JoanMaillard/Manette/04_Etude/2019/rapport de décision module Bluetooth.txt

MAILLARD Joan, KAHRIMANOVIC Adel
25.06.2019
P1704 Manette

Rapport de choix de protocole et de module Bluetooth:

Au choix: 
- Module Cypress en Bluetooth 4.1 en mode kiss
- Module Seeed en Bluetooth 2.0 + EDR avec appairage en dur
- ESP32 en Bluetooth 4.1 en mode appairage dur / Wifi 

Avantages du Cypress
- Appairage facile et rapide
- Data rate plus grand, permettant une marge pour la transmission des données supérieures (quoique notre utilisation reste faible)
- Faible consommation car en mode low energy

Désavantages du Cypress
- L'appairage Kiss présente une difficulté supplémentaire quant à la mise en place: il est possible que le module s'appaire avec le mauvais périphérique
- Le module et la devboard sont d'une taille non-négligeable
- Le module et la devboard sont basés sur une architecture ARM avec des Cortex-M0, et non avec des processeurs d'architecture AVR comme on les connaît.
- On pressent une probable incompatibilité des modules Cypress avec les autres à notre disposition
- Module Cypress cher

Avantages du Seeed
- Appairage solide, donc en cas de perte de connection, puis rentrée à portée à nouveau, elle est immédiatement rétablie, ou au moins retentée
- Data rate plus stable et portée légèrement plus grande
- Très petite taille et facilité d'utilisation (périphérique MOSI/MISO)
- Compatible Arduino sans interface spécifique

Désavantages du Seeed
- Bluetooth 2.0 avec EDR -> appairage plus compliqué / long à réaliser
- Data rate un peu plus faible, mais dans les limites du raisonnable (sans compter que notre utilisation est de toute façon faible)
- Consomme potentiellement un peu plus que le module en 4.1, mais avec une batterie de taille suffisante, ce problème disparaît.
- Occupe des pins MOSI/MISO de l'AtMega et le charge des capteurs ET des de la gestion du Bluetooth

Avantages de l'ESP
- Appairage solide
- Data rate très stable car 
- nous permet de déporter la communication de la lecture des éléments
- Module 4.1 SPP -> module half-duplex rapide pour la communication et technologie commune actuelle
- Architecture connue (AVR), comme les arduinos
- Permet de dédier la gestion de l'écran et des moteurs de rumble directement sans sacrifier de la réactivité sur l'arduino de data gathering

Désavantages de l'ESP
- Consommation d'énergie globale potentiellement plus grande (module dédié supplémentaire)
- Prend un peu de place, mais moins qu'un arduino appairé à un chip unique AtMega
- Occupe des pins MOSI/MISO de l'AtMega, sans en prendre plus pour autant

Notre choix se porte sur le module ESP.
