JoanMaillard/Manette/ESP32.pptx

## L’esp32

P1704 Adel Kahrimanovic et Joan Maillard

## Sommaire

- Qu’est-ce qu’un «ESP32»?
- Comparaison avec un Arduino Due
- Schéma de l’ESP32
- Questions?

## Qu’est-ce qu’un «ESP32»?

- L’ESP32 est un microcontrôleur
- Compatible avec l’IDE Arduino

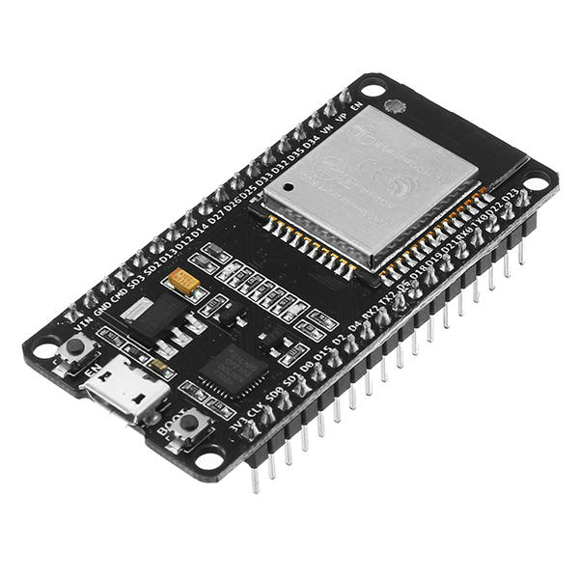
[picture p9: figure]

## Comparaison avec un Arduino Uno

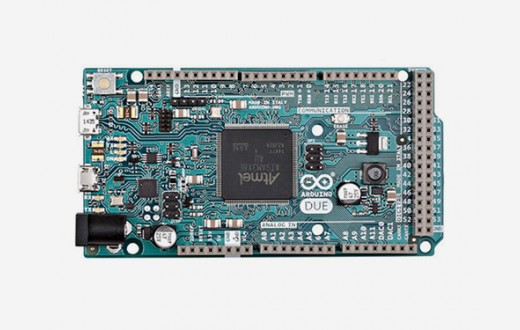
[picture p10: figure]

VS

## Comparaison avec un Arduino DUE

| ESP32 | Arduino Due
Tension de travail | +3,3V | +3,3V
Bluetooth et Wifi | Oui | Non
Unités de calcul | 2 | 1
Fréquence d’horloge | 160MHz | 84MHz
Pins ADC | 18 | 12
Pins DAC | 2 | 2
Prix (Conrad) | 12.- | 36.-

## SCHéma de l’esp32

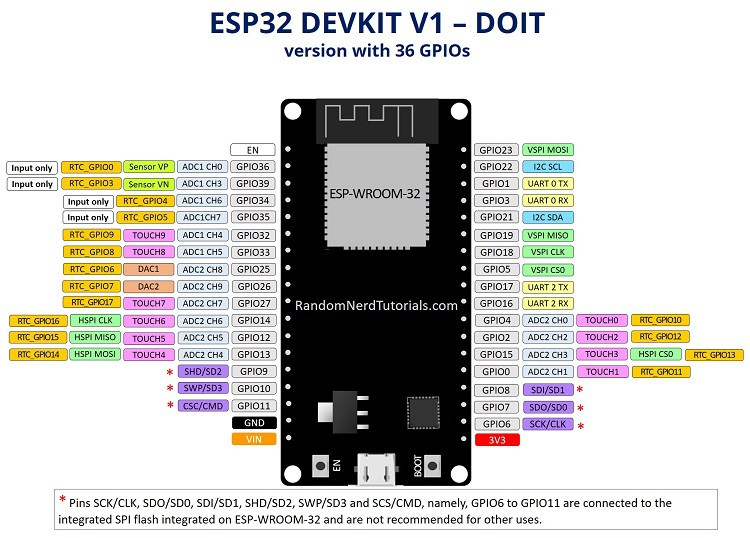
[picture p11: figure]

## Questions?
