JoanMaillard/Manette/04_Etude/Manette arcade.docx

CPNV

Manette arcade

P1704_Manettes

SANDOZ Pierre-Olivier PICOTTE Alexandre

01/07/2018

# Introduction :

Le code de la manette arcade se compose d’un code, qui gère les boutons appuyés (slave), à fournir aux manettes et d’un code à fournir à un arduino leonardo ou micro qui se charge de simuler un clavier lorsqu’il est branché à un ordinateur ou un raspberry (master). Les manettes ont le code qui gère les boutons, le code pour leonardo ou micro se charge de récupérer les données des manettes pour les convertir en touche de clavier pour pouvoir jouer à des jeux rétros, il s’agit de l’arduino de la « console ». La communication entre les arduinos se fait par I2C, par le biais de la libraire Wire.

# Header et communication I2C :

La communication se fait par I2C et pour vérifier que les différents arduinos reçoivent bien des instructions ou des requêtes nous avons ajouté un header au début de chaque communication. Celui-ci intervient comme un mot de passe que les arduinos doivent donner pour transmettre des informations, un arduino qui reçoit une communication va vérifier si les deux premières bytes correspondent au header choisi, si oui alors l’arduino traite les données qu’il reçoit si non il ignore ces données.

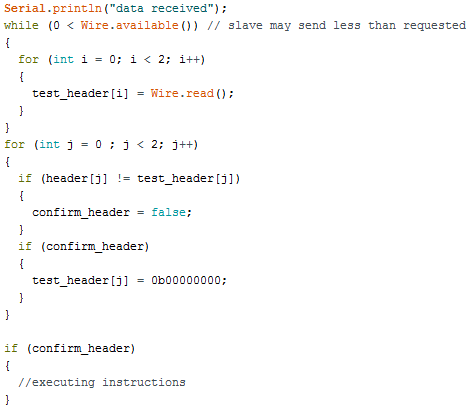
[picture p20: figure]

# Code Manette :

## Recherche d’addresse :

Lors de sa mise sous tension, l’arduino, dans lequel on a téléversé le code qui gère les boutons, va chercher à obtenir une adresse auprès de son master l’arduino de la console, tant qu’il n’a pas d’adresse il va envoyer en permanence une demande par I2C, il y à alors trois cas possibles :

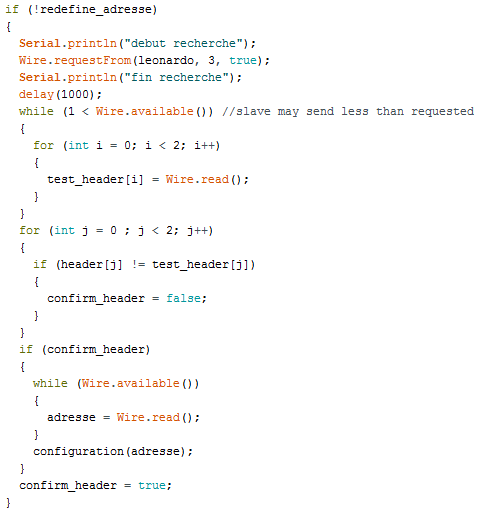
[picture p21: figure]

1. Le master ne répond pas, dans ce cas le slave va continuer à effectuer des demandes d’adresse
2. Le master lui donne une adresse de joueurs actifs, soit 1 soit 2, le slave refait alors son setup avec sa nouvelle adresse

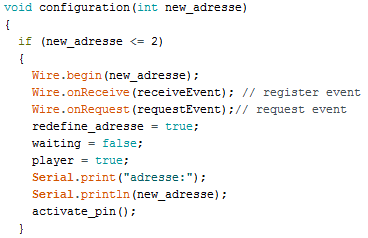
[picture p22: figure]

3. Le master lui donne l’adresse lorsqu’il y a trop de joueurs, le slave va alors arrêter de faire des demandes, Si une place se libère le master enverra un message au slave pour lui demander de refaire une demande d’adresse.

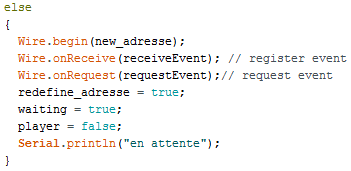
[picture p23: figure]

Ce n’est que lorsque le slave reçoit une adresse de joueurs actifs que le reste du programme va se lancer, notamment l’activation de ces inputs.

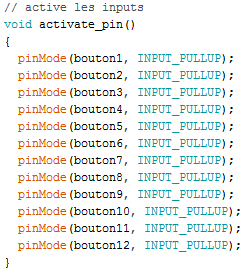
[picture p24: figure]

## Gestion des touches :

Lorsque l’arduino est un joueur actif, il va alors lancer le reste de son programme, qui consiste à attendre une demande du master pour regarder quelles sont ses boutons enclenchés.

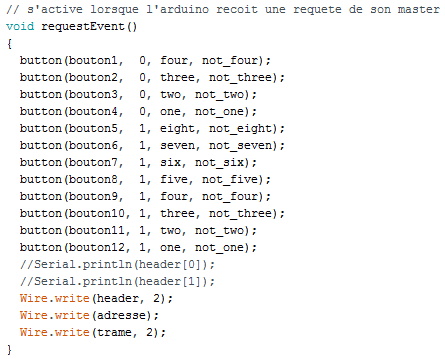
[picture p25: figure]

Lors d’une demande le slave va regarder chaque input déclaré et regarder si l’input est LOW ou HIGH, il va ainsi composer deux bytes d’informations qui contient les états de tous les boutons.

On n’a que 12 boutons donc on utilise que 12 bits, dans notre il s’agit des bits entourés en orange.

A chaque bit de chaque byte est assigné un bouton et selon son état le bit vaut 0 ou 1, 1pour appuyé sinon 0. Cette gestion se fait au moyen de la fonction button.

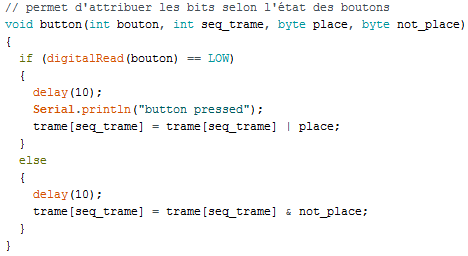
[picture p26: figure]

- bouton = quel bouton il faut regarder l’état
- seq_trame = s’il s’agit du premier ou deuxième byte de la trame
- place = aide pour mettre le bit désirer à 1 si bouton est LOW
- not_place = aide pour mettre le bit désirer à 0 si bouton est HIGH

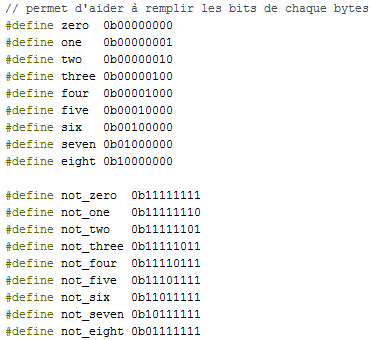
[picture p27: figure]

# Code console :

Le code console va s’occuper de gérer les joueurs, demander aux slaves l’état de leurs boutons ainsi que simuler un clavier et transmettre des touches de clavier selon l’état des boutons des joueurs

## Attribution d’adresse :

Le code du master ne commence réellement que lorsqu’il enregistre au moins un joueur, donc lors de sa mise sous tension il va attendre une demande d’un slave pour lui transmettre une adresse, s’il y a déjà trop de joueurs alors le master va mettre les joueurs de trop en attente et lorsqu’une place se libère leur enverra un message pour leur demander de refaire leur demande d’adresse. Les joueurs actifs ont les adresse 1 et 2. L’attribution d’adresse passe par la fonction requestEvent.

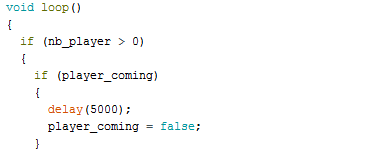
[picture p28: figure]

…

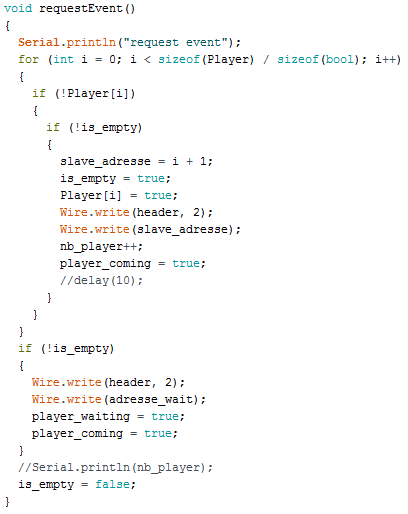
[picture p29: figure]

## Requête au slave :

Dès que le master a au moins un slave il va alors émettre des requêtes auprès du slave pour lui demander l’état de ses boutons. Le master va procéder par étapes il va d’abord regarder dans liste de joueurs actifs et envoyé une requête à chacun.

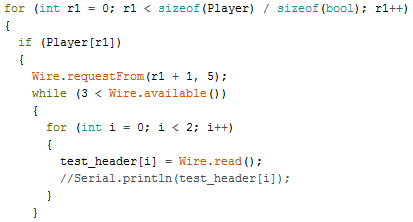
[picture p30: figure]

Le master va ensuite vérifier si les deux premières bytes reçues correspondent au header choisi, si oui il va traiter les données reçues si non il va effacer le joueur de son registre de joueurs actifs et s’il y a des joueurs en attente leur enverra un message pour les prévenir qu’une place c’est libéré.

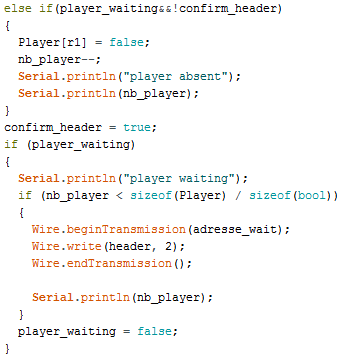
[picture p31: figure]

## Détermination touches clavier :

Le master va lire chaque bit de chaque byte pour déterminer l’état des boutons des slaves. Chaque bit de chaque byte de chaque joueur à une touche de clavier attribué ainsi si un bouton est pressé alors la touche de clavier attribué sera aussi pressée par le master jusqu’à l’information que le bouton a été relâché.

C’est la méthode despair qui s’en charge.

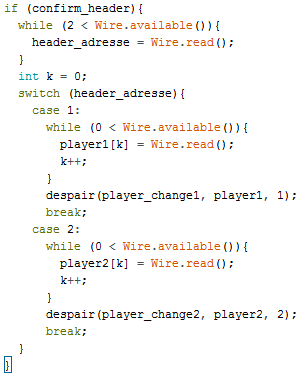
[picture p32: figure]
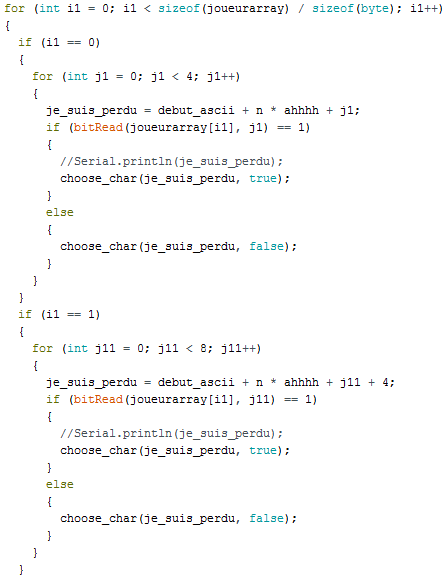
[picture p33: figure]

Despair permet de determiner un nombre selon le bit identifier, qui grace à choose char permet d’obtenir une touche du clavier

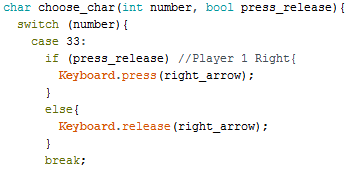
[picture p34: figure]

Il convient de faire attention aux touches de clavier choisie, car dans le cas d’une majuscule le leonardo fera d’abord un shift suivi de la lettre voulue ainsi lorsqu’il faudra configurer un émulateur la touche attribué ne pourra être que shift

# Piste d’amélioration :

Il convient d’abord de faire remarquer que la communication I2C n’est pas faite pour de grandes distances et doit se partager entre les différents arduinos, il est alors préférable alors de changer de moyen de communication, par du bluetooth par exemple. Il peut être aussi envisager de changer la nature de la connexion entre l’ordinateur et le leonardo, pour l’instant le leonardo se fait passer pour un clavier mais on peut imaginer changer pour que le leonardo soit considérer comme un gamepad et dans ce cas là ou peut imaginer avoir un leonardo dans chaque manette qui serait relier à l’ordinateur

Manette arcade
