JoanMaillard/Manette/04_Etude/Trame.docx

CPNV

Trame de communication

P1704_Manettes

PICOTTE Alexandre SANDOZ Pierre-Olivier

15/06/2018

# Introduction :

L’état actuelle du code de la manette contient trois trames, qui ne peuvent être activés simultanément. Chaque trame est envoyée au moyen de la librairie PJON. Le code laisse le choix de la trame, selon la trame choisie l’arduino n’envoie pas les mêmes informations. Pour sélectionner la première ou la seconde trame, il suffit de mettre « TRAME » à 1 pour la première et à 0 pour la deuxième. La troisième trame envoie des messages, elle résulte d’une demande spécifique de la part du groupe « chevaliers et dragon », elle sera détaillée plus bas.

Il est important de noter que la libraire PJON envoie seulement des tableaux de charactères, rien d’autres.

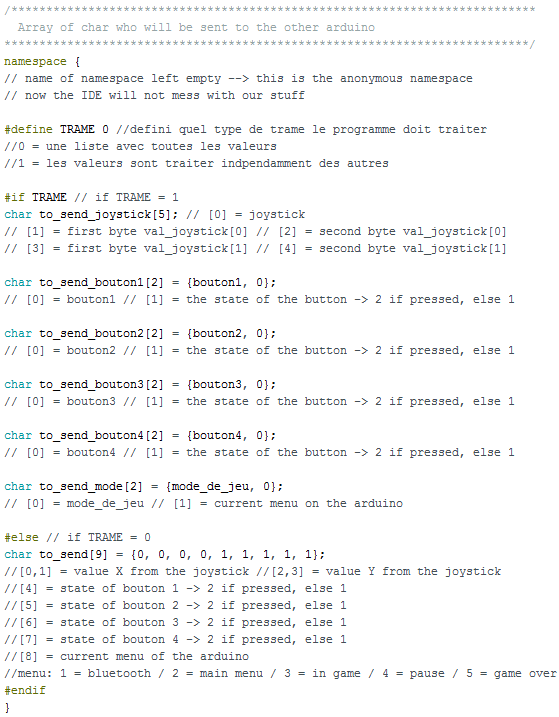
[picture p35: figure]

# Première trame :

## Envoi de données :

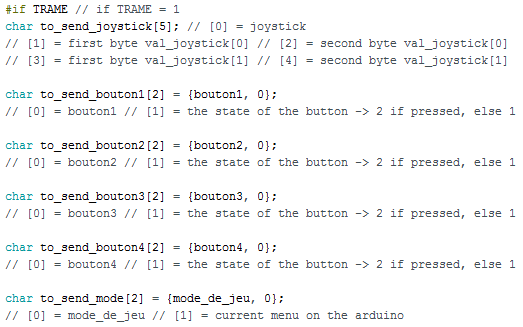
[picture p36: figure]

La première méthode qui est active que lorsque « TRAME » vaut 1, envoie les informations indépendamment des autres. L’arduino ne communique pas toutes les informations relatives à ses inputs et à son mode actuelle lorsqu’il envoie des données, l’arduino transmet que les informations qui ont changé d’un cycle à l’autre.

Le tableau suivant concerne les adresses attribuées :

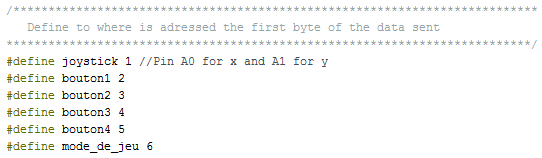
[picture p37: figure]

La première valeur de chaque tableau contient l’adresse à laquelle la donnée doit être enregistrée. Selon cette valeur l’arduino qui réceptionne les données peut déterminer à quelle variable enregistrer le changement.

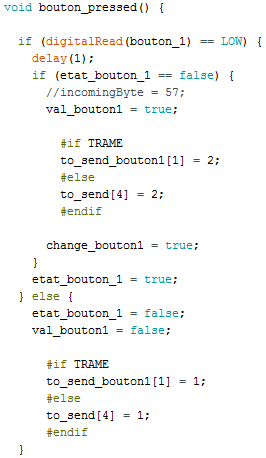
[picture p38: figure]
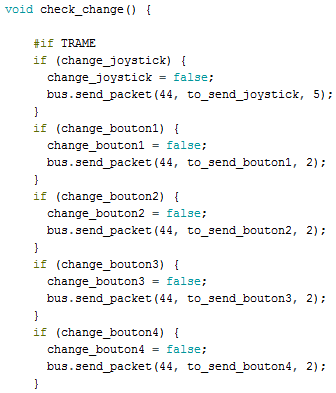
[picture p39: figure]

Lorsque l’arduino détecte un changement, il va remplir le tableau correspondant avec les nouvelles valeurs puis l’envoyé ; par exemple si l’arduino détecte que le bouton 1 est appuyé, alors il va modifier le tableau correspondant au bouton 1, dans ce cas la deuxième valeur du tableau « to_send_bouton1 », puis l’arduino communiquera seulement ce tableau à l’autre arduino. Le choix de la valeur représentant l’état des boutons a été attribué arbitrairement, 2 pour symboliser que le bouton est pressé sinon 1.

Pour le joystick, l’arduino stocke lors de son setup la première valeur de l’axe X et Y qu’il lit, ces deux valeurs deviennent alors des valeurs de base qui servent à déterminer s’il y a eu un changement, en comparant les valeurs actuelles aux valeurs de base

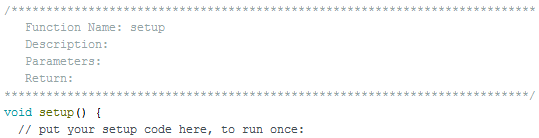
[picture p40: figure]
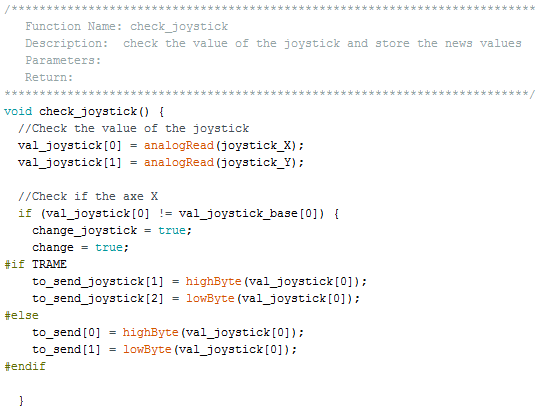
[picture p41: figure]

Les valeurs des joysticks sont stockées dans des integers mais comme on peut que faire transiter des tableaux de charactères il faut séparer les valeurs des axes en deux bytes chacun pour les enregistrer dans des charactères.

## Réception des données :

La réception de donnée s’effectue au moyen de la fonction « receiver_function » de la librairie PJON.

Dans le code actuel nous utilisons seulement le tableau payload.

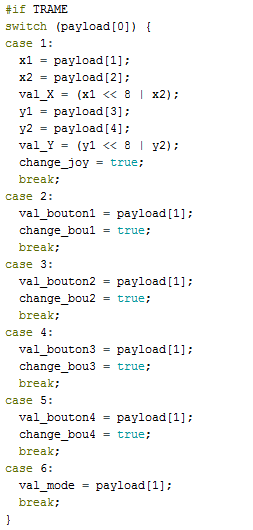
[picture p42: figure]

Comme la première valeur de chaque tableau envoyé représente l’adresse, il est aisé de trier les données reçus. Il suffit alors de stocker les données dans les variables allouées et d’indiquer un changement dans les informations réceptionnées.

Les boutons ne nécessitent pas d’opérations autre qu’enregistrer la valeur reçue contrairement au joystick. Les valeurs X et Y du joystick sont des integers, il convient alors de séparer les deux bytes de l’integer pour enregistrer chaque byte dans un charactère, highByte et lowByte le permette facilement. Puis une fois envoyés il faut reformer l’integer, il est à noter que les variables charactère sont signed ainsi pour éviter d’avoir des valeurs négatives quand on lit les données reçues il faut enregistrer les deux charactères dans des unsigned charactère.

Ainsi chaque tableau est composé d’une adresse et d’une donnée représentant la valeur de l’input. L’adresse sert à l’arduino réceptionnant les données pour savoir à qui est attribué la valeur de la deuxième entrée du tableau.

# Deuxième trame :

## Envoi de données :

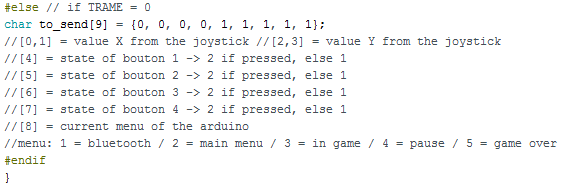
[picture p43: figure]

La deuxième méthode consiste à envoyer toutes les données. Cette méthode ne nécessite plus d’adresse, car l’arduino réceptionnant les données à besoin de recevoir qu’un seul tableau, il ne reste alors qu’à préciser dans quelles variables enregistrer ces valeurs,

Cette méthode envoie un unique tableau composé de toutes les valeurs des inputs et du menu actuel, chacune de ces valeurs sont attribuées une place précise dans le tableau à envoyer : les deux premières entrées sont pour l’axe x du joystick, les deux suivantes pour l’axe y, la cinquième entrée est réservée au bouton 1, la sixième au bouton 2 et ainsi de suite, la dernière entrée est attribuée au menu de l’arduino. L’arduino qui reçoit les données peut alors attribuer les valeurs du tableau reçu à ses variables.

L’arduino envoie les données que lorsqu’il détecte un changement, que ce soit les boutons, le joystick, les changements de menu sont traités indépendamment et sont envoyés lorsque l’arduino configure le nouveau menu.

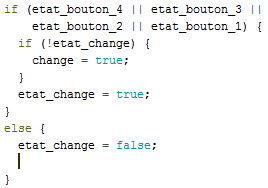
[picture p44: figure]
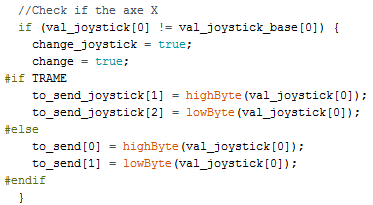
[picture p45: figure]

Ainsi lorsque la variable change passe à true l’arduino enverra un tableau de charactère contenant les nouvelles valeurs.

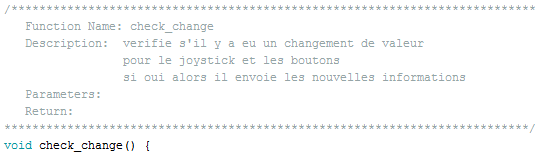
[picture p46: figure]

…

## Recetion des données :

Comme expliqué plus haut l’arduino recevant les données doit juste trier les données, chaque entrée du tableau reçu est attibué à une variable.

…

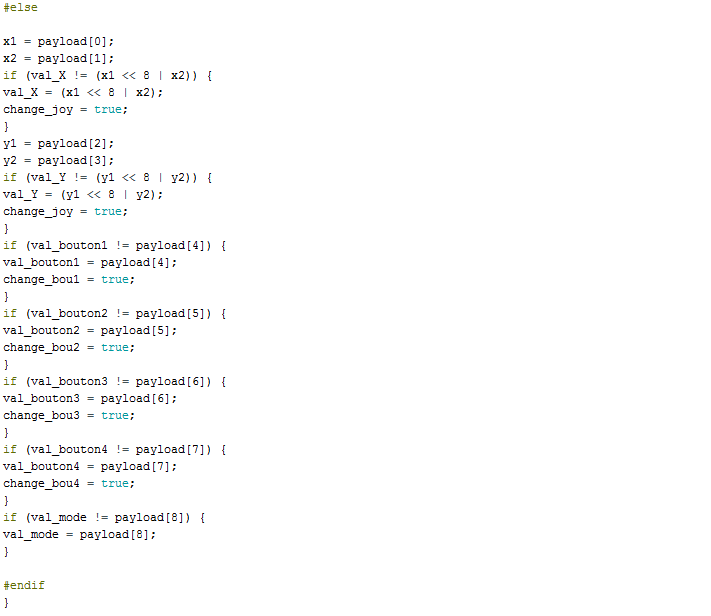
[picture p47: figure]

La première méthode permet de limiter les informations envoyées, afin d’éviter que l’arduino communique des données superflues, la deuxième méthode permet de s’affranchir des adresses et de nos craintes que l’arduino perde un des packet à envoyer.

# Troisième trame :

Cette troisième trame résulte d’une demande du groupe « chevaliers et dragon ». Contrairement aux deux trames précédentes, celle-ci n’envoie pas à proprement parler de données, il ne s’agit pas de tableau à lire pour extraire les états des boutons. Cette trame envoie un message selon les informations de l’arduino, c’est-à-dire qu’il envoie des informations spécifiques à son état :

Il y a 4 adresses :

- 0 pour « Game »
- 1 pour « Contact »
- 2 pour « Motors »
- 3 pour « Head »

Adresse | Donnée | Description
0 | ConRequest | Permet de savoir si le Bluetooth est bien connecté
| Pause | Indique que le mode Pause est activé.
| Restart | Indique que le mode Pause est désactivé
| Over | Indique que la partie est perdue
1 | ShieldUp | Activation du bouclier
| ShieldDown | Désactivation du bouclier
| SpecialUp | Activation de l’attaque spéciale
| SpecialDown | Désactivation de l’attaque spéciale
2 | x | Position X du joystick
| , | Séparation entre X et Y
| y | Position Y du joystick
3 | LoseLife | Perte de point de vie
| GainLife | Gain de point de vie

Les cellules en gris signifient que la donnée n’est pas utilisée dans la version de 2018 du projet P1631.
Les cellules en bleu signifient que la donnée est ajoutée pour la version 2018 du projet.

Le but étant de pouvoir implémenter la libraire PJON au protocole de communication réalisé par le groupe « chevaliers et dragon ». Malheureusement même si la trame n’a aucun problème à être envoyer et lu, le manque de connaissance du code du robot et le manque de temps font que la trame a peu d’utilité.

## Envoi de donnée :

Les données à envoyer sont des chaines de charactères composé d’une adresse et de lettres

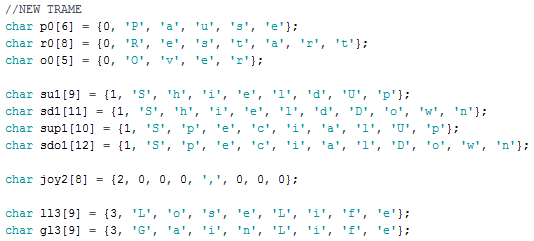
[picture p48: figure]

Ces données sont à envoyer à des moments spécifiques, il ne s’agit plus d’envoyer seulement des données sur l’état des boutons ou la valeur du joystick mais des informations spécifiques au code chevalier.

Pour le joystick il a fallu convertir des integers en chaine de lettres, non pas comme dans la trame 1 et 2 où il s’agissait de rentrer un integer dans deux charactères.

Ce bout de code sert à convertir des integer en chaine de charactère. Pour ce faire on utilise des String qui vont servir de « passerelle ». On commence par créer une chaine de caractère vide de taille 4, puis on crée une String dans laquelle on met notre integer. Ensuite on utilise la fonction toCharArray pour transformer la valeur en charactère, attention la chaine de caractère doit posséder un espace vide pour la null-terminaison.

## Réception des données :

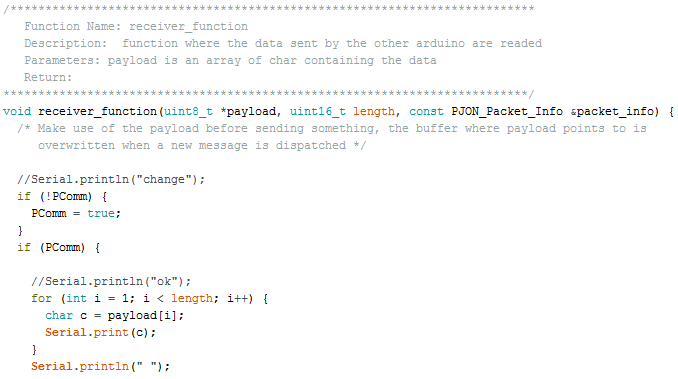
[picture p49: figure]

Ce code n’enregistre pas de donnée il écrit simplement le texte qu’il a reçu.

Trame de communication
