JoanMaillard/Manette/04_Etude/2019/rapport de décision batteries_tableaux.xlsx

Piles
Haute densité d'énergie | Usage unique
Facilement accessible | Fort taux d'autodécharge
 | Coûteux et peu pratique
Accus NiMh
Rechargeable | Mauvaise autonomie
Tension stable | Basse densité d'énergie
 | Basse tension
 | Lourd
Accus LiIon
Rechargeable | Nécessite de la protection
Haute densité d'énergie | Compliqué à mettre en place
Systèmes de gestion faciles à trouver
Faible autodécharge
Forte autonomie
Léger
Longue endurance
