JoanMaillard/Manette/04_Etude/2019/rapport de décision module bluetooth_tableaux.xlsx

Module Cypress
Appairage facile et rapide | Appairage KISS, moins pratique
Data rate grand (mais faible utilisation) | Module et devboard de grande taille
Faible consommation car BLE | Architecture ARM/Cortex M0
 | Cher
Module Seeed
Appairage solide, se réengage | Bluetooth 2.0 EDR -> appairage long
Datarate stable | Consomme plus que le module 4.1
Très petit | Charge l'AtMega de la communication BT
Compatible Arduino
ESP32
Appairage solide, mais peut être rendu modulaire | Consommation potentiellement plus grande
modulaire | Prend un peu de place
Data rate très stable | Fonctionne en 3.3v
Nous permet de déporter la comm
Module 4.2 SPP -> bidirectionnel
Architecture AVR
Gestion des moteurs et écran déporté
