JoanMaillard/Manette/01_Administratif/README.txt

Index des termes et des documents liés

- Manette breadboard:
	- Etude/Manette breadboard
	- Schémas/manette_2019
	- Dessins/manette_breadboard_overview
	- Dessins/Diagramme_fonctionnel
	- Dessins/Diagramme_communication
	- Dessins/Sous-diagramme BT

- Manette universelle
	- Schémas/manette_2019
	- Dessins/manette_breadboard_overview
	- Dessins/Diagramme_fonctionnel
	- Dessins/Diagramme_communication
	- Dessins/Sous-diagramme BT

- Plan de projet MSProject
	- Définition des éléments
		- Rapport de décision écran
		- Bulletins de commande correspondants
		- Les boutons ont été choisis selon des critères de prix, de confort tactile 
		  (des boutons similaires existent déjà sur les versions précédentes du projet) et de disponibilité. 
		  Aucun autre critère n'a été pris en compte.

- Documentation consultée et retenue: voir Etude/résumé

- Info ESP32: Si la commande Serial.begin(int) est utilisée et que des messages sont envoyés au Serial, il faut IMPERATIVEMENT brancher l'ESP32
par USB. Pour le faire fonctionner de façon autonome, passer en commentaire toutes les instructions Serial est impératif.
