JoanMaillard/Manette/01_Administratif/Schémas-Bloc/ReadMe.txt

Ouvrir le fichier .xml sur https://www.draw.io/ pour accéder à l'éditeur de schémas
Ou sur l'application de bureau du même nom
