JoanMaillard/Manette/GitHub.pptx

## Git

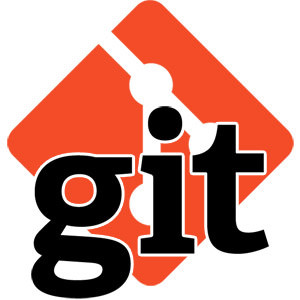
[picture p68: figure]
Résultat de recherche d'images pour "git"
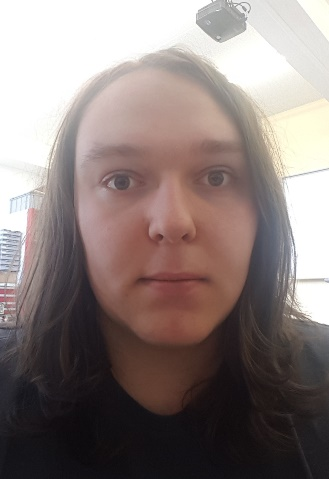
[picture p69: figure]

Joan Maillard

Adel Kahrimanovic

Présentation GitHub / Joan Maillard et Adel Kahrimanovic

## Sommaire

- Git, qu’est-ce que c’est?
- Git, comment ça fonctionne?
- Github
- Questions
- Sources

## Git, qu’est-ce que c’est?

Git

- Créé en 2005 par Linus Torvalds
- Logiciel libre de gestion de versions
  - Possibilité de voir les modifications d’un fichier apportées par un tierce
  - Création de «points de sauvegardes» (snapshots) à chaque modification, ainsi toutes les versions antérieures sont accessibles

## Git, qu’est-ce que c’est?

- Terminologie
  - Dépôt
    - Dépôt de travail
    - Dépôt de mémoire
  - Système de branches
    - Branche locale
    - Branche courante

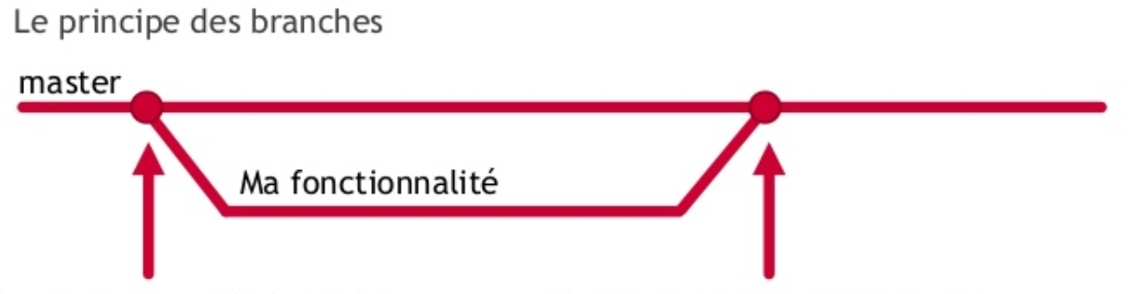
[picture p70: figure]

## Git,comment ça fonctionne?

- Commandes principales
  - Git clone:
    - Permet de copier tout les fichiers de la branche courante à la branche locale
  - Git fetch:
    - Compare les fichiers de la branche locale avec celle la branche courante et indique les différences entre celles-ci
  - Git pull:
    - Récupère les modifications appliquées de la branche courante à la branche locale
  - Git merge:
    - Fusionne les modifications apportées par Git pull avec la branche locale

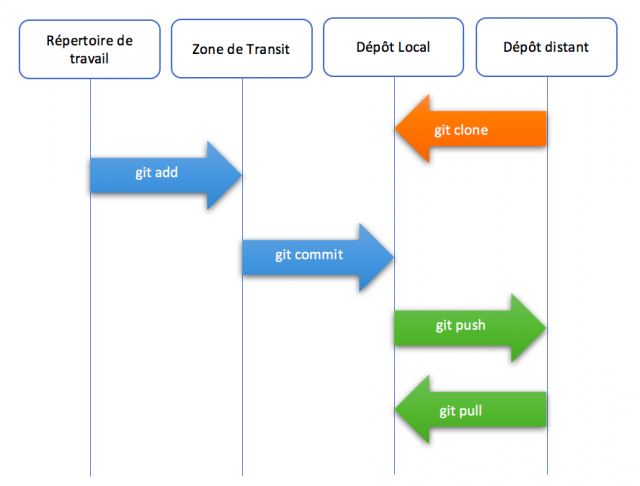
[picture p71: figure]

## Git, comment ça fonctionne?

  - Git commit:
    - Liste les modifications effectuées, possibilité de choisir les fichiers qu’on souhaite mettre à jour sur la branche courante
  - Git push:
    - Envoie les modifications du Git commit de la branche locale à la branche courante
  - Git stash:
    - Enregistre les derniers changements locaux et les annule au profit de la branche courante

## Git, comment ça fonctionnne?

- .gitignore
  - Liste formatée des fichiers à ignorer
    - Exemple: *.docx banana*.bin cahierdescharges.docx
- Git merge, précision:
  - Git fonctionne en ligne par ligne avec des fichiers texte, les merges conflictuels se font à la main.
- Petites commandes gérées par l’interface utilisateur

## Github

  - Stockage dans un cloud
  - Gratuit dans le cadre d’un développement open source (public)
  - Immense communauté, 28 millions d’utilisateurs
  - Interface graphique
  - Gestion des tickets (issues) pour les comptes payants

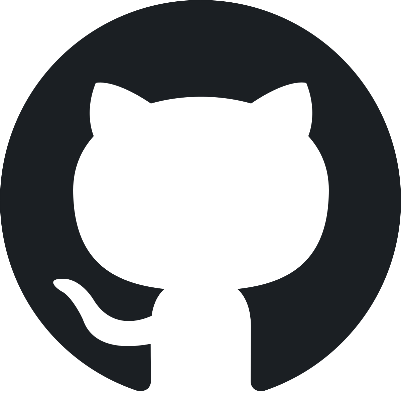
[picture p72: figure]
Résultat de recherche d'images pour "github logo"

## Questions?

## Sources

- https://github.com/ (https://github.com/)
- https:// (https://fr.wikipedia.org/wiki/Git)fr.wikipedia.org/wiki/Git
- https://www.supinfo.com/articles/single/4370-git-prise-main-rapide
