JoanMaillard/Manette/Presentation_manette_2019.pptx

## Projet manette 2019

Projet manette 2019 Joan Maillard et Adel Kahrimanovic

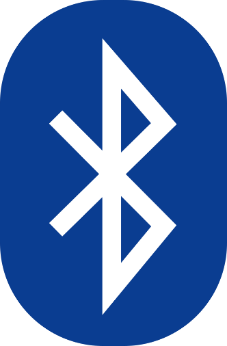
[picture p73: figure]
Résultat de recherche d'images pour "bluetooth"
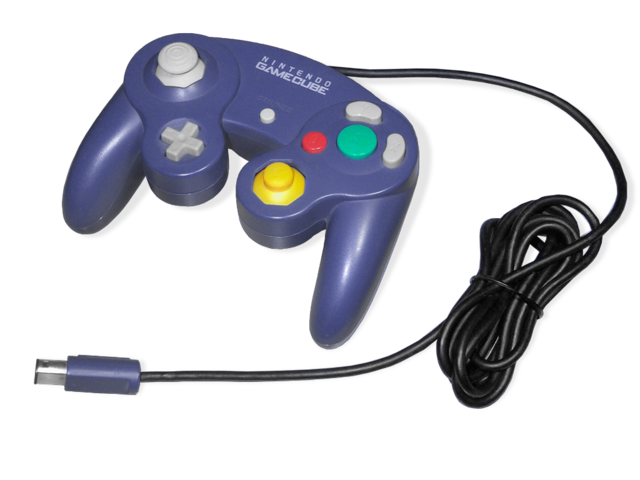
[picture p74: figure]
Résultat de recherche d'images pour "gamecube"

Joan Maillard

Adel Kahrimanovic

## Sommaire

- Objectifs
- Difficulté(s)
- Questions?
- Sources

## Objectifs

- Fabriquer une manette similaire à celle de la gamecube
  - Communique par Bluetooth
  - 1 écran pour pouvoir gérer les différents paramètres du système qu’on veut piloter
- Modifier les manettes de la console arcade de la classe T135 pour permettre la communication via Bluetooth

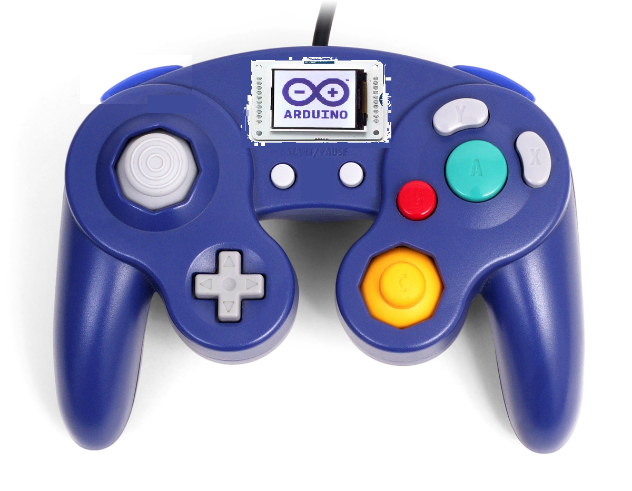
[picture p75: figure]

## Difficultés

- Etablissement de la communication Bluetooth
- Optimisation de l’espace pour obtenir une manette légère et confortable

## Questions?

## Sources

- https:// (https://fr.wikipedia.org/wiki/Fichier:Bluetooth.svg)fr.wikipedia.org/wiki/Fichier:Bluetooth.svg
- https://commons.wikimedia.org/wiki/File:GameCube_Controller.png
