JoanMaillard/Manette/04_Etude/TEMPLATE_Procédure.docx

CPNV

Template

P1704_Manettes

PICOTTE Alexandre

20/04/2018
