JoanMaillard/Manette/01_Administratif/Réunions/27-03-2018_ Revue_de_Projet.docx

# PV – Revue de projet

27.03.2018

# Présents :

PICOTTE Alexandre

SANDOZ Pierre-Olivier

CORNU Alexis

LOCATELLI Mark
