JoanMaillard/Manette/P1704_Manette.pdf

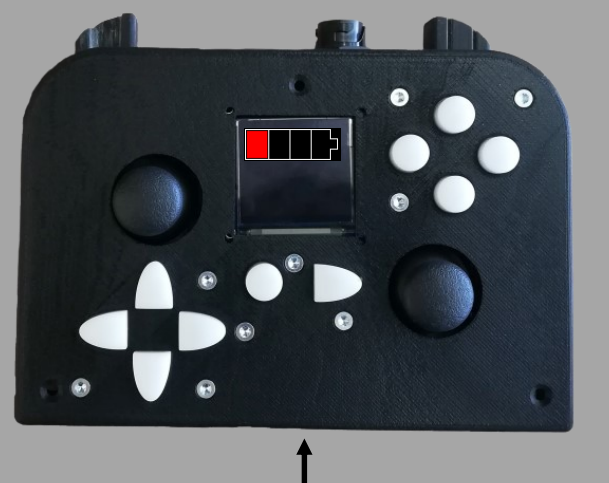
[picture p78: figure]

Objet à contrôler

Retour visuel, auditif

( écran,haut-parleur,vibrations)

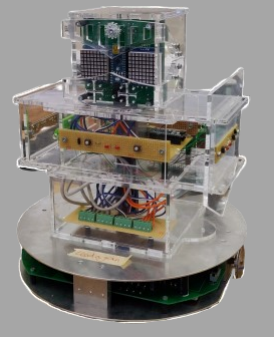
[picture p79: figure]
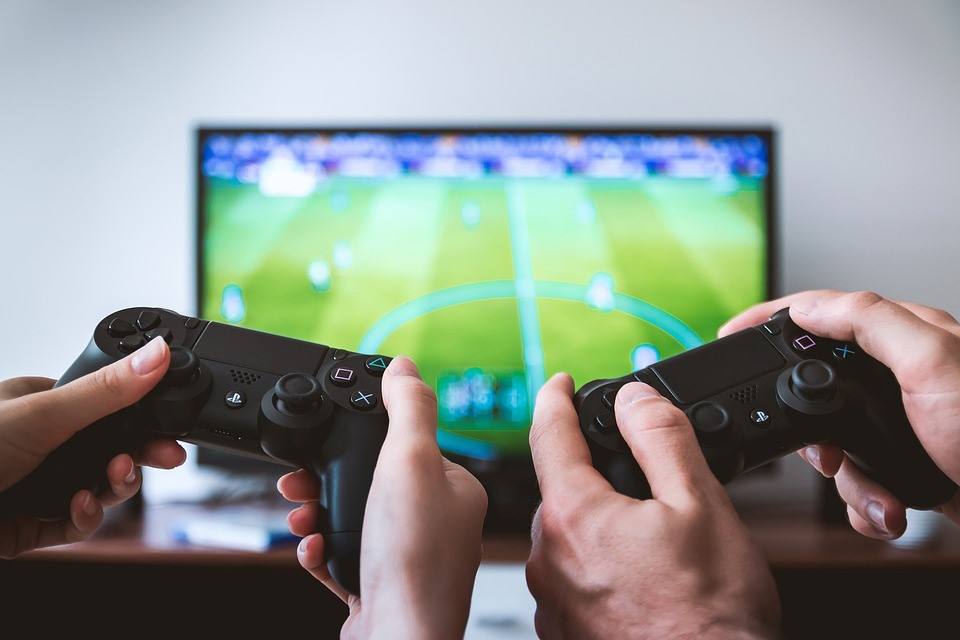
[picture p80: figure]
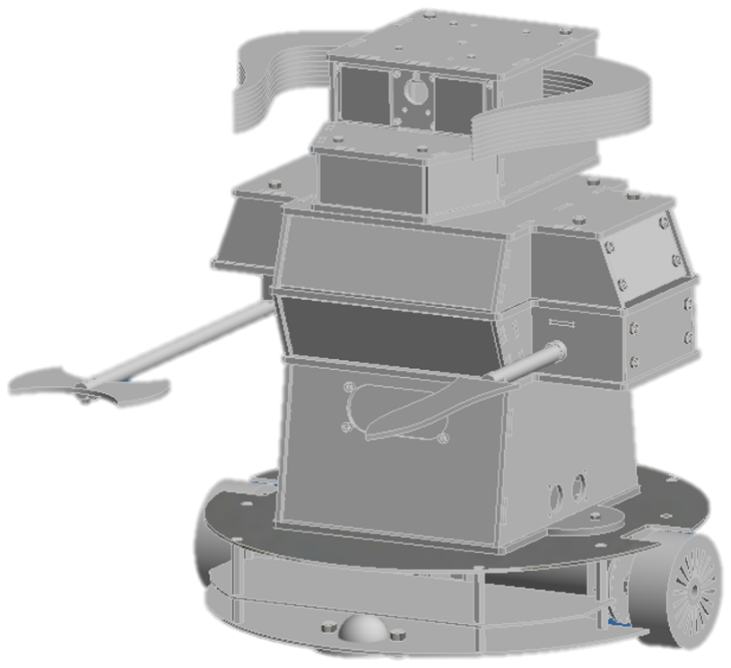
[picture p81: figure]
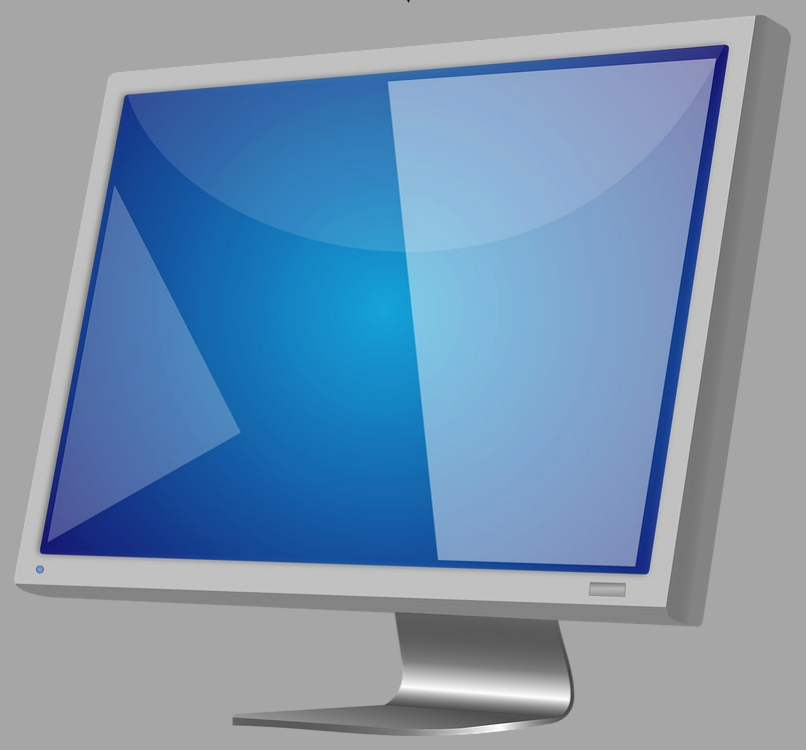
[picture p82: figure]

Robots | Gaming

P1704

KAHRIMANOVIC Adel

Maillard Joan

26.06.2019

Envoi de l’état des boutons (pressés ou non)

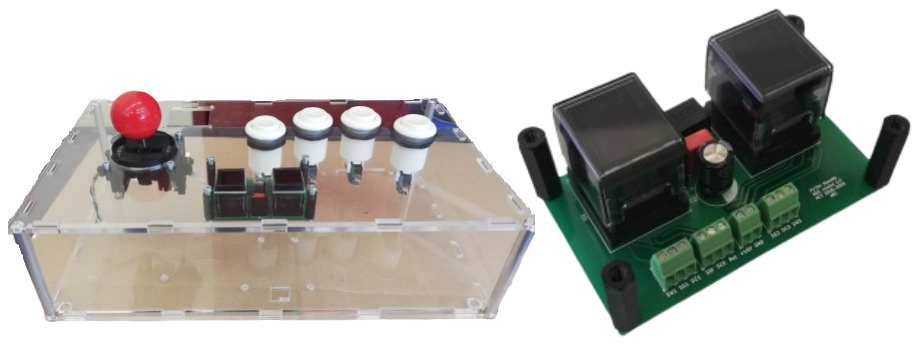
[picture p83: figure]

Minotaure du projet P1631

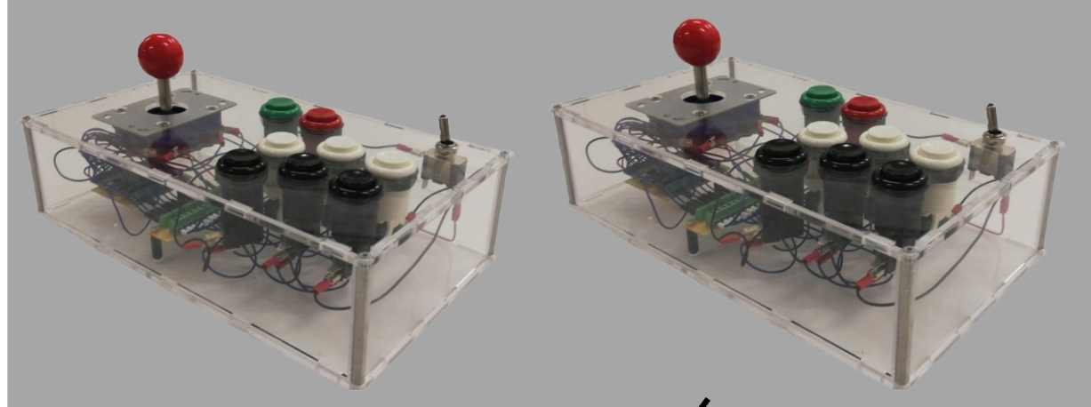
[picture p84: figure]

Envoi de l’état des boutons

(pressés ou non)

Sans retour

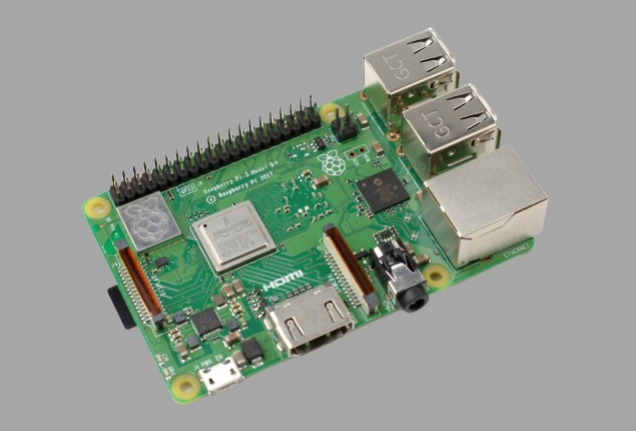
[picture p85: figure]

HDMI

Console Arcade

(Raspberry Pi 3B+)

La manette Universelle | La manette Minotaure | La console Arcade

Boutons avec un
écran intégré

Manettes de la console Arcade

Retour visuel,

( écran)

Envoi de l’état des boutons

(pressés ou non)
