JoanMaillard/Manette/03_DocTech/Connecteur Grove 6 pôles.pdf

Artikel-Nr.: 741435
Bez.: Stiftwanne 6-polig, Raster 2,54 mm, vergoldete Kontakte, gerade Ausführung ohne Verriegelung

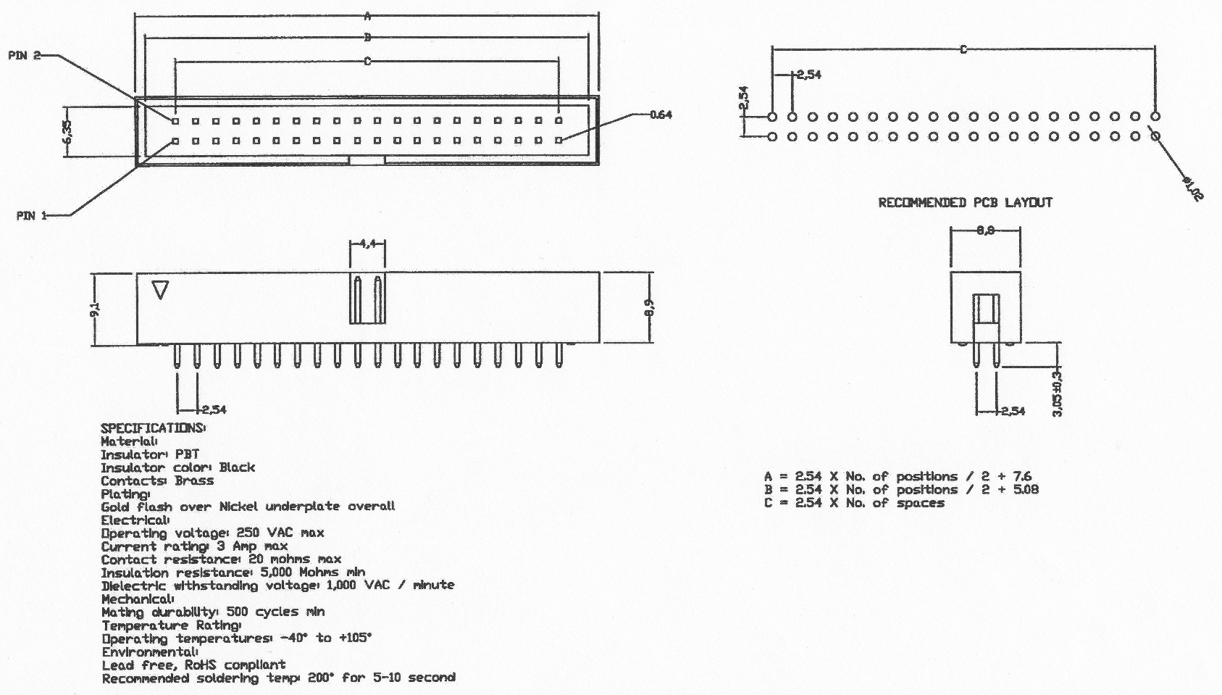
[picture p86: figure]

# www

Technische Änderungen vorbehalten.

# .bkl-electronic.de

Ausführungen können variieren. Sollten Sie ein Muster benötigen kontaktieren Sie uns bitte.

BKL-ELECTRONIC Kreimendahl GmbH • Märkenstück 14
Tel: +49 (0)2351-3621-0 • Fax: +49 (0)2351-3621-29 • info@bkl-electronic.de
- 58509 Lüdenscheid
