JoanMaillard/Manette/03_DocTech/ZippyyStick.pdf

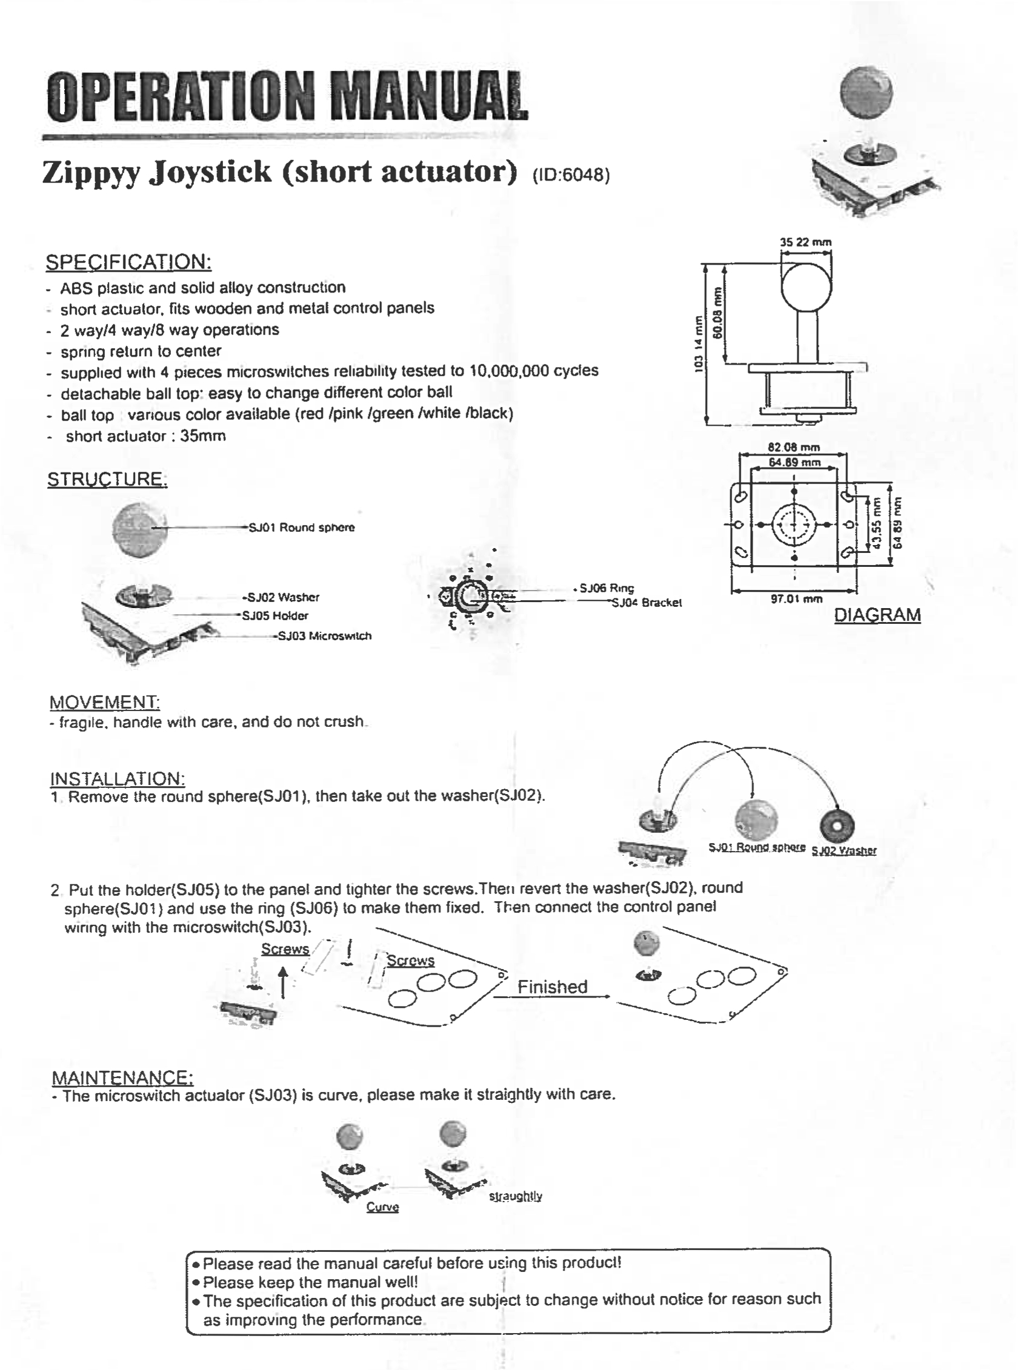
[picture p87: page 1]
