JoanMaillard/Manette/06_Dessins/Polyanette Chevalier/NKK Switch AS11CH/AIS2015/AS11CH.pdf

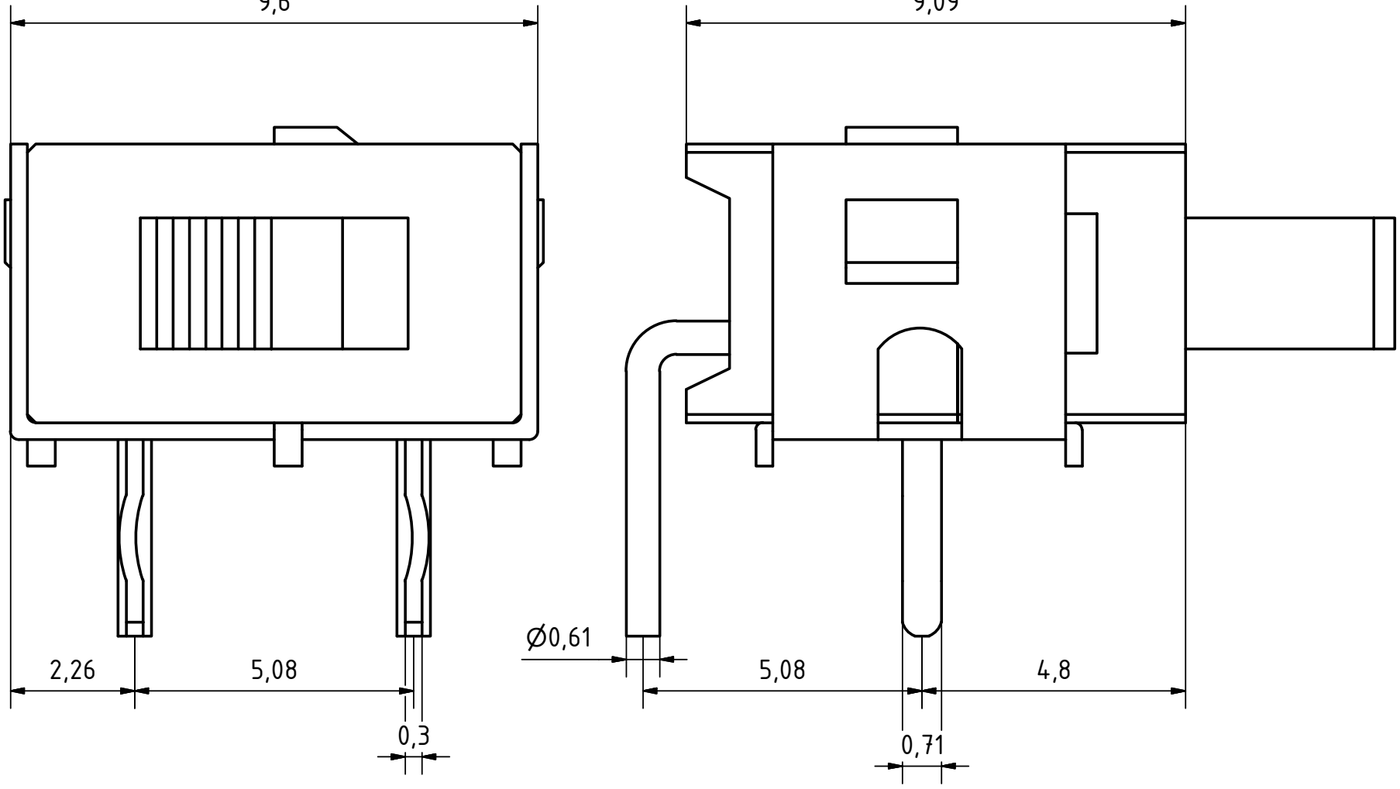
[picture p90: figure]
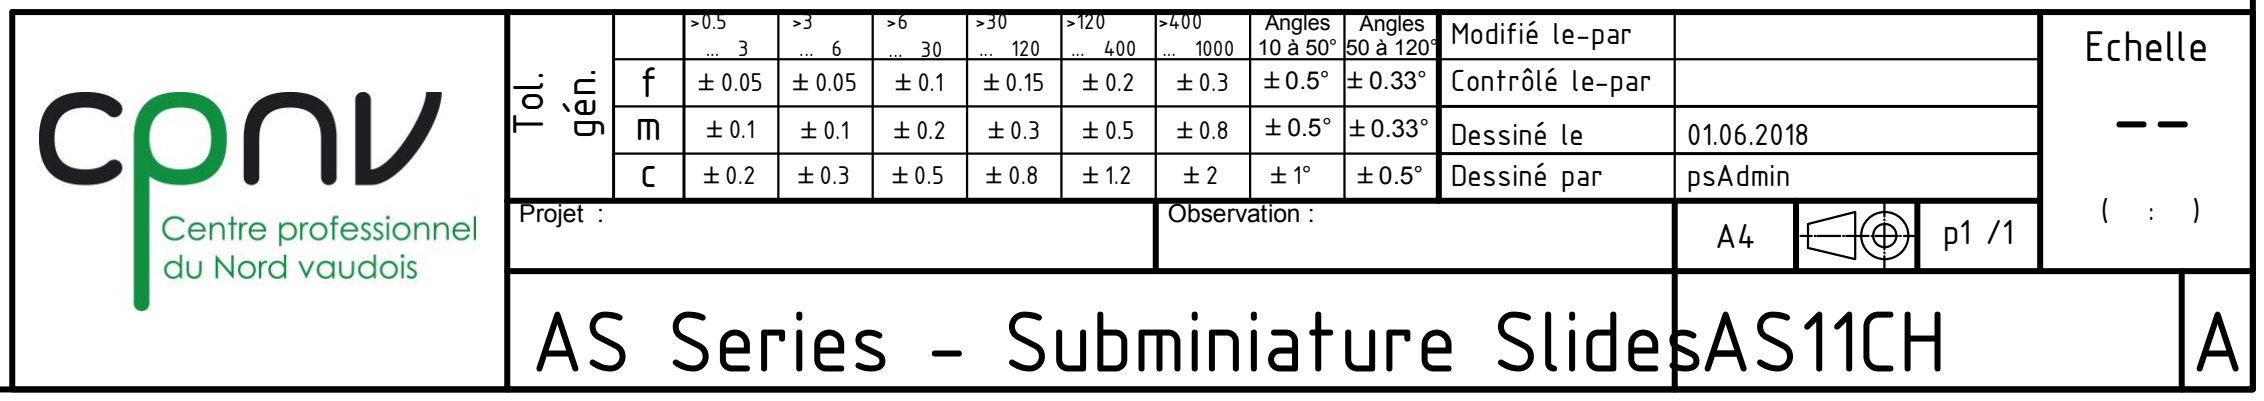
[picture p91: figure]
Tol.; Angles; Echelle; Observation :; Projet :; Modifi le-par; Angles 10 j 50°; AS Series - Subminiature Slides-

f | B0.05 | B0.05 | B0.1 | B0.15 | B0.2 | B0.3 | B0.5° | B0.33° | Contr§l le-par
m | B0.1 | B0.1 | B0.2 | B0.3 | B0.5 | B0.8 | B0.5° | B0.33° | Dessin le | 01.06.2018
c | B0.2 | B0.3 | B0.5 | B0.8 | B1.2 | B2 | B1° | B0.5° | Dessin par | psAdmin
9,6 | 9,09
