JoanMaillard/Manette/10_Rapports/TM_projet.xlsx

Sheet: Classeur 1
 | Administratif |  | 1
 |  | Classeur n°1
 | Commandes |  | 2
 |  | Classeur n°1
 | Documentation technique |  | 3
 |  | Classeur n°1
Filière d'automatique | Etude |  | 4
1400 Yverdon
 |  | Classeur n°1
 | Liste de pièces |  | 5
 |  | Classeur n°1
 | Dessins |  | 6
 |  | Classeur n°1
 | Schémas |  | 7
 |  | Classeur n°1
P1704 | Programmes |  | 8
Manettes
 |  | Classeur n°1
 | Mise en service |  | 9
 |  | Classeur n°1
2018-06-30 | Fiches de travail |  | 10
 |  | Classeur n°1
 | Photos |  | 11
PICOTTE Alexandre |  | Classeur n°1
SANDOZ Pierre-Olivier | Présentation |  | 12
Alexandre.PICOTTE@cpnv.ch
Pierre-Olivier.SANDOZ@cpnv.ch
 |  | Classeur n°1
 | Ne pas modifier
2018-03-27 |  | 1
 |  | 1
 |  | 1
 |  | 1
 |  | 1
 |  | 1
 |  | 1
 |  | 1
 |  | 1
 |  | 1
 |  | 1
 |  | 1
 |  | 1

Sheet: Classeur 2
 | Administratif |  | 1
 |  | Classeur n°1
 | Commandes |  | 2
 |  | Classeur n°1
 | Documentation technique |  | 3
 |  | Classeur n°1
Filière d'automatique | Etude |  | 4
1400 Yverdon
 |  | Classeur n°1
 | Liste de pièces |  | 5
 |  | Classeur n°1
 | Dessins |  | 6
 |  | Classeur n°1
 | Schémas |  | 7
 |  | Classeur n°1
P1704 | Programmes |  | 8
Manettes
 |  | Classeur n°1
 | Mise en service |  | 9
 |  | Classeur n°1
43281 | Fiches de travail |  | 10
 |  | Classeur n°1
 | Photos |  | 11
 |  | Classeur n°1
SANDOZ Pierre-Olivier | Présentation |  | 1900-01-11
Alexandre.PICOTTE@cpnv.ch
 |  | Classeur n°1

Sheet: Classeur 3
 | Administratif |  | 1
 |  | Classeur n°1
 | Commandes |  | 2
 |  | Classeur n°1
 | Documentation technique |  | 3
 |  | Classeur n°1
Filière d'automatique | Etude |  | 4
1400 Yverdon
 |  | Classeur n°1
 | Liste de pièces |  | 5
 |  | Classeur n°1
 | Dessins |  | 6
 |  | Classeur n°1
 | Schémas |  | 7
 |  | Classeur n°1
P1704 | Programmes |  | 8
Manettes
 |  | Classeur n°1
 | Mise en service |  | 9
 |  | Classeur n°1
43281 | Fiches de travail |  | 10
 |  | Classeur n°1
 | Photos |  | 11
 |  | Classeur n°1
SANDOZ Pierre-Olivier | Présentation |  | 1900-01-11
Alexandre.PICOTTE@cpnv.ch
 |  | Classeur n°1

Sheet: Classeur 4
 | Administratif |  | 1
 |  | Classeur n°1
 | Commandes |  | 2
 |  | Classeur n°1
 | Documentation technique |  | 3
 |  | Classeur n°1
Filière d'automatique | Etude |  | 4
1400 Yverdon
 |  | Classeur n°1
 | Liste de pièces |  | 5
 |  | Classeur n°1
 | Dessins |  | 6
 |  | Classeur n°1
 | Schémas |  | 7
 |  | Classeur n°1
P1704 | Programmes |  | 8
Manettes
 |  | Classeur n°1
 | Mise en service |  | 9
 |  | Classeur n°1
2018-06-30 | Fiches de travail |  | 10
 |  | Classeur n°1
 | Photos |  | 11
 |  | Classeur n°1
SANDOZ Pierre-Olivier | Présentation |  | 12
Alexandre.PICOTTE@cpnv.ch
 |  | Classeur n°1

Sheet: Classeur 5
 | Administratif |  | 1
 |  | Classeur n°1
 | Commandes |  | 2
 |  | Classeur n°1
 | Documentation technique |  | 3
 |  | Classeur n°1
Filière d'automatique | Etude |  | 4
1400 Yverdon
 |  | Classeur n°1
 | Liste de pièces |  | 5
 |  | Classeur n°1
 | Dessins |  | 6
 |  | Classeur n°1
 | Schémas |  | 7
 |  | Classeur n°1
P1704 | Programmes |  | 8
Manettes
 |  | Classeur n°1
 | Mise en service |  | 9
 |  | Classeur n°1
2018-06-30 | Fiches de travail |  | 10
 |  | Classeur n°1
 | Photos |  | 11
 |  | Classeur n°1
SANDOZ Pierre-Olivier | Présentation |  | 12
Alexandre.PICOTTE@cpnv.ch
 |  | Classeur n°1

Sheet: Dos petits classeurs
Filière d'automatique |  |  |  |  |  | Filière d'automatique |  |  | Filière d'automatique |  |  | Filière d'automatique |  |  | Filière d'automatique
1400 Yverdon |  |  |  |  |  | 1400 Yverdon |  |  | 1400 Yverdon |  |  | 1400 Yverdon |  |  | 1400 Yverdon
P1704 |  |  | Manettes |  |  | P1704 | Manettes |  | P1704 | Manettes |  | P1704 | Manettes |  | P1704 | Manettes
2018-06-30 |  |  |  |  |  | 2018-06-30 |  |  | 2018-06-30 |  |  | 2018-06-30 |  |  | 2018-06-30
1 / 1 |  |  |  |  |  | 2 / 1 |  |  | 3 / 1 |  |  | 4 / 1 |  |  | 5 / 1
SANDOZ Pierre-Olivier |  |  |  |  |  | SANDOZ Pierre-Olivier |  |  | SANDOZ Pierre-Olivier |  |  | SANDOZ Pierre-Olivier |  |  | SANDOZ Pierre-Olivier
1 | 2 | 3 | 4 | 5 | 6
7 | 8 | 9 | 10 | 11 | 12
 |  |  |  |  | 1 |  |  | 2 |  |  | 3 |  |  | 4 |  |  | 5
