JoanMaillard/Manette/04_Etude/2019/rapport de décision gachettes_tableaux.xlsx

Gâchettes non-analogiques
Simple à mettre en place | Non-analogique
Pas cher
Gâchettes analogiques avec potentiomètres circulaires, bande et roues dentées
Analogique | Mécaniquement complexe
Se sert de potentiomètres avec lesquels | Prend beaucoup de place
nous sommes familiers
Bon marché
Gâchettes analogiques avec potentiomètres linéaires et ressorts
Analogique | Doit être commandé
Se sert de pot. Qui ont la bonne forme | Mécanisme de rappel potentiellement
Bon marché | susceptible à l'usure
Gâchettes analogiques avec potentiomètres linéaires motorisés
Analogique | Cher
Se sert de pot. Qui ont la bonne forme | Consomme plus d'énergie
Mécanisme de rappel intégré (moteur) | Nécessite une alimentation séparée
