JoanMaillard/Manette/04_Etude/2019/rapport de décision écran_tableaux.xlsx

LCD Arduino
A disposition | Taux de rafraîchissement très bas
Documentation disponible rapidement | Désagréable à utiliser
En couleur
OLED couleur SSD1351
Taux de rafraîchissement haut | Doit être commandé
Librairie facile d'utilisation
Format carré 128x128 facile à utiliser
Résistant à l'usure et bonne visibilité
OLED monochrome SSD1306
Taux de rafraîchissement rapide | Monochrome
Faible consommation | Doit être commandé
Résistant à l'usure et bonne visibilité | Matrice 128x64 moins grande que SSD1351
