JoanMaillard/Manette/01_Administratif/2019/2019 Cahier des charges P1704_fichiers/image004.jpg

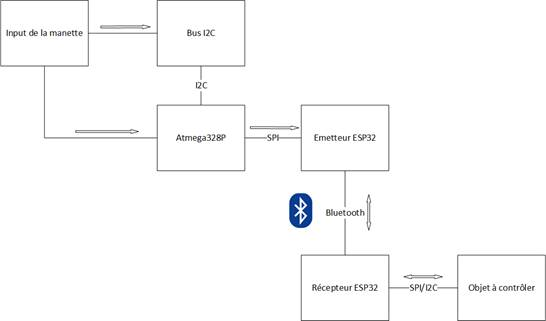
01_Administratif/2019/2019 Cahier des charges P1704_fichiers/image004.jpg
