JoanMaillard/Manette/01_Administratif/2019/2019 Cahier des charges P1704_fichiers/image005.png

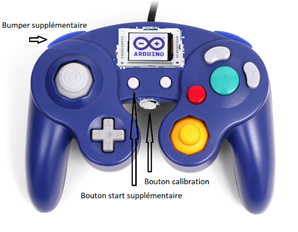
01_Administratif/2019/2019 Cahier des charges P1704_fichiers/image005.png
