JoanMaillard/Manette/01_Administratif/2019/Cahier des charges avec P1631_2019_fichiers/image002.png

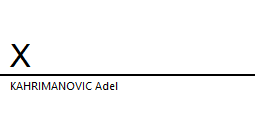
01_Administratif/2019/Cahier des charges avec P1631_2019_fichiers/image002.png
