JoanMaillard/Manette/01_Administratif/Schémas-Bloc/Borne d'arcade Bluetooth.png

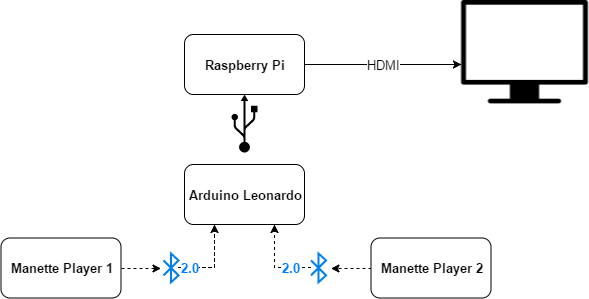
01_Administratif/Schémas-Bloc/Borne d'arcade Bluetooth.png
