JoanMaillard/Manette/01_Administratif/Schémas-Bloc/Borne d'arcade.png

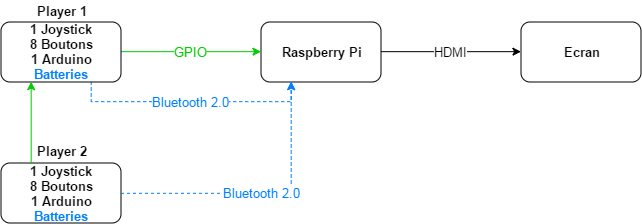
01_Administratif/Schémas-Bloc/Borne d'arcade.png
