JoanMaillard/Manette/01_Administratif/Schémas-Bloc/Diverses manettes.png

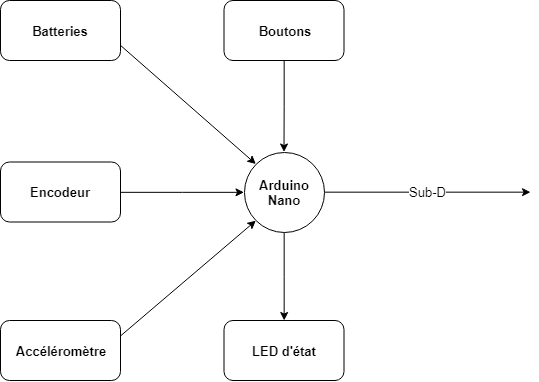
01_Administratif/Schémas-Bloc/Diverses manettes.png
