JoanMaillard/Manette/01_Administratif/Schémas-Bloc/Manette chevaliers.png

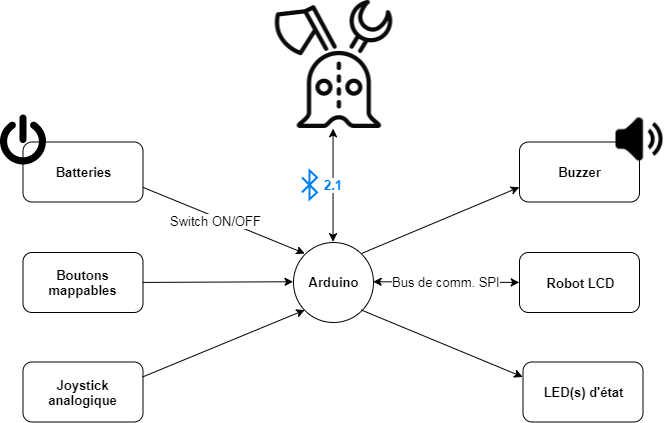
01_Administratif/Schémas-Bloc/Manette chevaliers.png
