JoanMaillard/Manette/01_Administratif/Schémas-Bloc/Manette lévitation.png

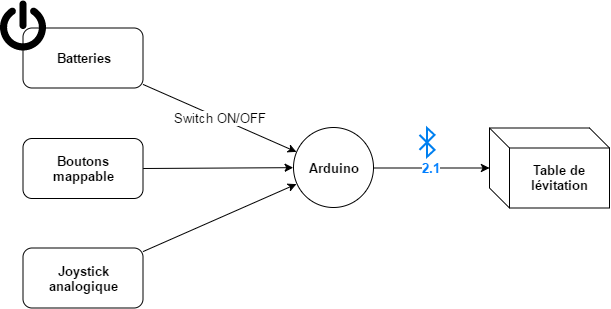
01_Administratif/Schémas-Bloc/Manette lévitation.png
