JoanMaillard/Manette/01_Administratif/Schémas-Bloc/Manette originale.png

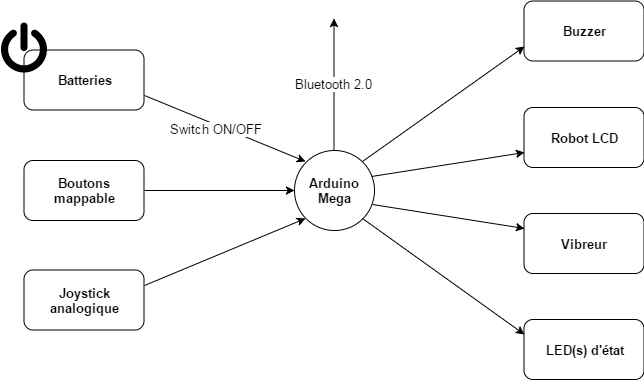
01_Administratif/Schémas-Bloc/Manette originale.png
