JoanMaillard/Manette/01_Administratif/Schémas-Bloc/Sabre Laser 2.0.png

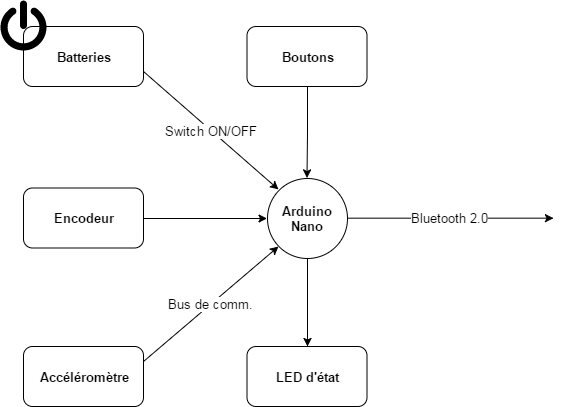
01_Administratif/Schémas-Bloc/Sabre Laser 2.0.png
