JoanMaillard/Manette/06_Dessins/2019/diagramme_communication.png

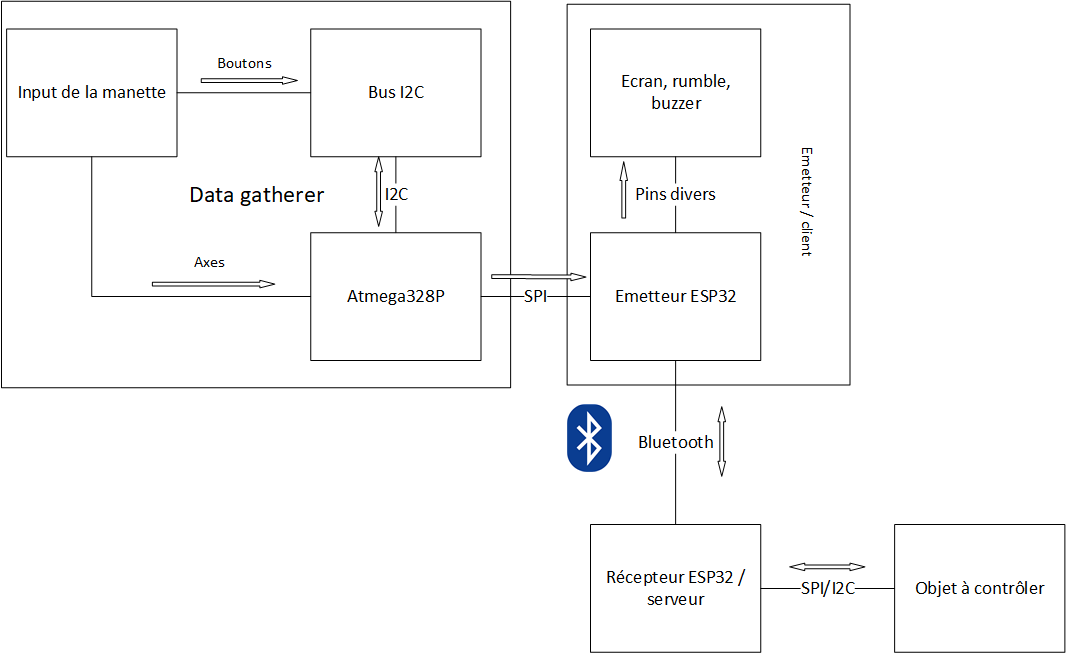
06_Dessins/2019/diagramme_communication.png
