JoanMaillard/Manette/06_Dessins/2019/Sous-diagramme BT.png

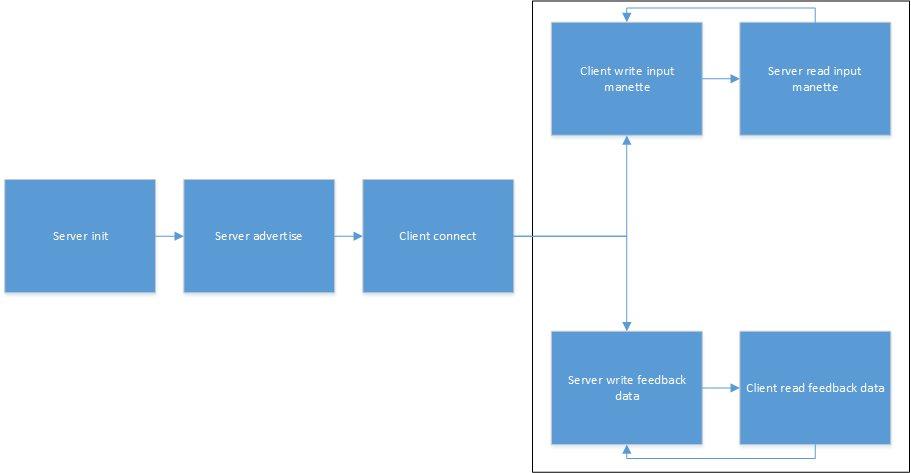
06_Dessins/2019/Sous-diagramme BT.png
