JoanMaillard/Manette/Liste_pièces_manette_universelle.xlsx

Nom de la pièce | Quantité | Prix unitaire | Prix quantité | Description | Lien
Atmega328P | 1 | 4.75 | 4.75 | Microcontroleur | https://www.distrelec.ch/fr/atmega328-avec-amorceur-arduino-arduino-x000048/p/30101974
NodeMCU ESP32 | 1 | 12.95 | 12.95 | Microcontroleur compatible Bluetooth | https://www.conrad.ch/fr/p/carte-de-developpement-joy-it-sbc-nodemcu-esp32-1-pc-s-1656367.html
MCP23017 | 1 | 3.05 | 3.05 | Extenseur de port 16 Entrée/Sortie | https://www.distrelec.ch/fr/extenseur-de-port-16-i2c-mcp23017-adafruit-732/p/30139248?track=true
ULN2803A | 1 | 1.04 | 1.04 | Transistor Darlington | https://www.distrelec.ch/fr/darlington-driver-pdip-st-uln2803a/p/17313323?queryFromSuggest=true
PCA9306 | 1 | 7.02 | 7.02 | Convertisseur logique | https://www.digikey.ch/product-detail/fr/sparkfun-electronics/BOB-11955/1568-1006-ND/5140771
Potentiomètre à glissière | 2 | 1.3 | 2.6 | Potentiomètre à glissière 10kOhm | https://www.digikey.ch/product-detail/fr/bourns-inc/PTA2043-2015DPB103/PTA2043-2015DPB103-ND/3781179
Joystick | 2 | 2.55 | 5.1 | Joystick résistif 2 axes | https://www.conrad.ch/fr/p/joystick-425637-12-v-dc-levier-metallique-droit-pin-a-souder-1-pc-s-425637.html
Contact LED Bleue | 2 | 7.76 | 15.52 | Contact LED bleue | https://www.digikey.ch/product-detail/fr/mec-switches/4FTH901/679-2251-ND/2034807?cur=CHF&lang=fr
Contact LED Rouge/Vert | 7 | 5.62 | 39.34 | Contact LED Rouge/Vert | https://www.digikey.ch/product-detail/fr/mec-switches/4FTH98222/679-2256-ND/2034812
Contact LED Jaune | 1 | 4.59 | 4.59 | Contact LED Jaune | https://www.digikey.ch/product-detail/fr/mec-switches/4FTH942/679-2253-ND/2034809
Port microusb | 1 | 15.87 | 15.87 | Microusb to 5 pins | https://www.digikey.ch/product-detail/fr/bulgin/PXP4043-B/708-2061-ND/5813258?cur=CHF&lang=fr
Adafruit OLED display | 1 | 39.95 | 39.95 | Ecran OLED 128x128 | https://www.digikey.ch/product-detail/fr/adafruit-industries-llc/1431/1528-1186-ND/5353646
Capuchon triangulaire | 5 | 0.59 | 2.95 | Capuchons pour les contacts | https://www.digikey.ch/product-detail/fr/mec-switches/1V16/679-2129-ND/2034685
Capuchon circulaire | 5 | 0.62 | 3.1 | Capuchons pour les contacts | https://www.digikey.ch/product-detail/fr/mec-switches/1U16/679-2125-ND/2034681
Connectique Phoenix | 3 | 1.1 | 3.3 | Connectique 2P, 5,08mm | https://www.digikey.com/product-detail/en/phoenix-contact/1729018/277-1236-ND/260604
Connecteur Micromatch | 4 | 0.52 | 2.08 | Connecteur 8 pôles mâle pour câble plat | https://www.distrelec.ch/fr/connecteur-de-carte-plat-te-connectivity-215570/p/30057223?track=true
Barrette Micromatch | 6 | 2 | 12 | Connecteur 8 pôles femelle pour câble plat | https://www.distrelec.ch/fr/barrette-femelle-femelle-te-connectivity-338069/p/30057258?track=true
Resonateur 3 pins | 1 | 0.68 | 0.68 | Resonateur 16MHz pour l'Atmega328P | https://www.distrelec.ch/fr/resonateur-pin-16-mhz-murata-cstls16m0x53-b0/p/17462468?track=true
 |  |  | 0
 |  |  | 0
 |  |  | 0
 |  |  | 0
 |  | Prix total | 175.89
