JoanMaillard/Manette/02_Commandes/Commande_P1704_2019.xlsx

Date | Quantité | Description | No d'article | Prix unitaire | Fournisseur | Acronyme | Rubrique | No projet
2019-03-05 | 15 | NodeMCU ESP32 | 1656367-62 | 12.95 | Conrad | MLI |  | P1704 | https://www.conrad.ch/fr/joy-it-sbc-nodemcu-esp32-1-pcs-1656367.html
2019-03-14 | 10 | Ecran OLED 128x128 | 1528-1186-ND | 39.95 | Digi-Key | MLI |  | P1704 | https://www.digikey.ch/product-detail/fr/adafruit-industries-llc/1431/1528-1186-ND/5353646
2019-03-18 | 10 | Socket NKK smartswitch | 360-2346-ND | 5.99 | Digi-Key | MLI |  | P1704 | https://www.digikey.ch/product-detail/fr/nkk-switches/AT9704-085L/360-2346-ND/2039173?cur=CHF&lang=fr
2019-03-21 | 15 | Contact LED rouge/vert | 679-2256-ND | 5.62 | Digi-Key | MLI |  | P1704 | https://www.digikey.ch/product-detail/fr/mec-switches/4FTH98222/679-2256-ND/2034812
2019-03-21 | 5 | Contact LED bleue | 679-2251-ND | 7.76 | Digi-Key | MLI |  | P1704 | https://www.digikey.ch/product-detail/fr/mec-switches/4FTH901/679-2251-ND/2034807?cur=CHF&lang=fr
2019-03-21 | 3 | Contact LED jaune | 679-2253-ND | 4.59 | Digi-Key | MLI |  | P1704 | https://www.digikey.ch/product-detail/fr/mec-switches/4FTH942/679-2253-ND/2034809
2019-03-21 | 12 | Capuchon triangulaire | 679-2129-ND | 0.59 | Digi-Key | MLI |  | P1704 | https://www.digikey.ch/product-detail/fr/mec-switches/1V16/679-2129-ND/2034685
2019-03-21 | 4 | Potentiomètres linéaires | PTA2043-2015DPB103-ND | 1.3 | Digi-Key | MLI |  | P1704 | https://www.digikey.ch/product-detail/fr/bourns-inc/PTA2043-2015DPB103/PTA2043-2015DPB103-ND/3781179
2019-03-21 | 12 | Capuchon cercle | 679-2125-ND | 0.62 | Digi-Key | MLI |  | P1704 | https://www.digikey.ch/product-detail/fr/mec-switches/1U16/679-2125-ND/2034681
2019-06-13 | 4 | Interrupteur à glissière | 135-31-126 | 4.09 | Distrelec | MLI |  | P1704 | https://www.distrelec.ch/fr/interrupteur-glissiere-on-on-2p-taiway-500-sdp1-s1-2m1qe/p/13531126?pos=6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
2019-06-06 | 6 | LIPOWER - BOOST CONVERTER | 1568-1155-ND | 16.11 | Digi-Key | MLI |  | P1704 | https://www.digikey.ch/product-detail/fr/sparkfun-electronics/PRT-10255/1568-1155-ND/5673741
2019-06-06 | 6 | Battery Management System | AKT-200507 | 9.02 | Akkushop | MLI |  | P1704 | https://www.akkushop-schweiz.ch/ch/1s-pcb-keeppower-pcm-kp-1660-s1-schutzelektronik/
2019-06-06 | 18 | Sony US18650NC1 Li-ion | AKT-100656 | 11.29 | Akkushop | MLI |  | P1704 | https://www.akkushop-schweiz.ch/ch/sony-us18650nc1-li-ion-2900mah-37-volt-li-ion-akku-ungeschuetzt/?c=0
2019-06-06 | 8 | microUSB to 5 P | 708-2061-ND | 15.87 | Digi-Key | MLI |  | P1704 | https://www.digikey.ch/product-detail/fr/bulgin/PXP4043-B/708-2061-ND/5813258?cur=CHF&lang=fr
2019-05-27 | 5 | Convertisseur logique | 1568-1006-ND | 7.02 | Digi-Key | MLI |  | P1704 | https://www.digikey.ch/product-detail/fr/sparkfun-electronics/BOB-11955/1568-1006-ND/5140771
