JoanMaillard/Manette/02_Commandes/Commandes_P1704.xlsx

Sheet: 15.03.2018
Date | Quantité | Description | No d'article | Prix unitaire | Fournisseur | Acronyme | Rubrique | No projet
2018-03-15 | 1 | Microcontrôleur/carte, Leonardo avec embases | 110-38-915 | 19.4 | Distrelec | PSZ | https://www.distrelec.ch/fr/microcontroleur-carte-leonardo-avec-embases-a000057-atmega32u4-arduino-leonardo-headars/p/11038915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 | P1704
2018-03-15 | 1 | Shield Bluetooth | 300-69-963 | 24.8 | Distrelec | PSZ | https://www.distrelec.ch/fr/shield-bluetooth-seeed-studio-113030019/p/30069963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 | P1704

Sheet: 04.05.2018
Date | Quantité | Description | No d'article | Prix unitaire | Fournisseur | Acronyme | Rubrique | No projet
2018-05-04 | 6 | Shield Bluetooth | 300-69-963 | 24.3 CHF | Distrelec | APE | https://www.distrelec.ch/fr/shield-bluetooth-seeed-studio-113030019/p/30069963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 | P1704
2018-05-07 | 6 | Arduino Uno | 1050-1041-ND | 21.56 CHF | Digikey | APE | https://www.digikey.ch/product-detail/fr/arduino/A000073/1050-1041-ND/3476357 | P1704
2018-05-07 | 2 | Câble micro USB 0.15m | 2444222 | 3.74 CHF | Farnell | APE | http://ch.farnell.com/fr-CH/roline/11-02-8310/cable-ordi-usb2-0-150mm-noir/dp/2444222?st=micro%20usb | P1704
2018-04-07 | 1 | Arduino Leonardo avec embases | 1050-1040-ND | 20.22 | Digikey | APE | https://www.distrelec.ch/fr/microcontroleur-carte-leonardo-avec-embases-a000057-atmega32u4-arduino-leonardo-headars/p/11038915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 | P1704
2018-05-07 | 5 | Micro-moteur | 245065 - 62 | 9.95 CHF | Conrad | APE | https://www.conrad.ch/fr/micro-moteur-m-600-sol-expert-m600-8500-trmin-4-mm-245065.html | P1704

Sheet: 08.05.2018
Date | Quantité | Description | No d'article | Prix unitaire | Fournisseur | Acronyme | Rubrique | No projet
2018-05-08 | 15 | Boutons-poussoirs | 401-1978-ND | 0.82 CHF | Digikey | APE | https://www.digikey.ch/product-detail/fr/c-k/D6R90-F1-LFS/401-1978-ND/1466335 | P1704

Sheet: 22.05.20187
Date | Quantité | Description | No d'article | Prix unitaire | Fournisseur | Acronyme | Rubrique | No projet
2018-05-22 | 5 | Slide Switch | CKC5106-ND | 1.62 CHF | Digikey | APE | https://www.digikey.ch/products/fr?keywords=CKC5106-ND | P1704

Sheet: 29.05.2018
Date | Quantité | Description | No d'article | Prix unitaire | Fournisseur | Acronyme | Rubrique | No projet
2018-05-29 | 6 | Slide Switch | 360-2728-ND | 4.00 CHF | Digikey | APE | https://www.digikey.ch/product-detail/fr/nkk-switches/AS11CH/360-2728-ND/2103412 | P1704
2018-05-29 | 5 | Bouton poussoir | 360-2703-ND | 4.90 CHF | Digikey | APE | https://www.digikey.ch/product-detail/fr/nkk-switches/AB11AH-HA/360-2703-ND/1056050 | P1704

Sheet: 01.06.2018
Date | Quantité | Description | No d'article | Prix unitaire | Fournisseur | Acronyme | Rubrique | No projet
2018-06-01 | 8 | Sous connecteurs D | HFM09H-ND | 1.83 CHF | Digikey | PSZ | https://www.digikey.ch/product-detail/fr/assmann-wsw-components/A-DFF-09LPIII-Z/HFM09H-ND/924254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 | P1704

Sheet: 08.06.2018
Date | Quantité | Description | No d'article | Prix unitaire | Fournisseur | Acronyme | Rubrique | No projet
2018-06-08 | 6 | Embase mâle sans levier d'éjection | 741435 - 62 | fr.0.35 | conrad | PSZ | https://www.conrad.ch/fr/embase-male-sans-levier-dejection-pas-254-mm-nbr-741435.html | P1704
2018-06-08 | 6 | Connectique fil-à-carte avec décharge de traction | 742063 - 62 | fr.0.90 | conrad | PSZ | https://www.conrad.ch/fr/connectique-fil-a-carte-avec-decharge-de-traction-pas-254-mm-742063.html | P1704
