JoanMaillard/Manette/(list of files, cad)

Other CAD files:
06_Dessins/2019/Manette minotaure/OldVersions/P1704_021_dessus_manette-1.0002.idw
06_Dessins/2019/Manette minotaure/OldVersions/P1704_021_dessus_manette.0004.ipt
06_Dessins/2019/Manette minotaure/P1704_021_dessus_manette-1.idw
06_Dessins/2019/Manette minotaure/P1704_021_dessus_manette.ipt
06_Dessins/2019/Manette universelle/OldVersions/P1704_001_basManette.0013.idw
06_Dessins/2019/Manette universelle/OldVersions/P1704_001_basManette.0030.ipt
06_Dessins/2019/Manette universelle/OldVersions/P1704_002_mainDroiteInterieur.0001.idw
06_Dessins/2019/Manette universelle/OldVersions/P1704_002_mainDroiteInterieur.0007.ipt
06_Dessins/2019/Manette universelle/OldVersions/P1704_003_mainGaucheInterieur.0007.ipt
06_Dessins/2019/Manette universelle/OldVersions/P1704_004_mainDroiteExterieur.0003.idw
06_Dessins/2019/Manette universelle/OldVersions/P1704_004_mainDroiteExterieur.0010.ipt
06_Dessins/2019/Manette universelle/OldVersions/P1704_004_mainExterieur.0001.ipt
06_Dessins/2019/Manette universelle/OldVersions/P1704_005_mainGaucheExterieur.0007.ipt
06_Dessins/2019/Manette universelle/OldVersions/P1704_006_gachette.0005.idw
06_Dessins/2019/Manette universelle/OldVersions/P1704_006_gachette.0013.ipt
06_Dessins/2019/Manette universelle/OldVersions/P1704_014_Display.0001.ipt
06_Dessins/2019/Manette universelle/OldVersions/P1704_017_button_cap.0003.ipt
06_Dessins/2019/Manette universelle/OldVersions/P1704_018_hautManette.0009.ipt
06_Dessins/2019/Manette universelle/OldVersions/P1704_018_hautManette.0011.ipt
06_Dessins/2019/Manette universelle/OldVersions/P1704_018_hautManette.0012.ipt
06_Dessins/2019/Manette universelle/OldVersions/P1704_019_button_triangle_cap.0001.ipt
06_Dessins/2019/Manette universelle/OldVersions/P1704_E001.0043.iam
06_Dessins/2019/Manette universelle/P1704_001_basManette.idw
06_Dessins/2019/Manette universelle/P1704_001_basManette.ipt
06_Dessins/2019/Manette universelle/P1704_002_mainDroiteInterieur.idw
06_Dessins/2019/Manette universelle/P1704_002_mainDroiteInterieur.ipt
06_Dessins/2019/Manette universelle/P1704_003_mainGaucheInterieur.ipt
06_Dessins/2019/Manette universelle/P1704_004_mainDroiteExterieur.idw
06_Dessins/2019/Manette universelle/P1704_004_mainDroiteExterieur.ipt
06_Dessins/2019/Manette universelle/P1704_004_mainExterieur.idw
06_Dessins/2019/Manette universelle/P1704_004_mainExterieur.ipt
06_Dessins/2019/Manette universelle/P1704_006_gachette.idw
06_Dessins/2019/Manette universelle/P1704_006_gachette.ipt
06_Dessins/2019/Manette universelle/P1704_007_guideRessort.ipt
06_Dessins/2019/Manette universelle/P1704_008_pcb.ipt
06_Dessins/2019/Manette universelle/P1704_009_slider.ipt
06_Dessins/2019/Manette universelle/P1704_010_startSelectPCB.ipt
06_Dessins/2019/Manette universelle/P1704_011_4buttonPCB.ipt
06_Dessins/2019/Manette universelle/P1704_012_joystick.ipt
06_Dessins/2019/Manette universelle/P1704_013_Switch.ipt
06_Dessins/2019/Manette universelle/P1704_014_Display.ipt
06_Dessins/2019/Manette universelle/P1704_015_rumble.ipt
06_Dessins/2019/Manette universelle/P1704_016_Button.ipt
06_Dessins/2019/Manette universelle/P1704_017_button_cap.ipt
06_Dessins/2019/Manette universelle/P1704_018_hautManette.idw
06_Dessins/2019/Manette universelle/P1704_018_hautManette.ipt
06_Dessins/2019/Manette universelle/P1704_019_button_triangle_cap.ipt
06_Dessins/2019/Manette universelle/P1704_E001.iam
06_Dessins/2019/Manette universelle/P1704_E002.iam
06_Dessins/2019/Manette universelle/P1704_E003_button.iam
06_Dessins/2019/Manette universelle/P1704_E004_triangle_button.iam
06_Dessins/Concept de souris/Bouton poussoir NO.iam
06_Dessins/Concept de souris/Bouton.ipt
06_Dessins/Concept de souris/Butée.ipt
06_Dessins/Concept de souris/Capuchon.ipt
06_Dessins/Concept de souris/Couvercle_bas.ipt
06_Dessins/Concept de souris/Couvercle_haut.ipt
06_Dessins/Concept de souris/Couvercle_rail.ipt
06_Dessins/Concept de souris/Couvercle_replat.ipt
06_Dessins/Concept de souris/Encodeur.ipt
06_Dessins/Concept de souris/Entretoise 12 x M3.ipt
06_Dessins/Concept de souris/Entretoise 25.ipt
06_Dessins/Concept de souris/Entretoise 50.ipt
06_Dessins/Concept de souris/Entretoise_M3x6.ipt
06_Dessins/Concept de souris/Manette.iam
06_Dessins/Concept de souris/Manette_totale.iam
06_Dessins/Concept de souris/Molette.ipt
06_Dessins/Concept de souris/OldVersions/Couvercle_haut.0004.ipt
06_Dessins/Concept de souris/OldVersions/Couvercle_haut.0005.ipt
06_Dessins/Concept de souris/OldVersions/Couvercle_rail.0002.ipt
06_Dessins/Concept de souris/OldVersions/Couvercle_rail.0003.ipt
06_Dessins/Concept de souris/OldVersions/Couvercle_replat.0005.ipt
06_Dessins/Concept de souris/OldVersions/Encodeur.0005.ipt
06_Dessins/Concept de souris/OldVersions/Manette.0007.iam
06_Dessins/Concept de souris/OldVersions/Molette.0003.ipt
06_Dessins/Concept de souris/OldVersions/Paroi_interne.0002.ipt
06_Dessins/Concept de souris/OldVersions/Potentiomètre.0004.ipt
06_Dessins/Concept de souris/OldVersions/Replat.0003.ipt
06_Dessins/Concept de souris/OldVersions/S1702_couverclehaut.0002.ipt
06_Dessins/Concept de souris/OldVersions/Veroboard.0005.ipt
06_Dessins/Concept de souris/Paroi_interne.ipt
06_Dessins/Concept de souris/Replat.ipt
06_Dessins/Concept de souris/Tube_Externe.ipt
06_Dessins/Concept de souris/Veroboard.ipt
06_Dessins/Manette arcade/OldVersions/EG-1.0001.ipn
06_Dessins/Manette arcade/OldVersions/EG-1.0002.idw
06_Dessins/Manette arcade/OldVersions/EG.0014.iam
06_Dessins/Manette arcade/OldVersions/P1704_001.0013.idw
06_Dessins/Manette arcade/OldVersions/P1704_001_Pied.0007.ipt
06_Dessins/Manette arcade/OldVersions/P1704_001_Pied.0016.idw
06_Dessins/Manette arcade/OldVersions/P1704_001_picotte_alexandre.0012.idw
06_Dessins/Manette arcade/OldVersions/P1704_002.0016.ipt
06_Dessins/Manette arcade/OldVersions/P1704_002.0052.idw
06_Dessins/Manette arcade/OldVersions/P1704_002_Toiture.0032.ipt
06_Dessins/Manette arcade/OldVersions/P1704_002_Toiture.0083.idw
06_Dessins/Manette arcade/OldVersions/P1704_002_Toiture2.0003.idw
06_Dessins/Manette arcade/OldVersions/P1704_002_picotte_alexandre.0001.ipt
06_Dessins/Manette arcade/OldVersions/P1704_003.0007.ipt
06_Dessins/Manette arcade/OldVersions/P1704_003.0023.idw
06_Dessins/Manette arcade/OldVersions/P1704_003_Paroi_avant.0010.ipt
06_Dessins/Manette arcade/OldVersions/P1704_003_Paroi_avant.0033.idw
06_Dessins/Manette arcade/OldVersions/P1704_004.0017.ipt
06_Dessins/Manette arcade/OldVersions/P1704_004.0024.idw
06_Dessins/Manette arcade/OldVersions/P1704_004_Paroi_arrière.0021.ipt
06_Dessins/Manette arcade/OldVersions/P1704_004_Paroi_arrière.0039.idw
06_Dessins/Manette arcade/OldVersions/P1704_005.0008.ipt
06_Dessins/Manette arcade/OldVersions/P1704_005.0022.idw
06_Dessins/Manette arcade/OldVersions/P1704_005_Paroi_latérale.0009.ipt
06_Dessins/Manette arcade/OldVersions/P1704_005_Paroi_latérale.0032.idw
06_Dessins/Manette arcade/OldVersions/P1704_006.0016.ipt
06_Dessins/Manette arcade/OldVersions/P1704_006.0022.idw
06_Dessins/Manette arcade/OldVersions/P1704_006_Socle.0024.ipt
06_Dessins/Manette arcade/OldVersions/P1704_006_Socle.0040.idw
06_Dessins/Manette arcade/OldVersions/P1704_007.0012.ipt
06_Dessins/Manette arcade/OldVersions/P1704_007.0021.idw
06_Dessins/Manette arcade/OldVersions/P1704_007_Plaque.0026.ipt
06_Dessins/Manette arcade/OldVersions/P1704_007_Plaque.0040.idw
06_Dessins/Manette arcade/OldVersions/P1704_009.0003.ipt
06_Dessins/Manette arcade/OldVersions/P1704_E1.0004.ipn
06_Dessins/Manette arcade/OldVersions/P1704_E1.0007.idw
06_Dessins/Manette arcade/OldVersions/P1704_E1.0017.iam
06_Dessins/Manette arcade/OldVersions/P1704_E1_Manette.0010.ipn
06_Dessins/Manette arcade/OldVersions/P1704_E1_Manette.0018.idw
06_Dessins/Manette arcade/OldVersions/P1704_E1_Manette.0024.iam
06_Dessins/Manette arcade/OldVersions/P1704_E2.0005.idw
06_Dessins/Manette arcade/OldVersions/P1704_E2.0006.iam
06_Dessins/Manette arcade/OldVersions/P1704_E2_Console.0012.iam
06_Dessins/Manette arcade/OldVersions/P1704_E2_Console.0013.idw
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
