JoanMaillard/Manette/04_Etude/2019/Tests Arduino_ESP32.xlsx

Checklist des points de test Arduino et ESP32
Enoncé | Arduino | ESP32
Un code compilé se téléverse | OUI | OUI
Les sorties fonctionnent | OUI | OUI
La stack Bluetooth fonctionne | / | OUI
La stack Serial fonctionne | OUI | OUI
Les données envoyées par l'Arduino sont lues par l'ESP | OUI | OUI
Les données envoyées par Bluetooth sont reçues (2 sens) | / | OUI
