JoanMaillard/Manette/08_Programmes/TESTS/I2c_mastervV2bis_ONLY_LETTERS/ReadMe.txt

Ce programme n'affichera que des lettres en appuyant sur les différents boutons de la manette
