JoanMaillard/Manette/04_Etude/2019/tests_prolongés_manette.xlsx

MAILLARD Joan, KAHRIMANOVIC Adel
P1704 Manette
Tests prolongés électronique manette (avec manette breadboard)
Première série
Entrée \ Temps écoulé | Lancement | 30 min | 1h | 2h | 3h
Intégrité des données | OUI | OUI | OUI | OUI | OUI
Fonctionnalité de l'affichage | OUI | OUI | OUI | OUI | OUI
Fonctionnalité des commandes | OUI | OUI | OUI | OUI | OUI
Seconde série
Entrée \ Temps écoulé | Lancement | 30 min | 1h | 2h | 3h
Intégrité des données | OUI | OUI | OUI | OUI | OUI
Fonctionnalité de l'affichage | OUI | OUI | OUI | OUI | OUI
Fonctionnalité des commandes | OUI | OUI | OUI | OUI | OUI
