JoanMaillard/Manette/01_Administratif/Journal de travail Joan.txt

N.B. Sauf mention contraire, le projet actif est le P1704 Manette

SEMAINE 1

Jour 1 - 04.03.2019
- Prise en main du projet
- Information sur les versions existantes des manettes
- Etablissement d'un git
- Etablissement de certains objectifs de base
- Début de prise en main d'un module Bluetooth (choix encore à faire)
- Réflexions sur la solution d'alimentation (de préférence Li-Ion 2S2P avec BMS)
- Réalisation d'un diagramme de fonction basique
	- Voir document "Dessins/diagramme_fonctionnel"
- Préparation de la station de travail (driver Wacom)

Jour 2 - 05.03.2019
- Rélection du document de choix du module Bluetooth
- Commande du module Bluetooth
- Elaboration d'un fichier MS Project pour la planification
- Discussion avec le groupe des robots chevaliers et minotaure pour établir la façon d'intégrer les manettes: nous développons un dongle
- Mise en place d'un système de test de data transfer pour le serial 
- Préparation pour un test simple (1 potard, 2 boutons à transmettre en serial)
- Avance sur le fichier MS project

Jour 3 - 07.03.2019
- Finition du test simple, établissement de la quantité de données totale à transmettre par l'AtMega vers l'ESP (8 octets)
- Préparation du PPT de présentation du lendemain
- Update MS Project sheet
- Recherches sur la communication Bluetooth
- Ajout d'un périphérique de level shifting 5v-3.3v
- Added transistor pour que l'ESP reset l'AtMega qui lit les boutons etc.
- Essai de l'ancienne manette

Jour 4 - 08.03.2019
- Réunion avec M. Locatelli pour revoir le cahier des charges
- Commande des ESP32
- Aide à la réparation / remise en service de la manette avec les chevaliers

SEMAINE 2

Jour 5 - 11.03.2019
- Réfection du MS Project et du cahier des charges
- Elaboration du programme de test PJON
- Suite de l'aide à la remise en service des chevaliers

Jour 6 - 12.03.2019
- Suite de l'élaboration du programme de test PJON
- Elaboration d'un plan de base pour la manette version breadboard
- Correctifs sur le diagramme fonctionnel, graphique de complément sur la communication BT/PJON

Jour 7 - 14.03.2019
- Préparation de la présentation des projets
- Réfections du cahier des charges
- Etablissement du cahier des charges avec le groupe des chevaliers
- Réfections sur le code de l'ESP pour intégrer le code PJON avec la communication BT comme sous-couche

Jour 8 - 15.03.2019
- Abandon PJON (c.f. Etude/2019/Utilisation PJON)
- Début du montage de la manette Breadboard (avec beaucoup de scotch)
- (Projet: AUTRE) Présentation des projets
- Validation des cahiers des charges
- Recherches diverses (gâchettes analogiques -> potentiomètres linéaires, doc BT, ...)
	- Voir document "rapport de décision gâchettes"
	- Voir document "Doc tech/Bluetooth"

SEMAINE 3

Jour 9 - 18.03.2019
- Continuation du montage de la manette Breadboard
- Complément de doc

Jour 10 - 19.03.2019
- Fin montage de la manette breadboard
- Mise en place dans le code de test de la manette: système de calibration (non-centré)
- Correction de problèmes d'interférence I2C sur les axes des pins A4/A5
- Toujours pas d'ESP32

Jour 11 - 21.03.2019
- Corrections légères sur le code de test de la manette (correction d'une imprécision dans le système de calibration à cause du courant de fuite causé par la LED)
- Toujours pas d'ESP32, peaufinage du protocole (optimisation), réflexions sur le système duplex

Jour 12 - 22.03.2019
- Les ESP32 sont arrivés - suis allé les chercher
- Discussion avec M. Vulliamy pour l'impression 3D - il faudra fournir les plans complets ainsi que vérifier la faisabilité de l'impression
- Discussion avec un représentant du groupe des robots S7 par rapport à la disponibilité des pins RX/TX de leur côté
- Test du code préparé à l'avance - le BLE 4.1 ne sera pas approprié, car monodirectionnel -> passage au BLE 4.2 bidirectionnel (profil GATT) (c.f. Dessins/Sous-diagramme BT)

SEMAINE 4

Jour 13 - 25.03.2019
- Complément de doc, préparation pour les revues de projet
- Etablissement de la communication bidirectionnelle entre deux ESP32s

Jour 14 - 26.03.2019
- Complément de doc, préparation pour les revues de projet
- Link entre le proto de la manette et le récepteur/émetteur

Jour 15 - 28.03.2019
- Constatation d'une grosse latence à l'intérieur du circuit interne de la manette, entre le l'ATMega de data gathering et la sortie de l'ESP32 (c.f. Etude/Troubleshooting latence)

Jour 16 - 29.03.2019
- Recherche pour des correctifs sur la latence (c.f. Etude/2019/Mesure latence)

SEMAINE 5

Jour 17 - 01.04.2019

- (Projet: AUTRE) Présentations des projets
- Correctifs latence (c.f. Etude/2019/Troubleshooting latence)

Jour 18 - 02.04.2019

- Mise en place des correctifs latence au niveau du code
- Livraison au groupe P1631 selon le cahier des charges (c.f. Rapport de réunion 02.04.2019)

Jour 19 - 04.04.2019

- Changement de l'intervalle de correction pour encore augmenter la responsivité (c.f. test BLE accéléré)

Jour 20 - 05.04.2019

- Documentation

SEMAINE 6

Jour 21 - 08.04.2019

- Documentation

Jour 22 - 09.04.2019

- Documentation

Jour 23 - 11.04.2019

- Documentation

Jour 24 - 12.04.2019

- Congé

SEMAINE 7

Jour 25 - 29.04.2019

- Modélisation 3D

Jour 26 - 30.04.2019

- Modélisation 3D

Jour 27 - 02.05.2019

- Modélisation 3D

Jour 28 - 03.05.2019

- Modélisation 3D

SEMAINE 8

Jour 29 - 06.05.2019

- Modélisation 3D

Jour 30 - 07.05.2019

- Modélisation 3D

Jour 31 - 09.05.2019

- Préparation pour revue de projet

Jour 32 - 10.05.2019

- Revue de projet

SEMAINE 9

Jour 33 - 13.05.2019

- Prog NKK

Jour 34 - 14.05.2019

- Prog NKK

Jour 35 - 16.05.2019

- Absent - maladie

Jour 36 - 17.05.2019

- Documentation
- Commande PCB

SEMAINE 10

Jour 37 - 20.05.2019

- Brasure des boutons sur les PCB correspondants
- Préparation code de l'affichage

Jour 38 - 21.05.2019

- Migration git
- Correction d'une erreur de brasure

Jour 39 - 23.05.2019

- Complétion code de l'affichage, adaptation pour les manettes définitives

Jour 40 - 24.05.2019

- Présentation ESP32
- Préparation à la présentation du projet au jour 41

SEMAINE 11

Jour 41 - 27.05.2019

- Présentation du projet à l'aula du CPNV
- Documentation

Jour 42 - 28.05.2019

- Documentation

SEMAINE 12

Jour 43 - 03.06.2019

- Mise en place de l'interface entre l'ESP32 des minotaure et chevaliers (P1631) et leur système
- Essai et vérification de fonctionnalité des menus (transmission d'état)
- Ajout d'une paire d'éléments menu

Jour 44 - 04.06.2019

- Documentation
- Revue de projet

SEMAINE 13

Jour 45 - 10.06.2019

- Documentation
- Aide au dépannage (P1631)

Jour 46 - 11.06.2019

- Complétion des menus (cf. code BLE_Serveur.ino)
- Aide au dépannage (P1631)
- Commande batterie

Jour 47 - 13.06.2019

- Aide au dépannage (P1631)
- Adaptation codes manette rétro

Jour 48 - 14.06.2019

- Fin adaptation codes pour les manettes console rétro (corrections)
- Arrivage PCB principal
- Aide au dépannage (P1631)

SEMAINE 14

Jour 49 - 17.06.2019

- Documentation

Jour 50 - 18.06.2019

- Mise en place et tests prolongés (voir doc. 04.Etude/2019/tests_prolongés_manette)

Jour 51 - 20.06.2019

- Bis

Jour 52 - 21.06.2019

- Réception impressions 3D
- Modification et adaptation des codes pour la manette breadboard

SEMAINE 15 

Jour 53 - 24.06.2019

- Montage et préparation des PCB finaux
- Documentation

Jour 54 - 25.06.2019

- Entretien doc

- Réfections sur les gâchettes
