JoanMaillard/Manette/07_Schémas/manette_2019_alim/alim_manette_universelle.pdf

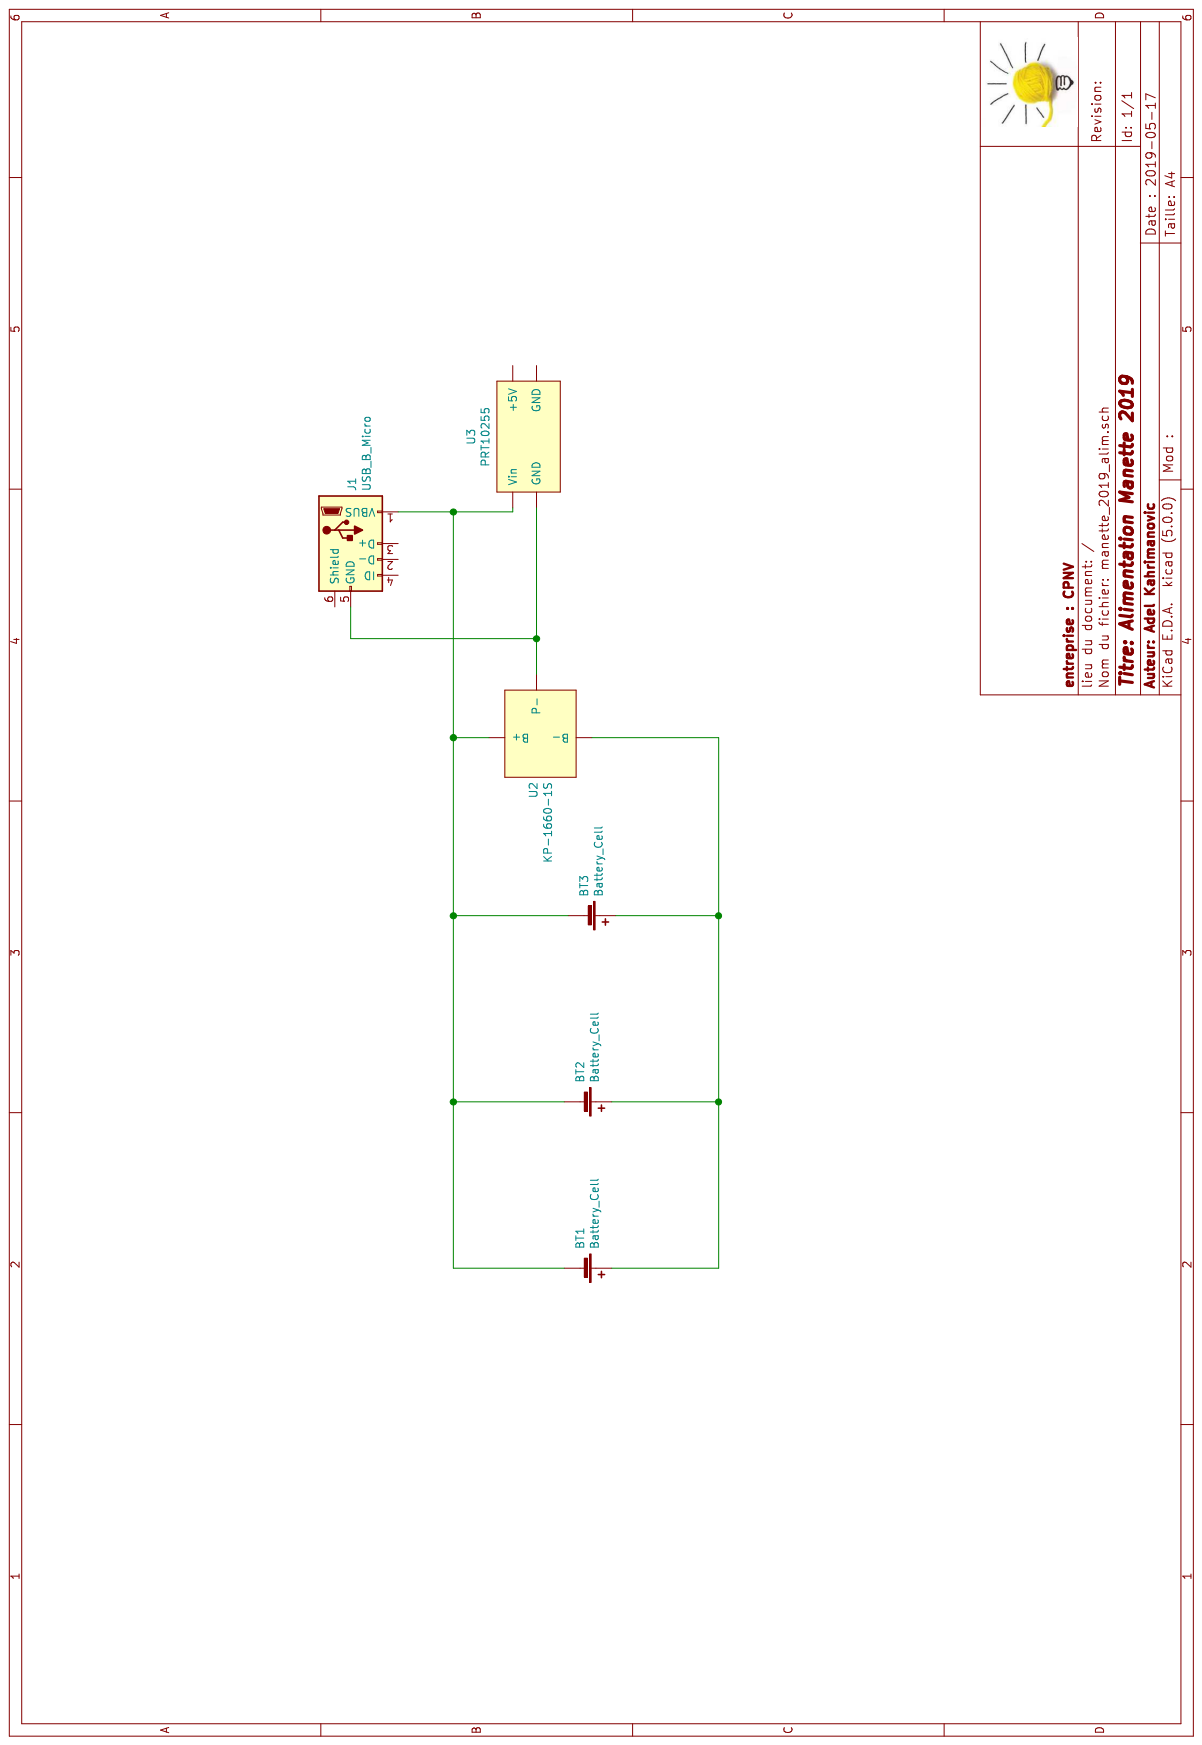
[picture p107: page 1]
