JoanMaillard/Manette/07_Schémas/manette_2019/Manette_Universelle.pdf

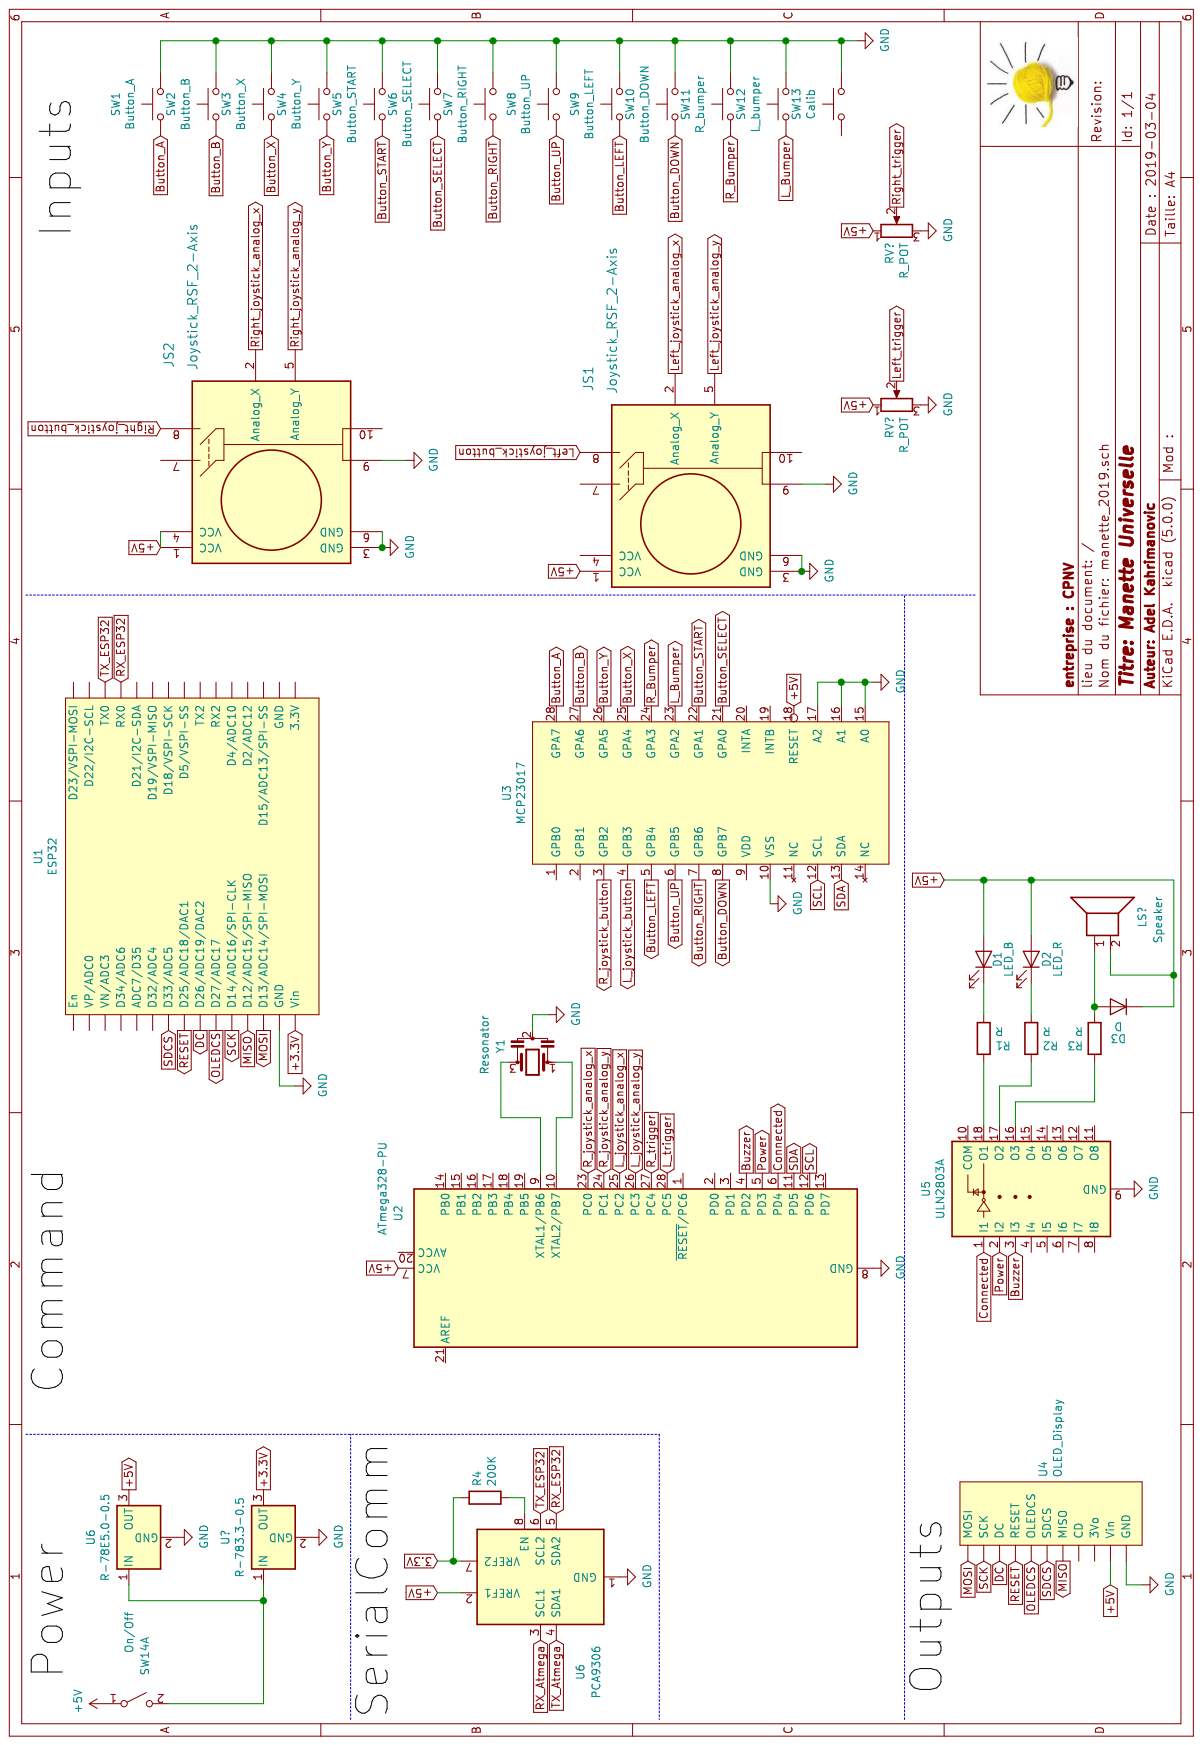
[picture p108: page 1]
