JoanMaillard/Manette/06_Dessins/Manette arcade/PDFs/P1704_001_Pied.pdf

75

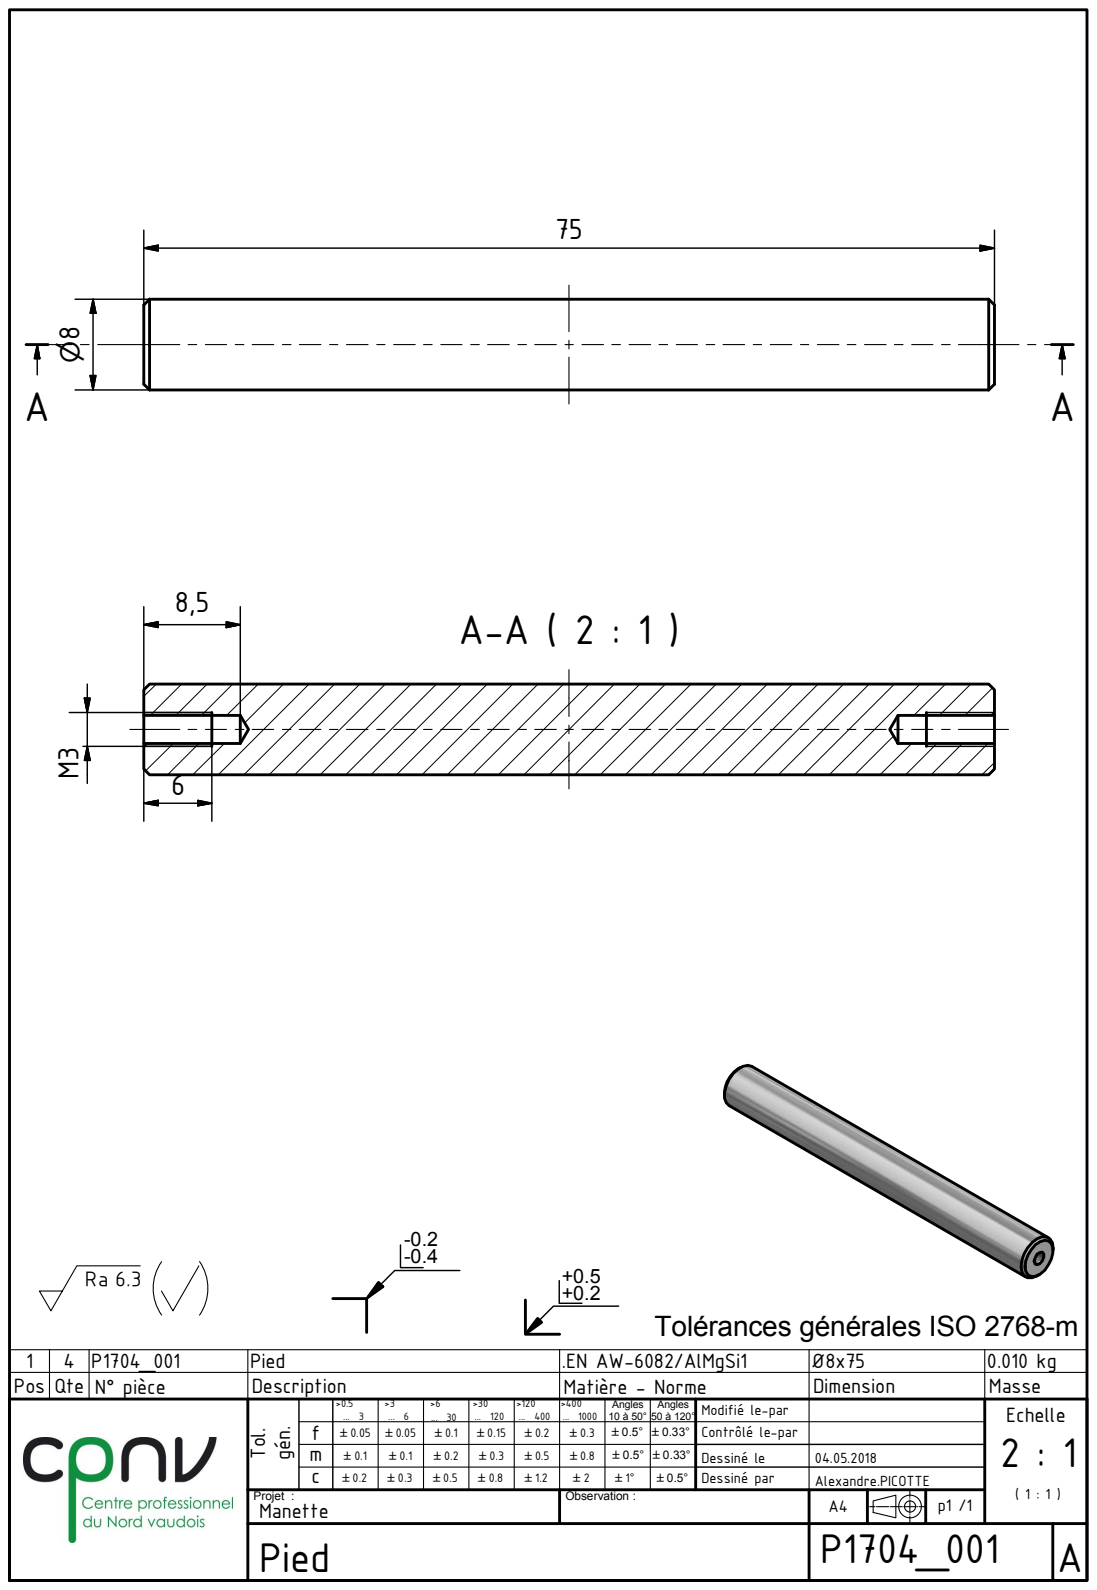
[picture p109: page 1]
Pied; .EN AW-6082/AlMgSi1; Pos; Qte; Description; Matire - Norme; Dimension; Masse; Tol.; Angles; Echelle; Observation :; Manette; Projet :; Angles 10 j 50°

Tolprances gpnprales ISO 2768-m

Modifi le-par

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

m | B0.1 | B0.1 | B0.2 | B0.3 | B0.5 | B0.8 | B0.5° | B0.33° | Dessin le | 04.05.2018
c | B0.2 | B0.3 | B0.5 | B0.8 | B1.2 | B2 | B1° | B0.5° | Dessin par | Alexandre.PICOTTE
