JoanMaillard/Manette/06_Dessins/Manette arcade/PDFs/P1704_006_Socle.pdf

A

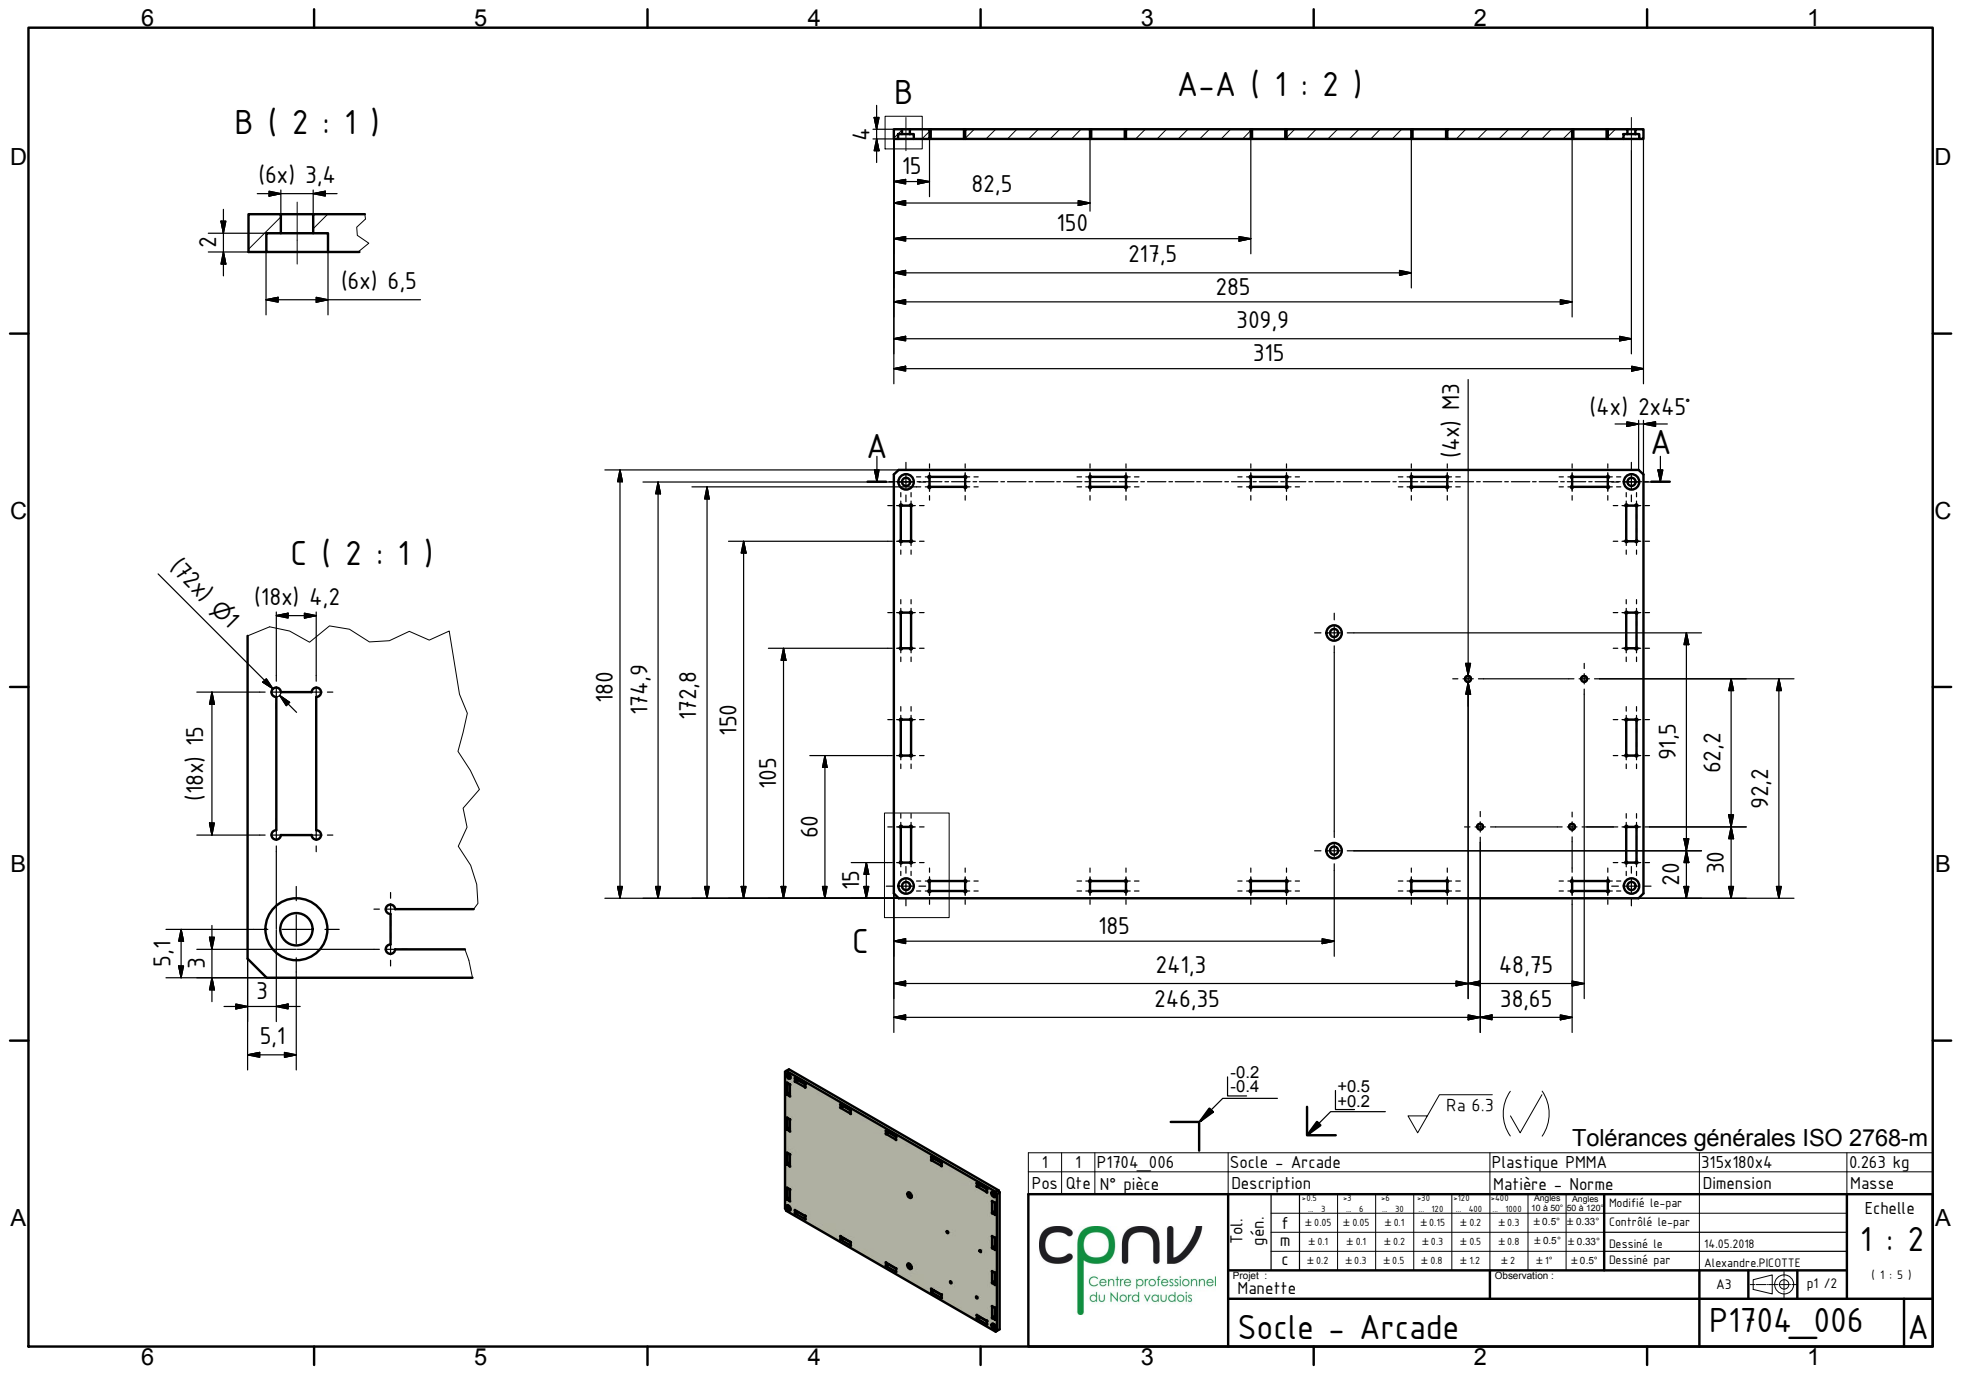
[picture p111: page 1]
tiq; rip; tio; Dim; sio; Tol. gn. m; gle; difi; olp r; ale

f | B 0.0 5 | B 0.0 5 | B 0.1 | B 0.1 5 | B 0.2 | B 0.3 | B 0.5 ° | B 0.3 3 ° | §  C o n t r l l e -p a r
B 0.1 | B 0.1 | B 0.2 | B 0.3 | B 0.5 | B 0.8 | B 0.5 ° | B 0.3 3 ° | D e s sin  l e | 1 4.0 5.2 0 1 8
B 0.2 | B 0.3 | B 0.5 | B 0.8 | B 1.2 | B 2 | B 1 ° | B 0.5 ° | D e s sin  p a r | A l e x a n d r e.PIC O T T E
