JoanMaillard/Manette/06_Dessins/Manette arcade/PDFs/P1704_E1_Manette.pdf

4
6

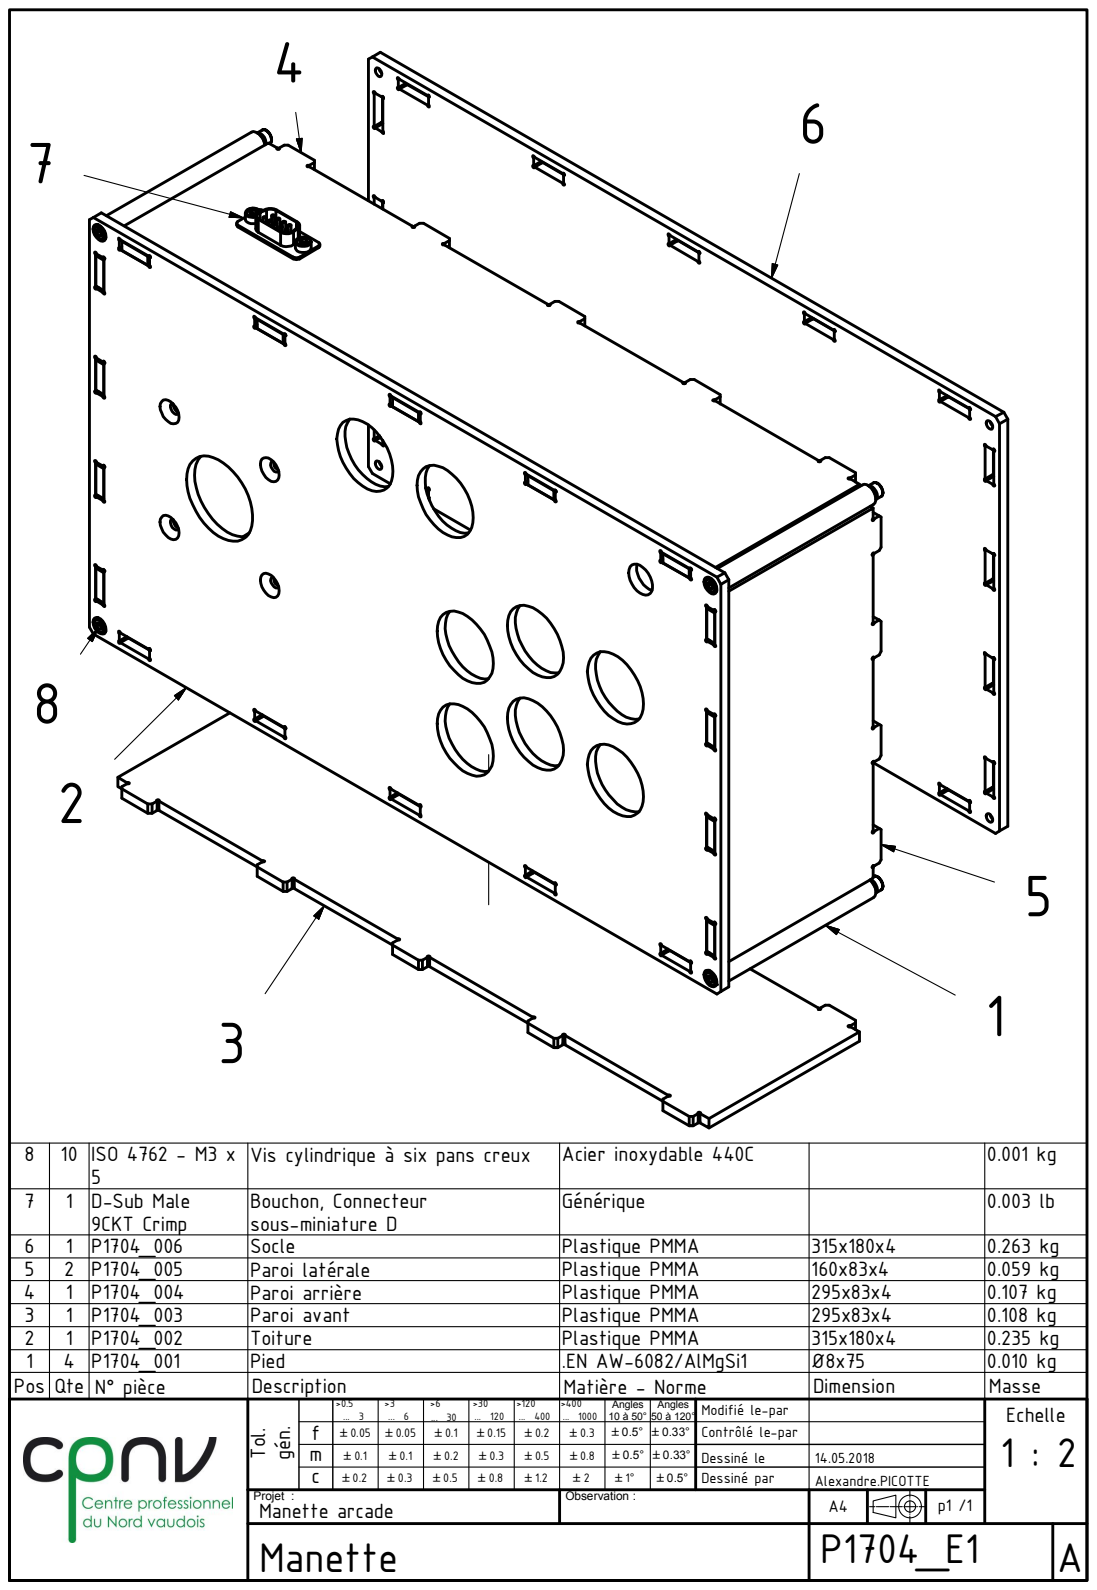
[picture p112: page 1]
ISO 4762 - M3 x; Vis cylindrique  six pans creux; Acier inoxydable 440C; Bouchon, Connecteur; Gnrique; sous-miniature D; D-Sub Male 9CKT Crimp; Socle; Plastique PMMA; Paroi latrale; Paroi arrire; Paroi avant; Toiture; Pied; .EN AW-6082/AlMgSi1; Pos; Qte; Description; Matire - Norme; Dimension; Masse; Tol.; Angles; Echelle; Observation :; Manette arcade; Projet :; Angles 10 j 50°; Manette

Modifi le-par

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

m | B0.1 | B0.1 | B0.2 | B0.3 | B0.5 | B0.8 | B0.5° | B0.33° | Dessin le
c | B0.2 | B0.3 | B0.5 | B0.8 | B1.2 | B2 | B1° | B0.5° | Dessin par | Alexandre.PICOTTE
