JoanMaillard/Manette/07_Schémas/Manette_arcade/PDFs/Manette + Console.pdf

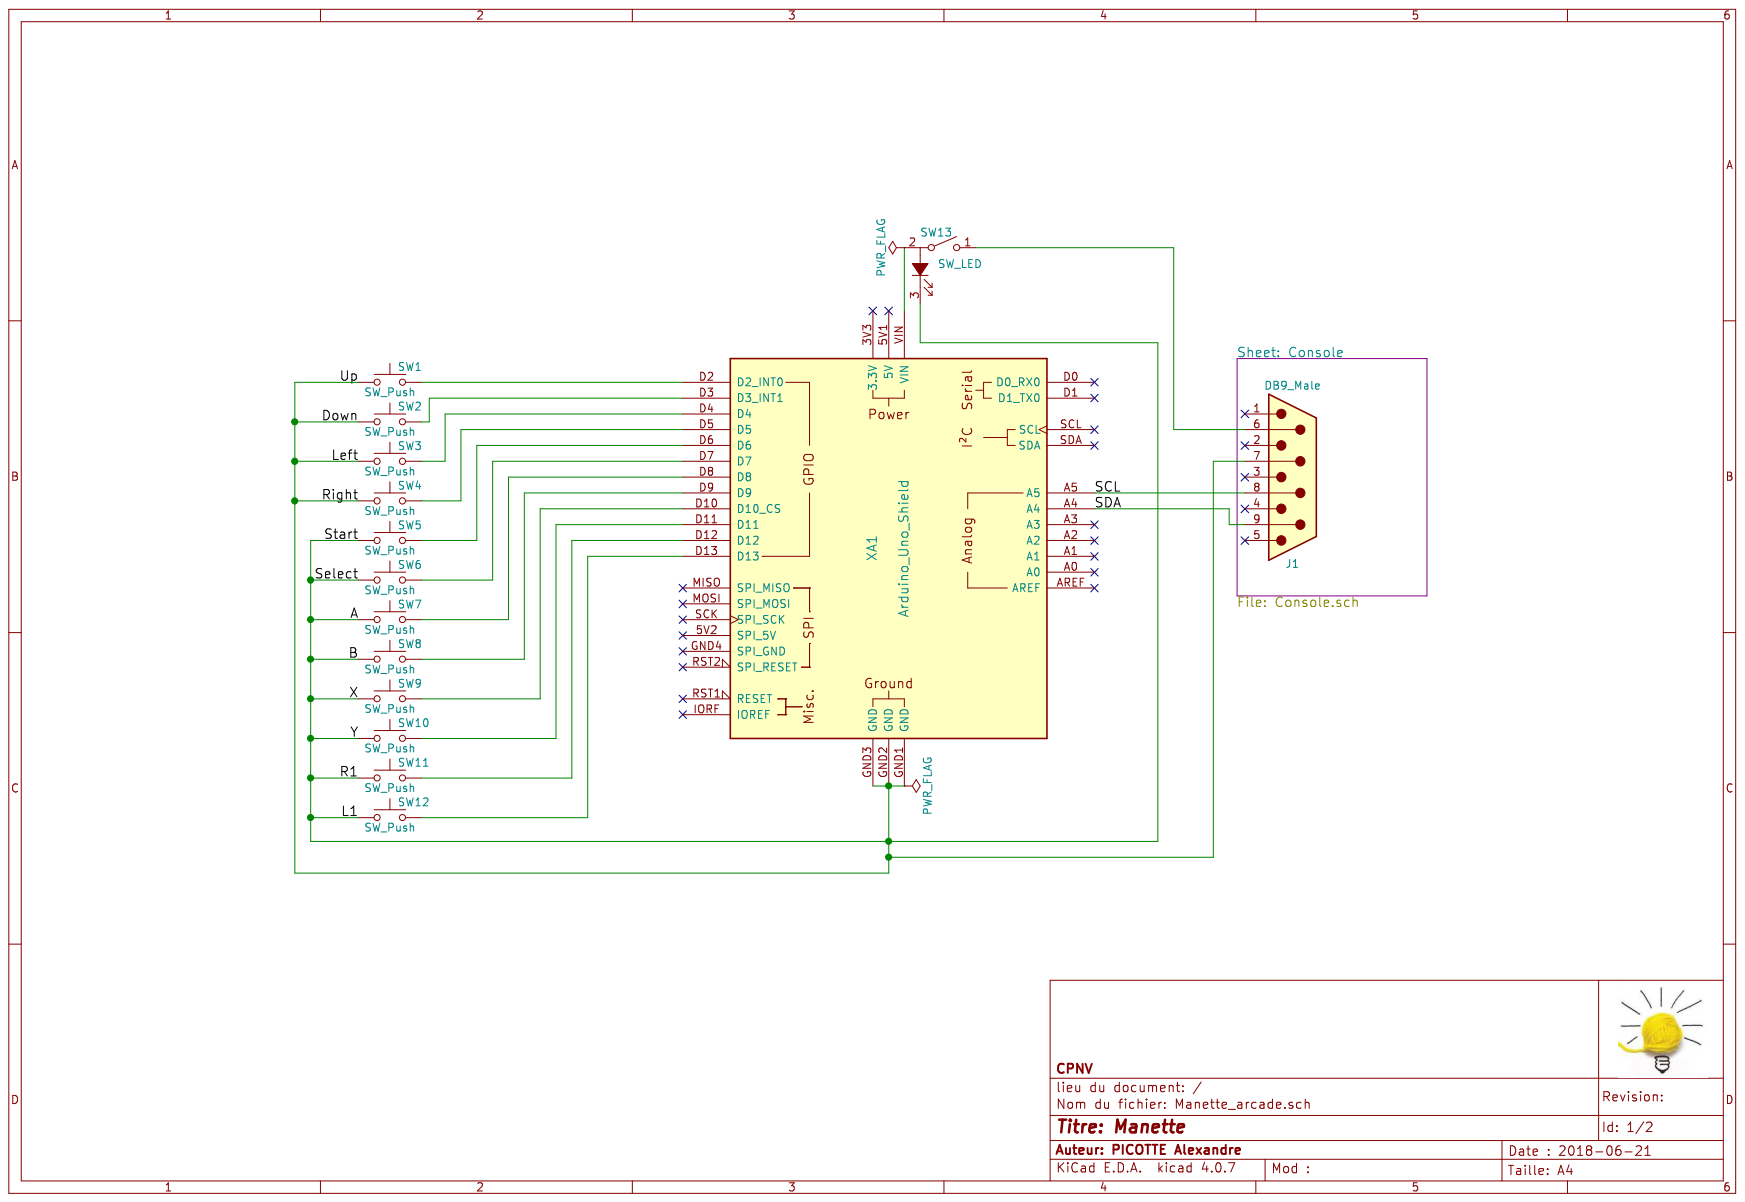
[picture p113: page 1]

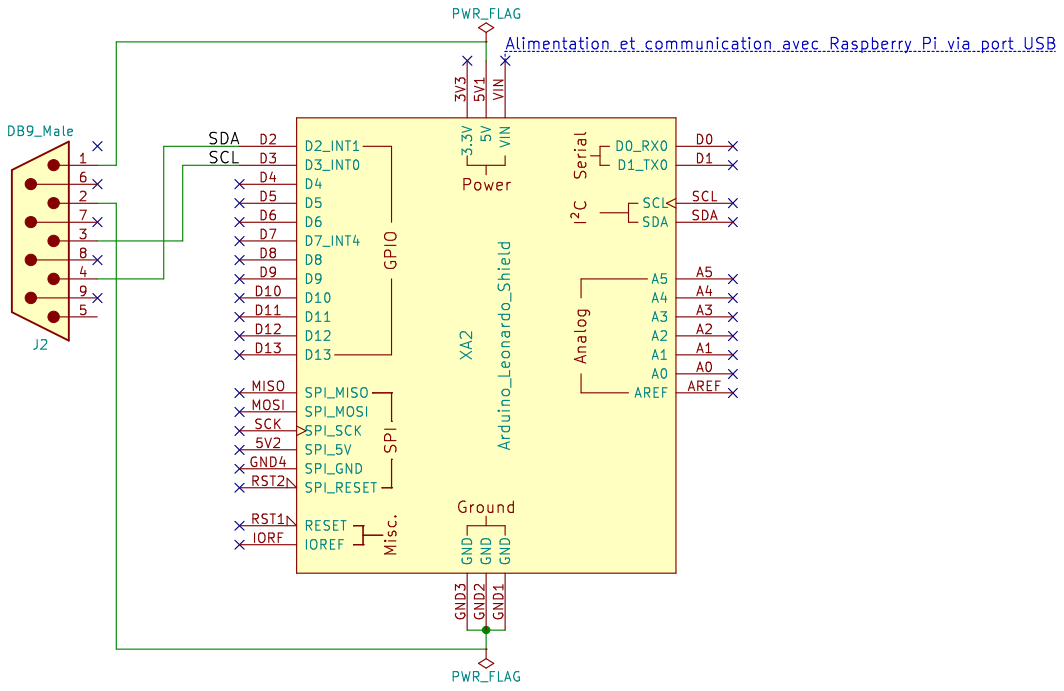
[picture p114: page 2]
