JoanMaillard/Manette/07_Schémas/PCB Boutons/PDFs/Schéma_électrique_boutons.pdf

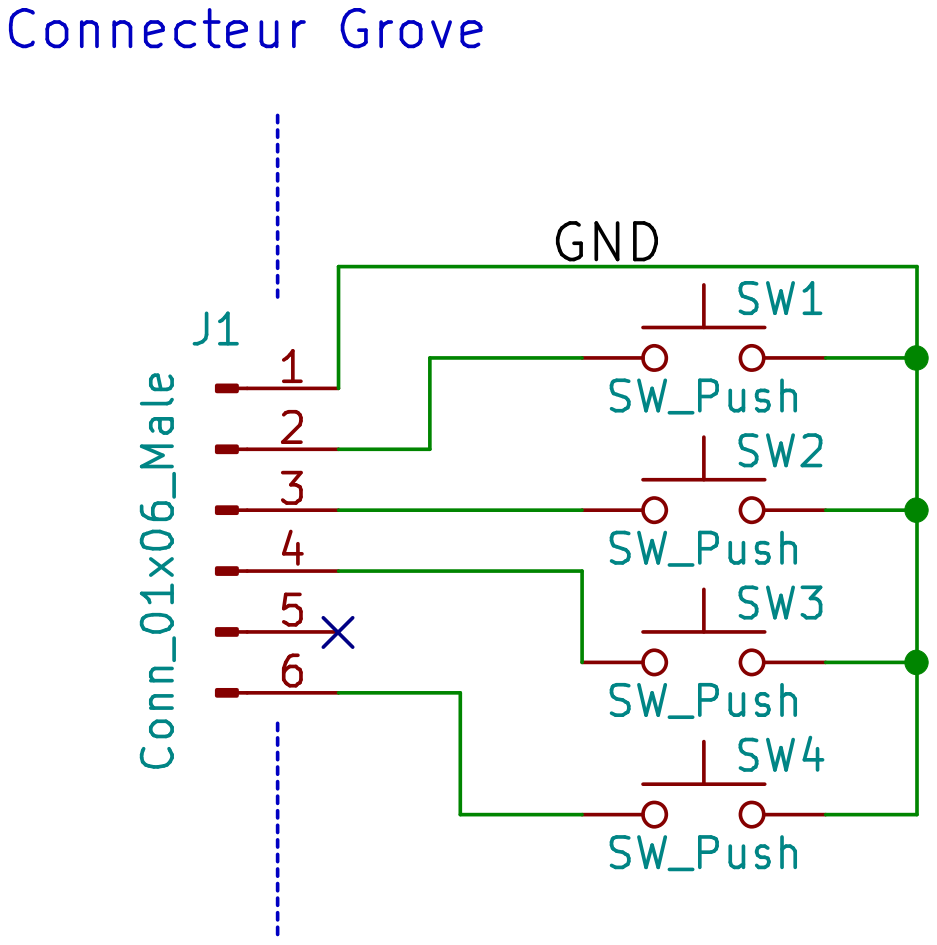
[picture p121: page 1]
