JoanMaillard/Manette/07_Schémas/Polymanette Chevalier/PDFs/PCB_chevalier.pdf

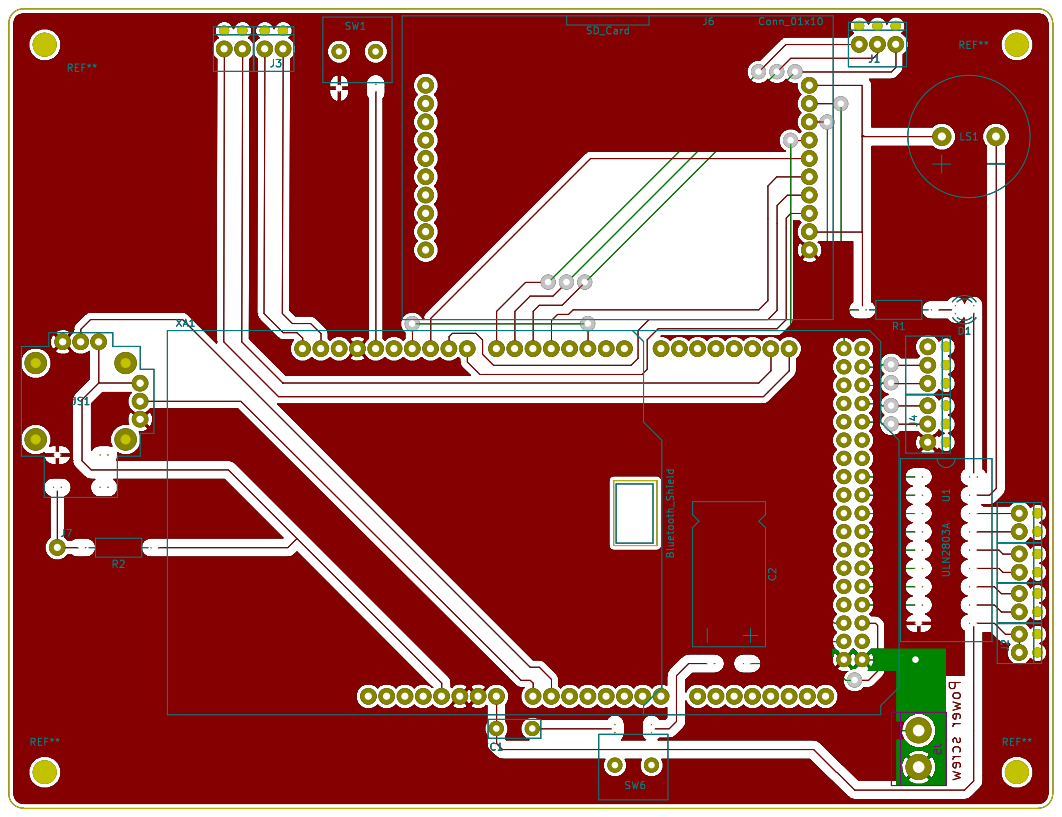
[picture p122: page 1]

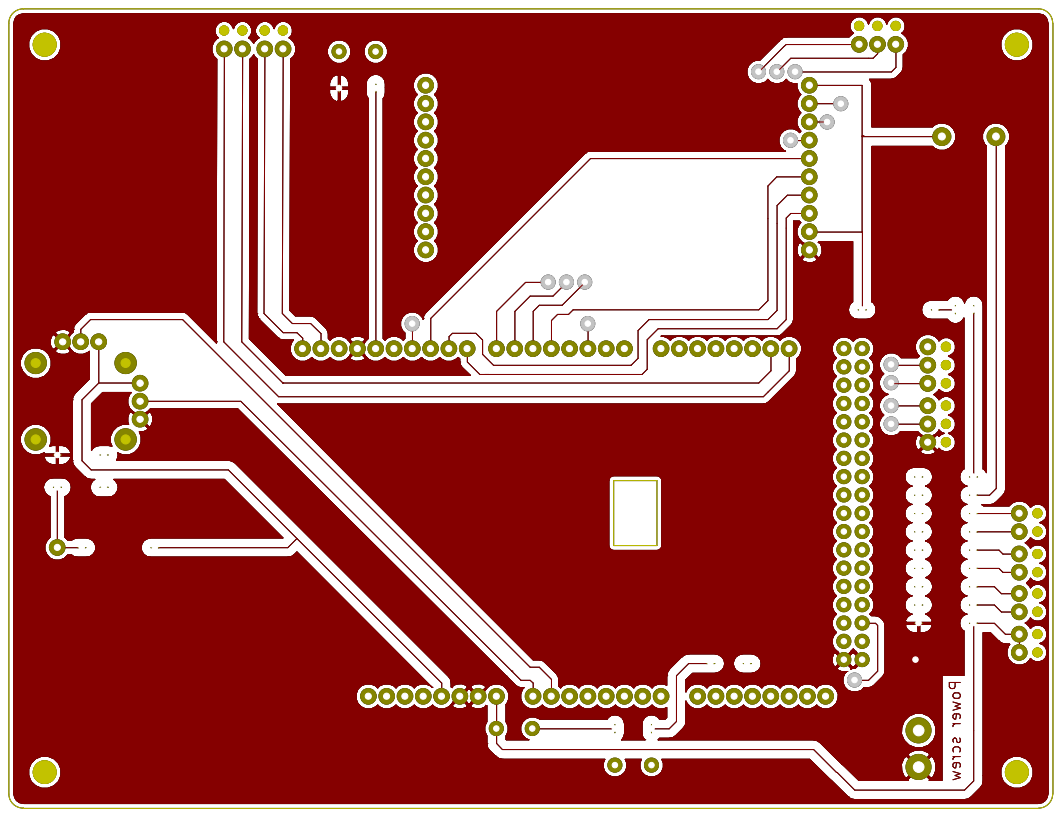
[picture p123: page 2]

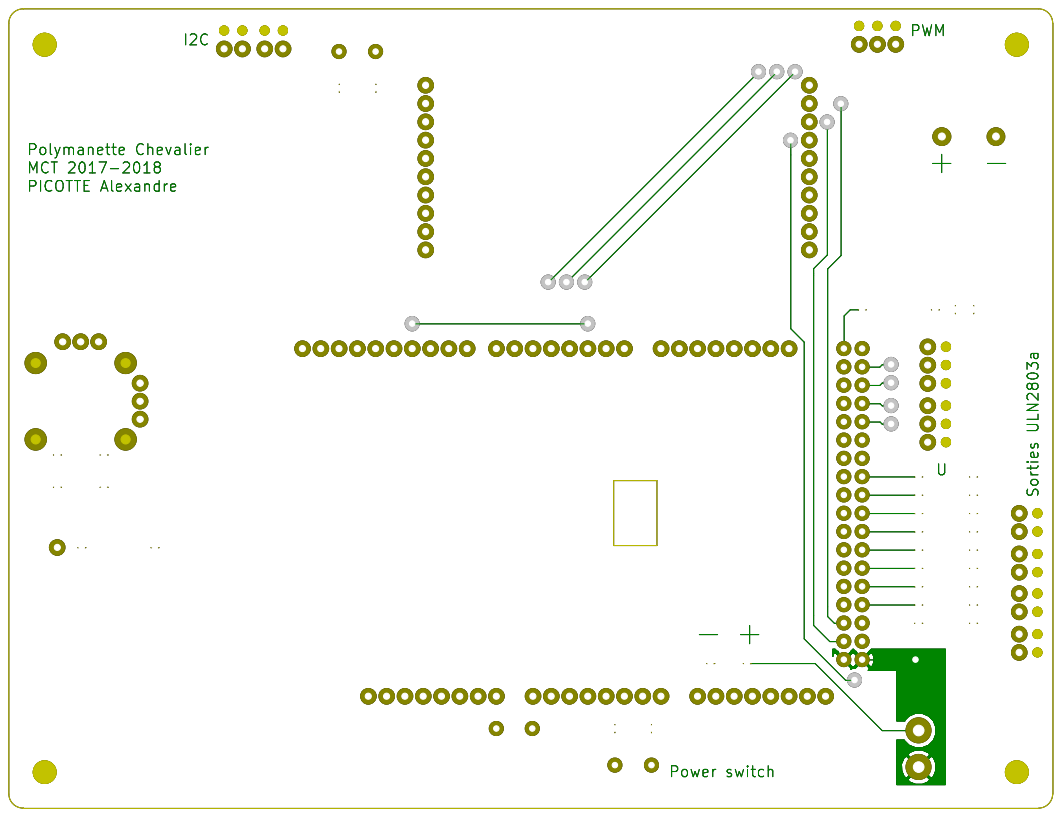
[picture p124: page 3]

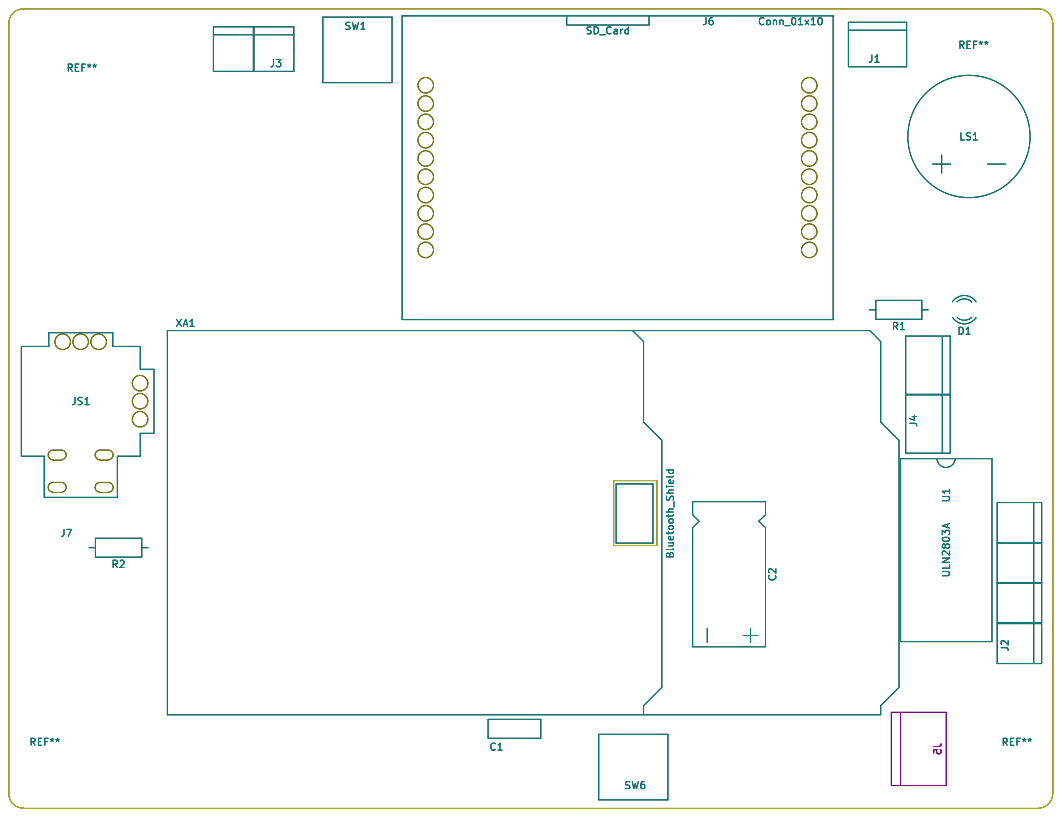
[picture p125: page 4]

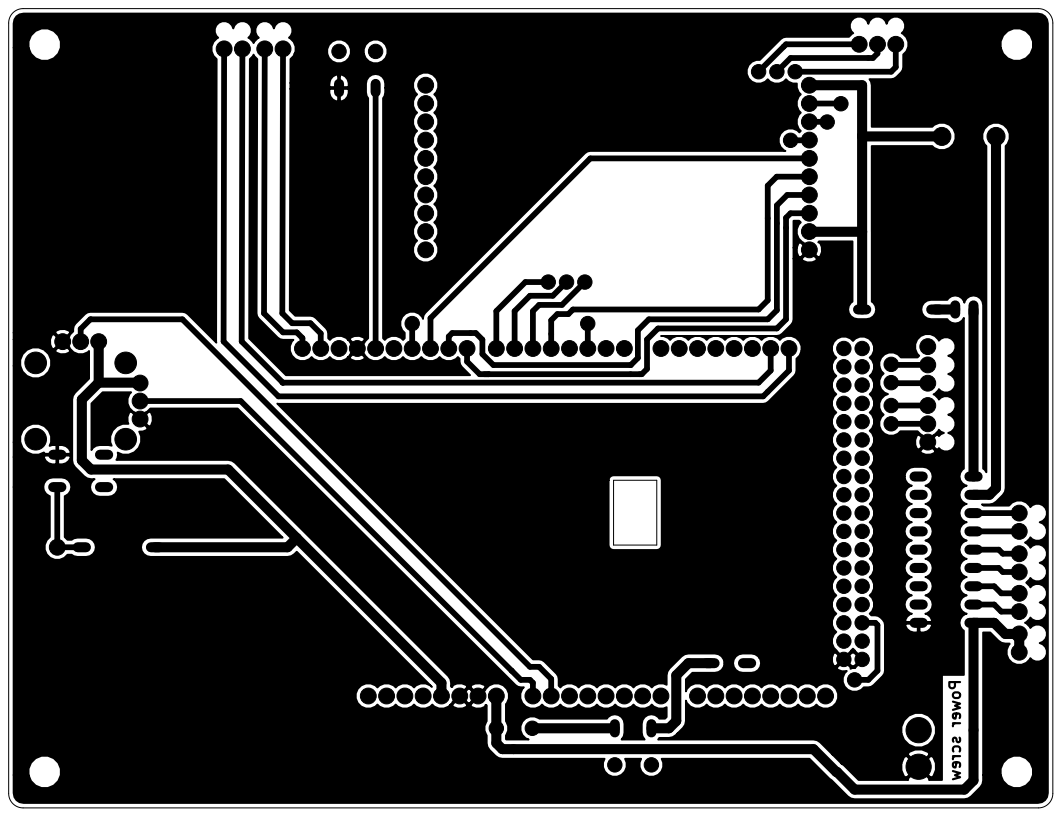
[picture p126: page 5]

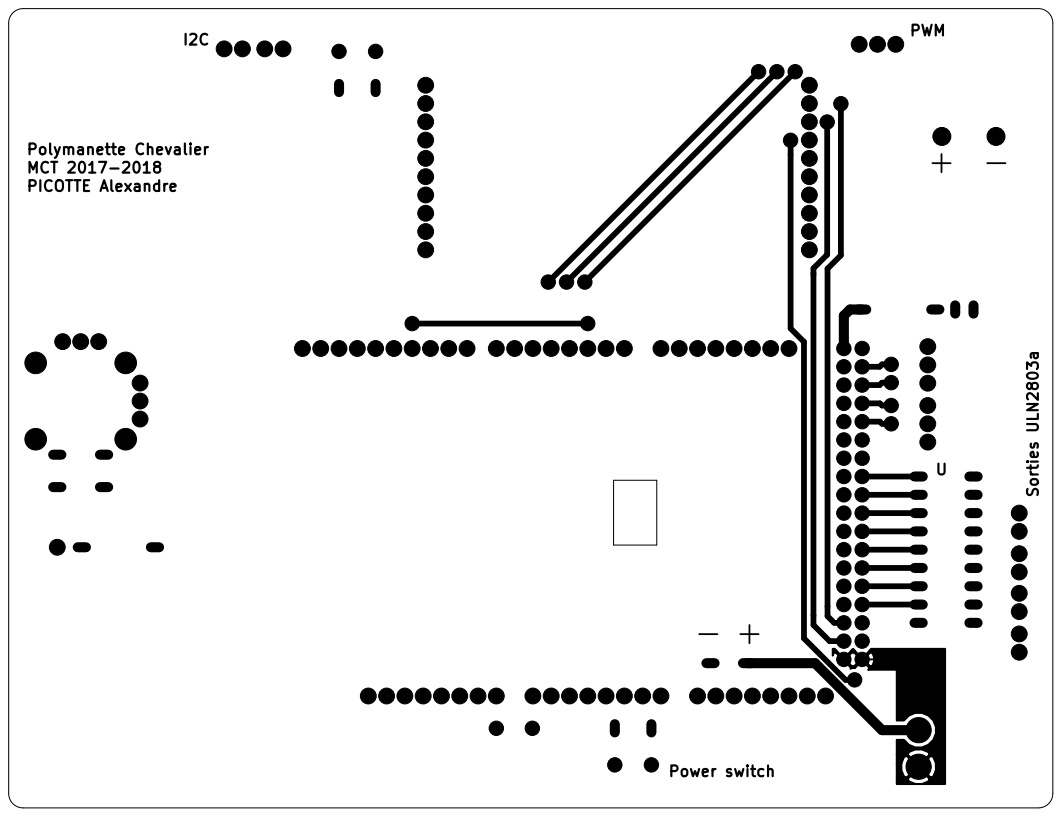
[picture p127: page 6]
