JoanMaillard/Manette/07_Schémas/Polymanette Chevalier/PDFs/PCB_chevalier_CORRIGÉ.pdf

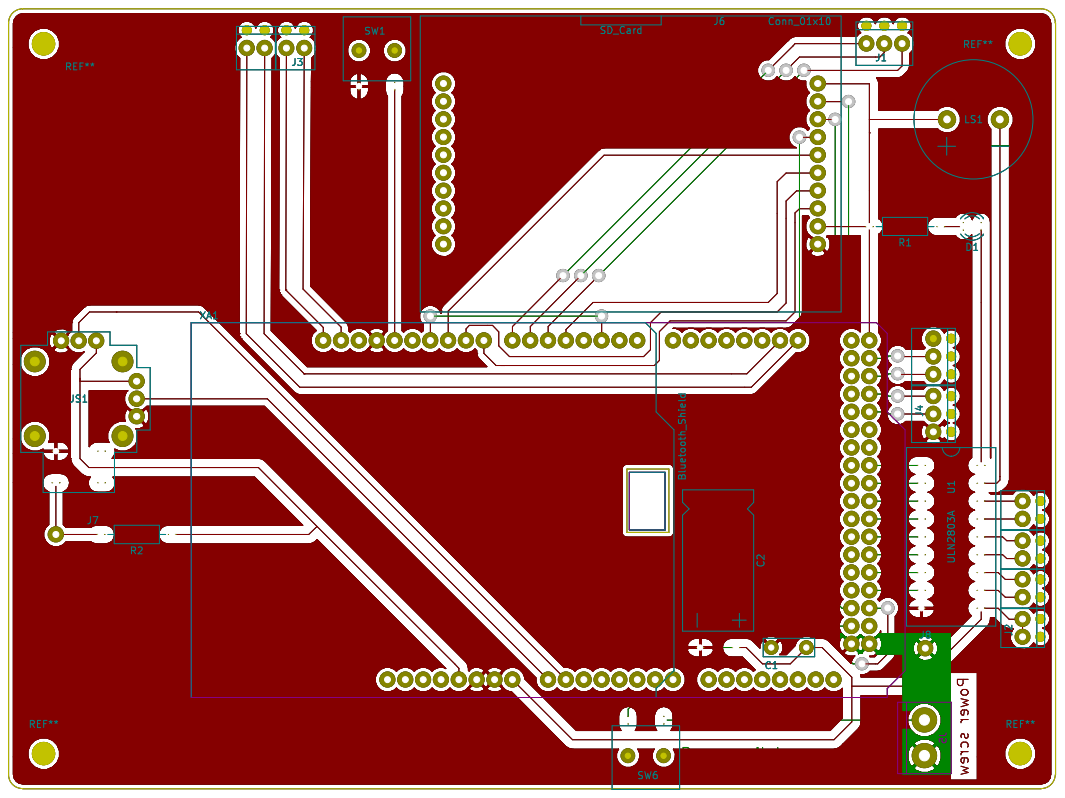
[picture p128: page 1]

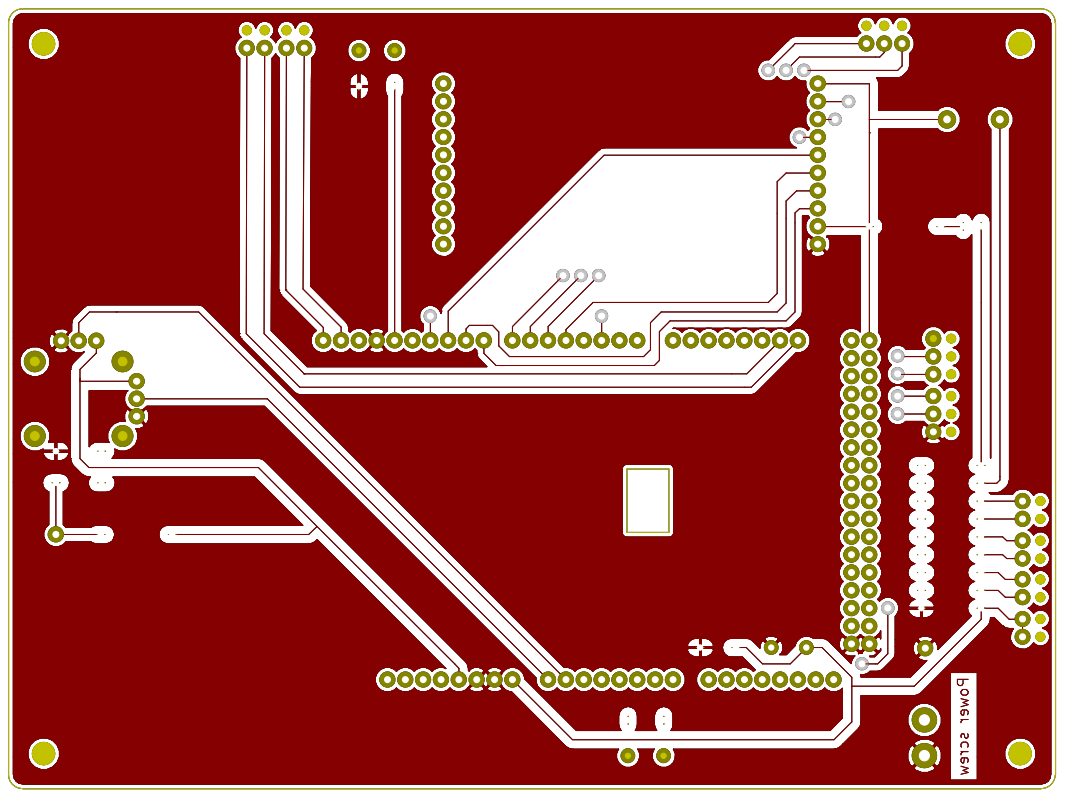
[picture p129: page 2]

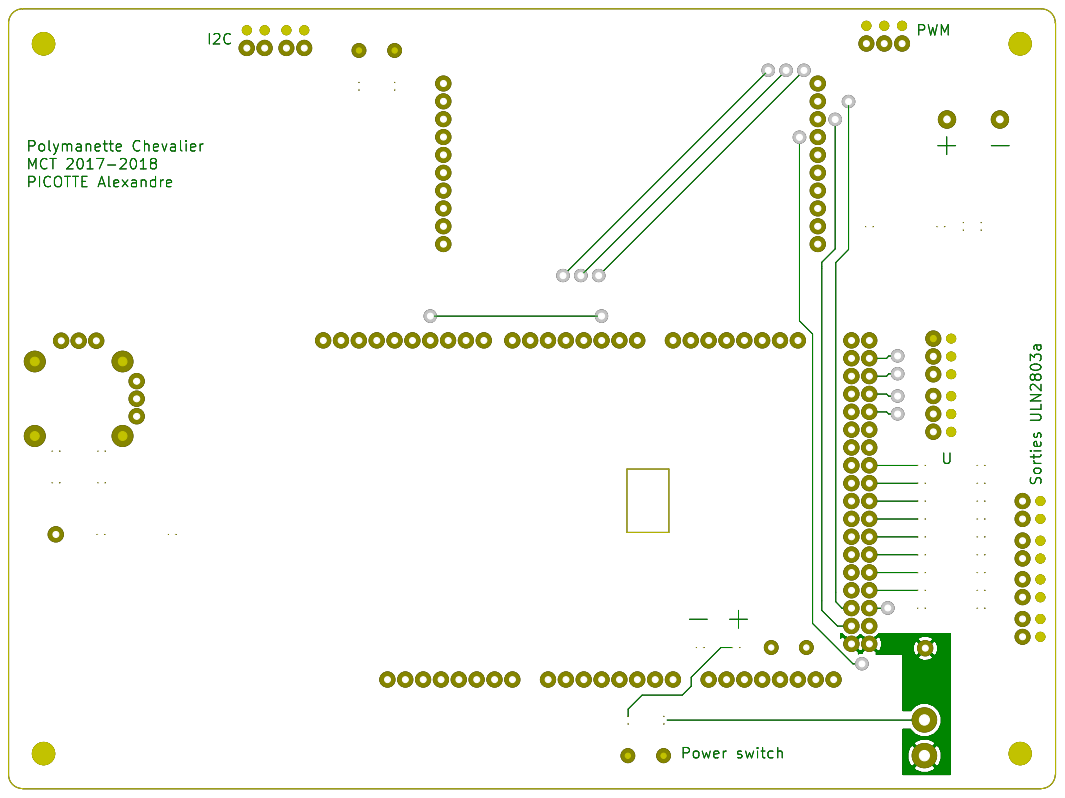
[picture p130: page 3]

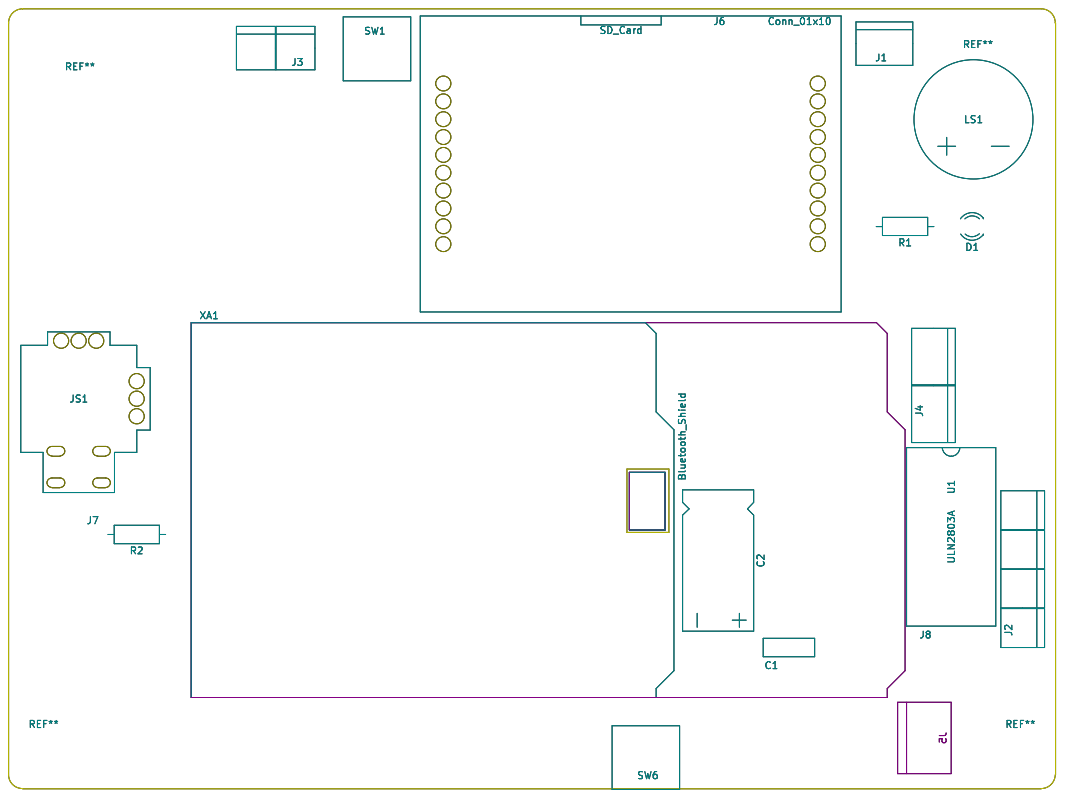
[picture p131: page 4]

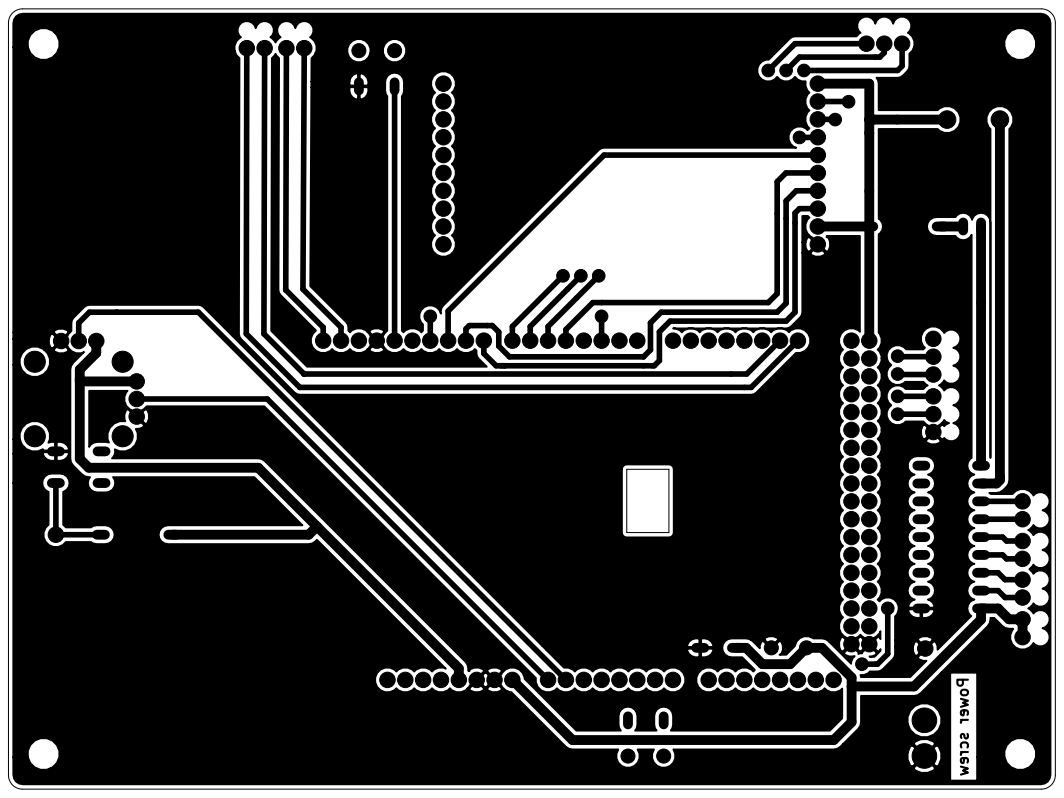
[picture p132: page 5]

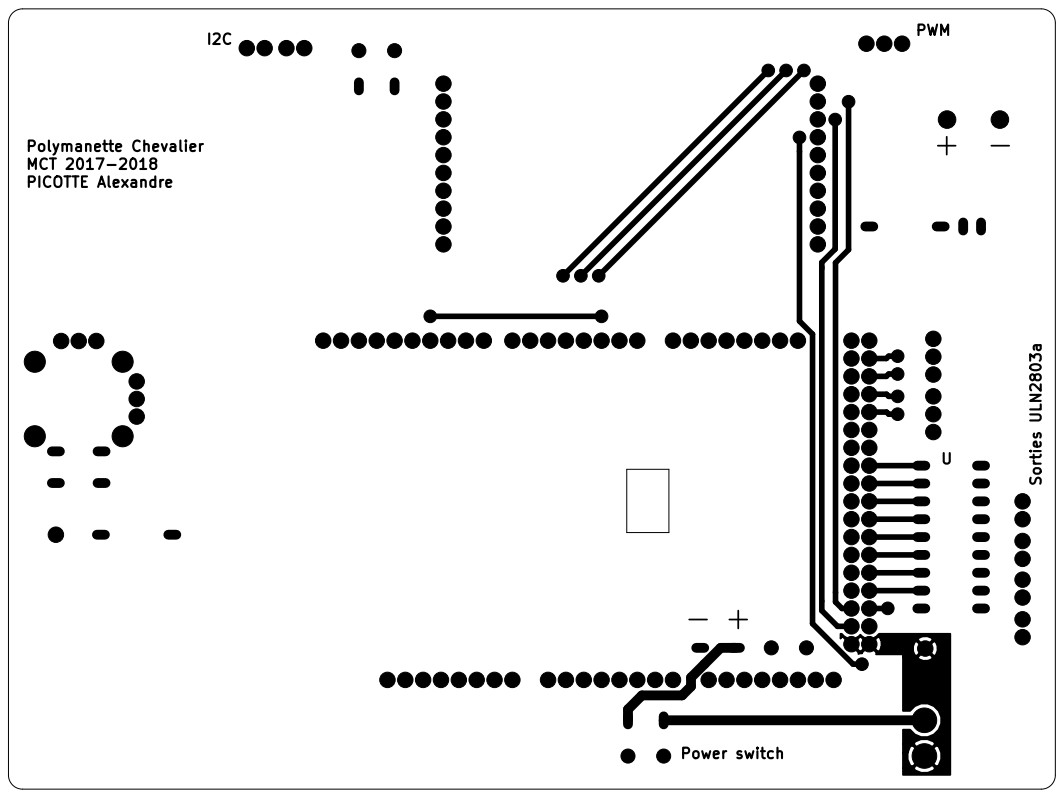
[picture p133: page 6]
