JoanMaillard/Manette/07_Schémas/Polymanette Chevalier/PDFs/Schéma_électrique_chevalier.pdf

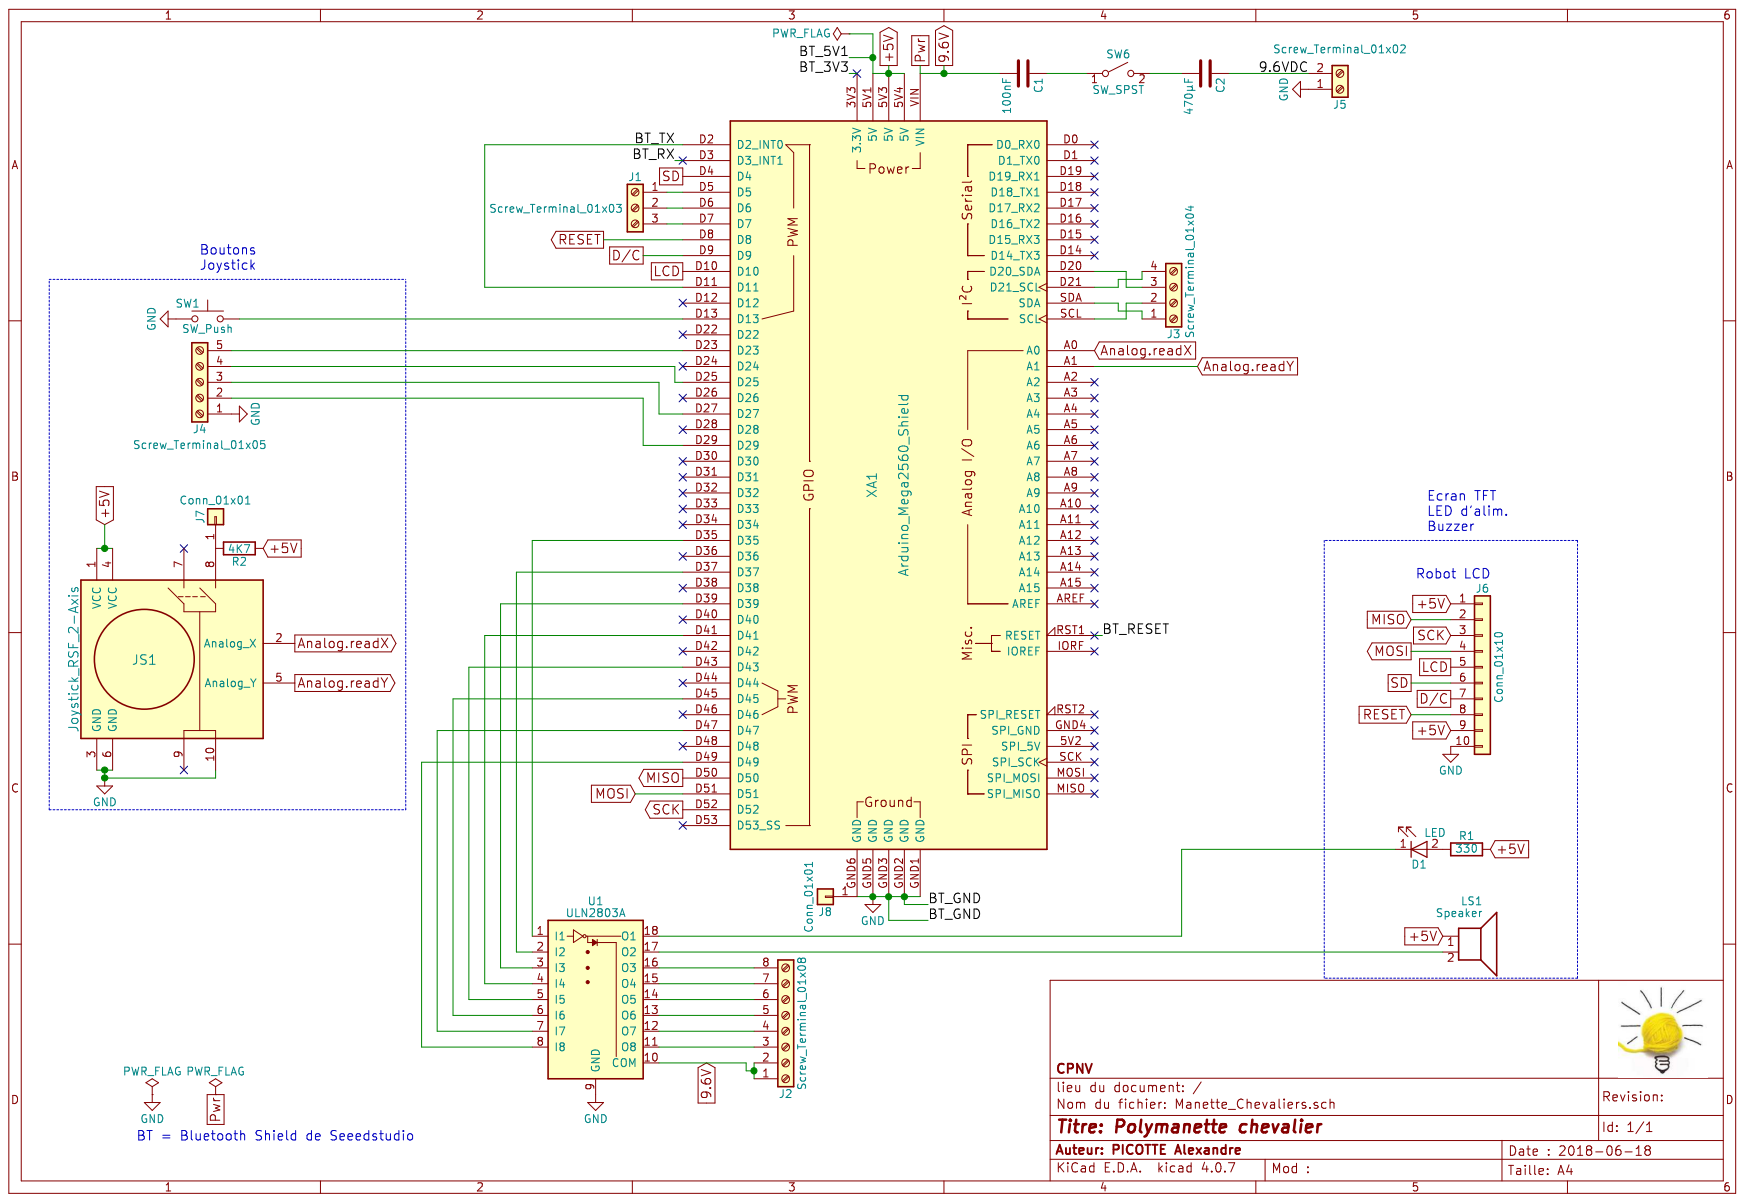
[picture p134: page 1]
