JoanMaillard/Manette/07_Schémas/Polymanette Chevalier/PDFs/Schéma_électrique_chevalier_CORRIGÉ.pdf

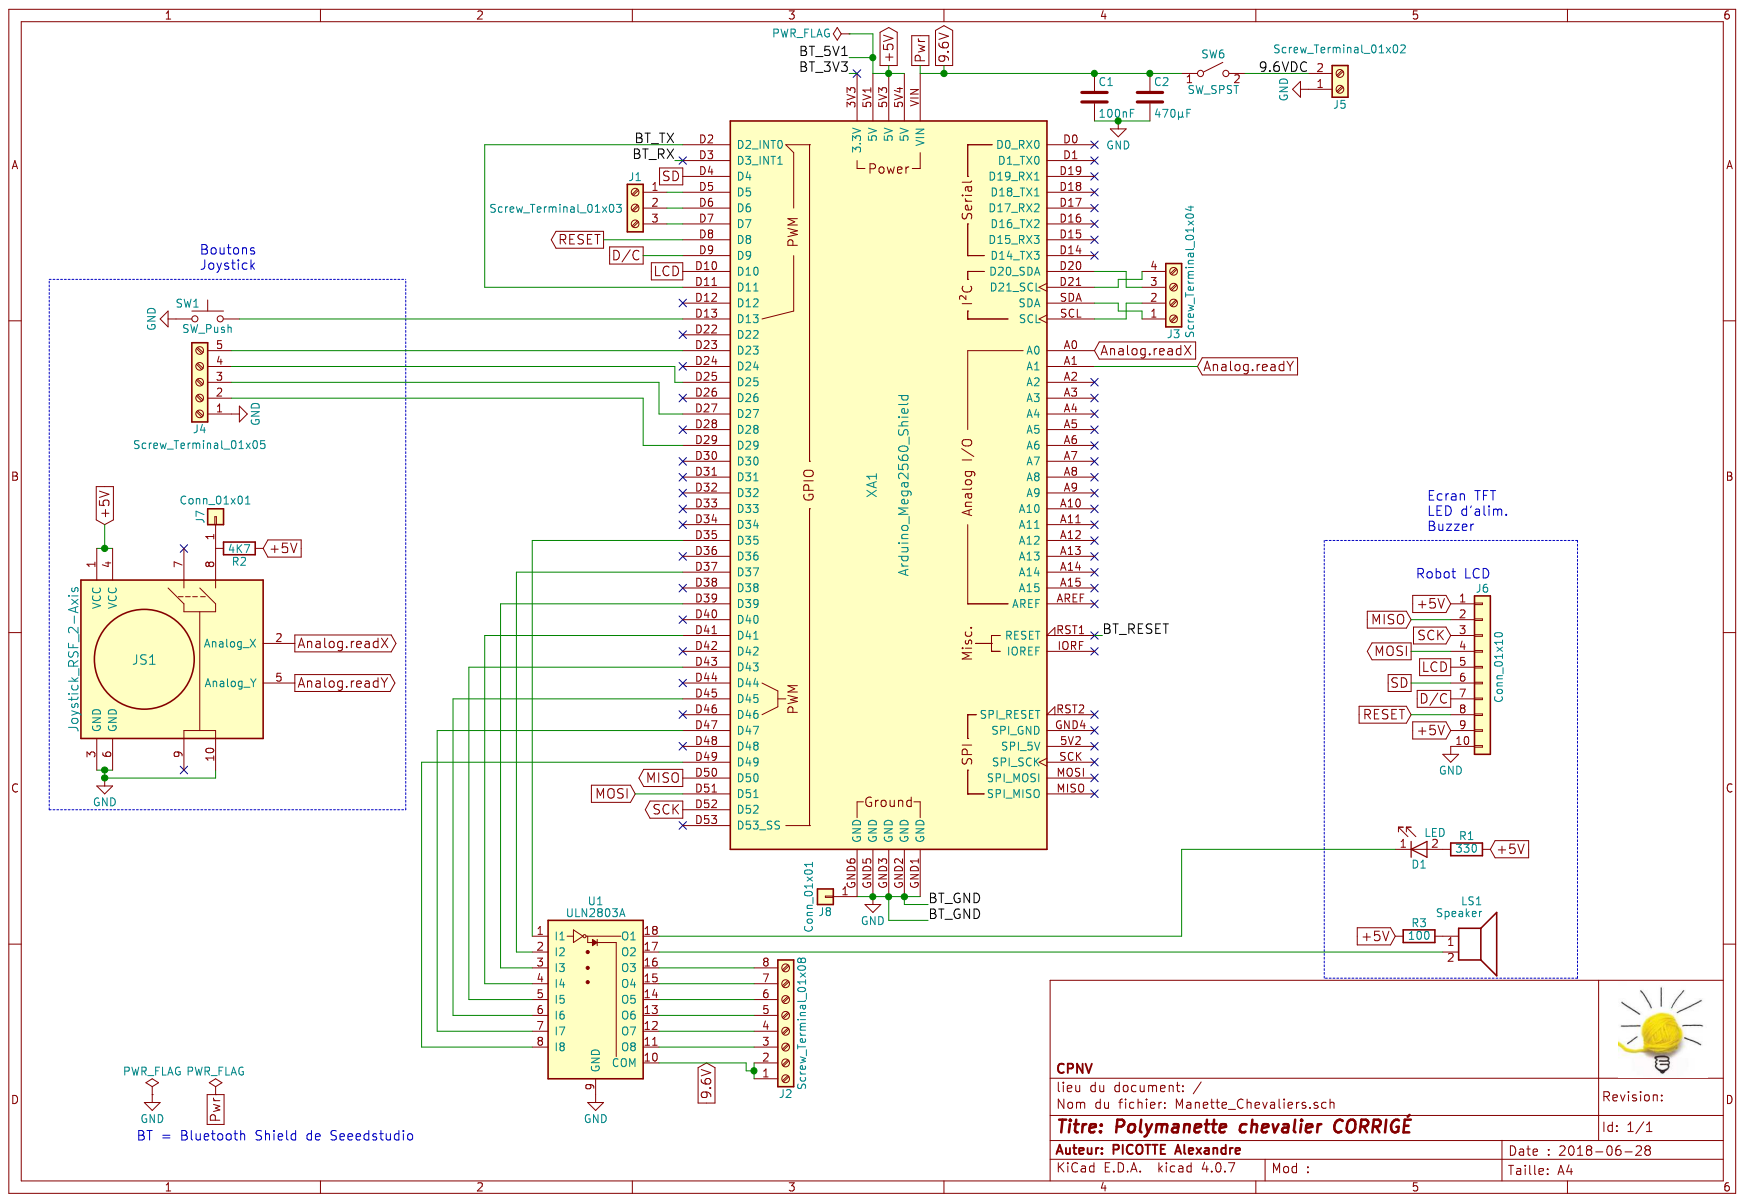
[picture p135: page 1]
