JoanMaillard/Manette/07_Schémas/Polymanette Table à lévitation/PDFs/PCB_table.pdf

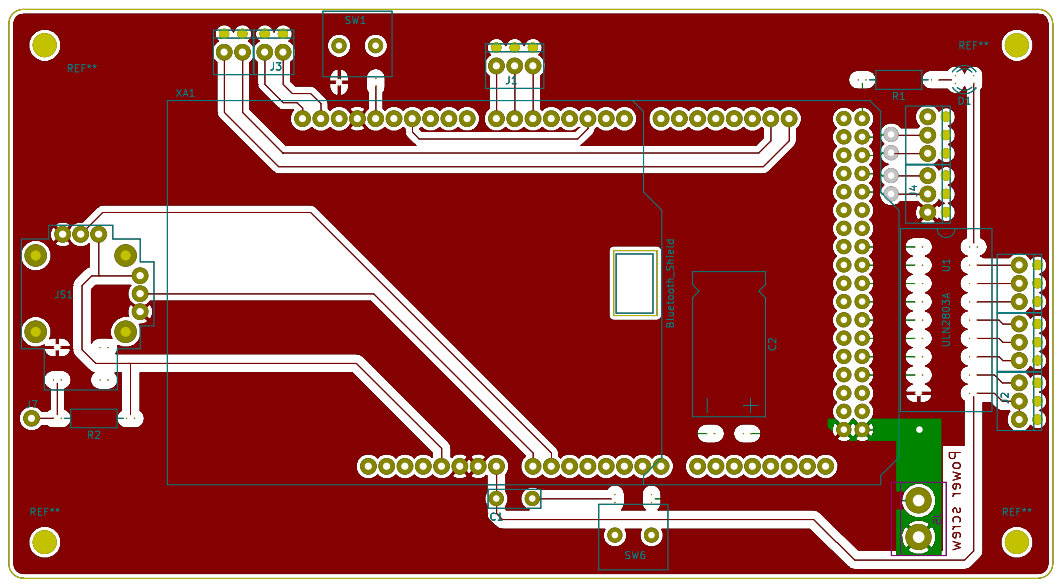
[picture p136: page 1]

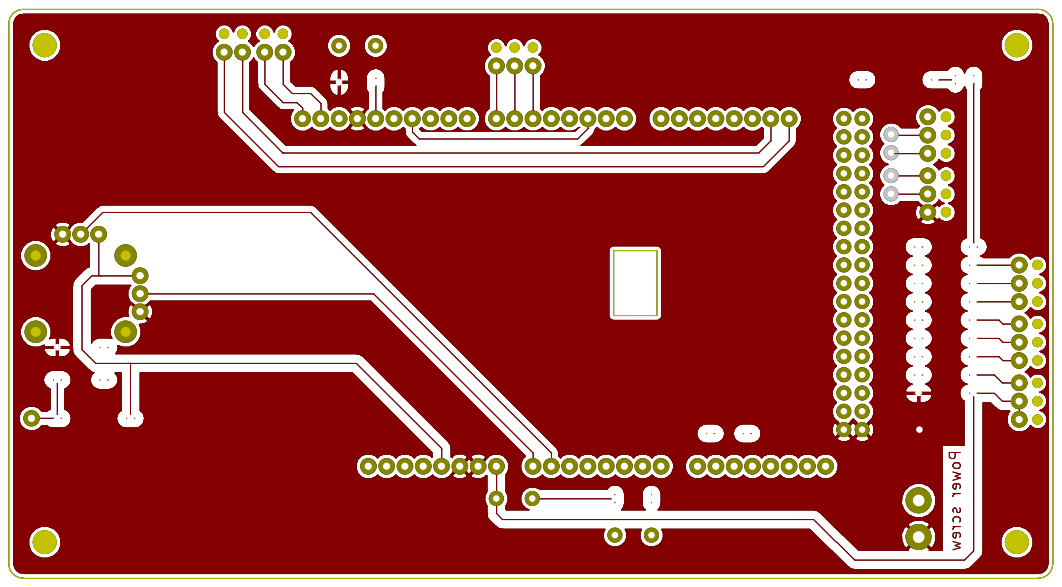
[picture p137: page 2]

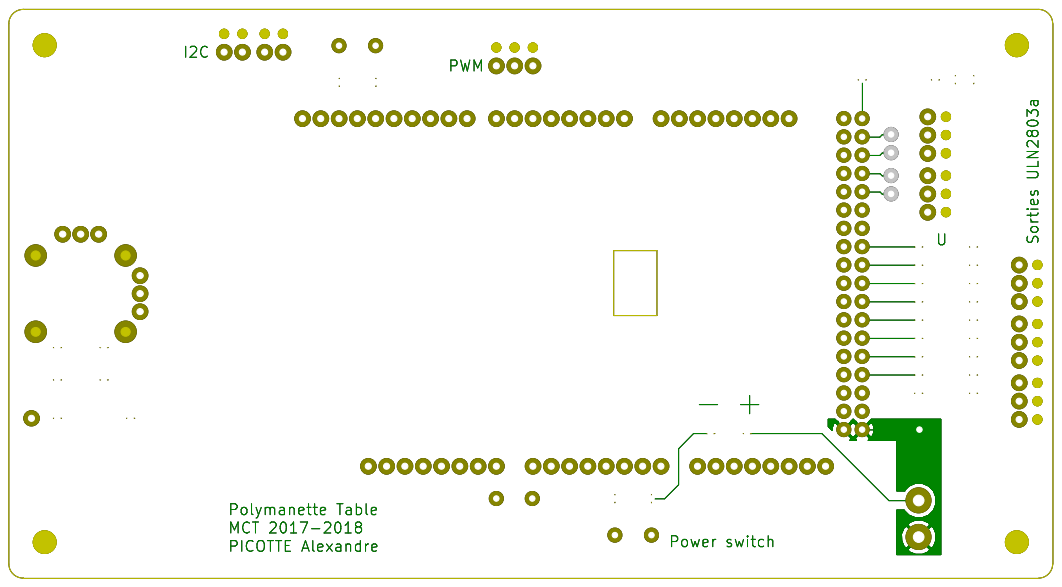
[picture p138: page 3]

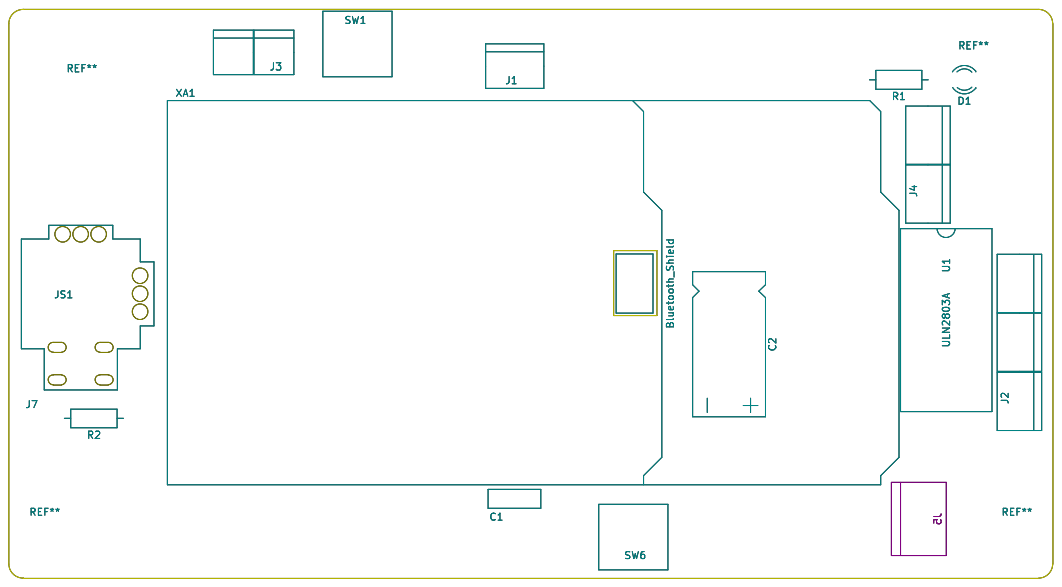
[picture p139: page 4]

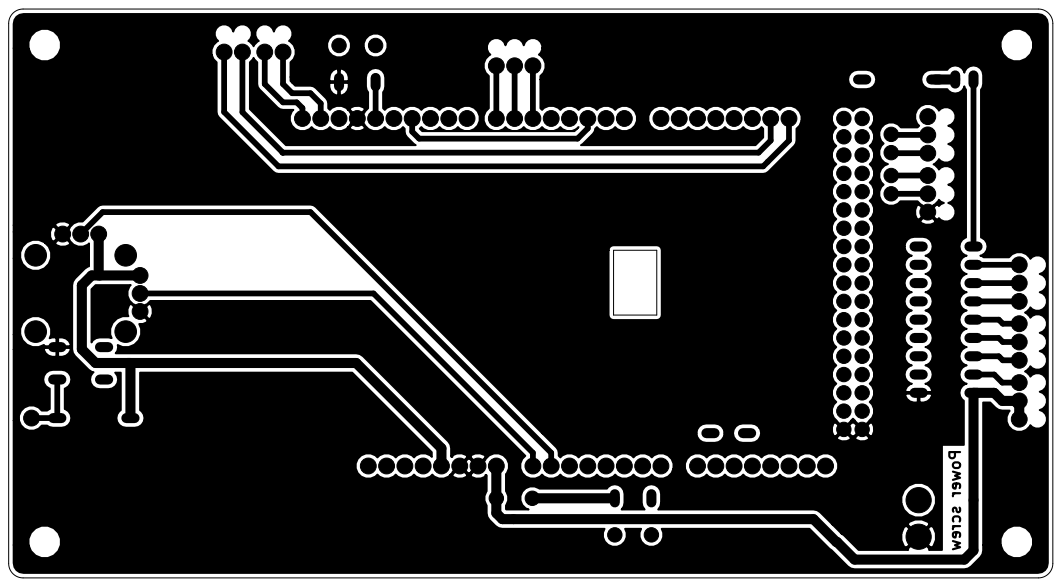
[picture p140: page 5]

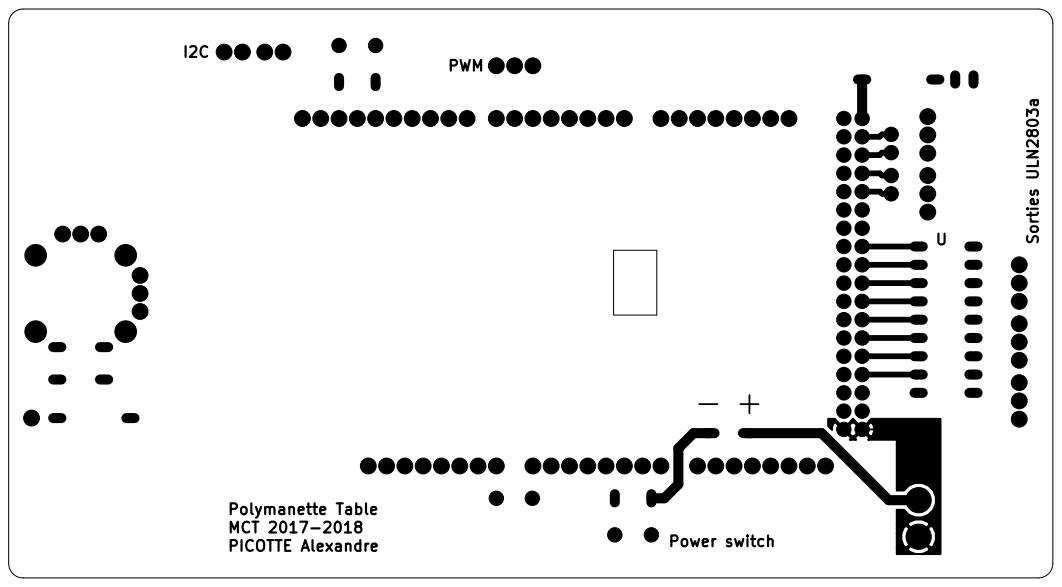
[picture p141: page 6]
