JoanMaillard/Manette/07_Schémas/Polymanette Table à lévitation/PDFs/PCB_table_CORRIGÉ.pdf

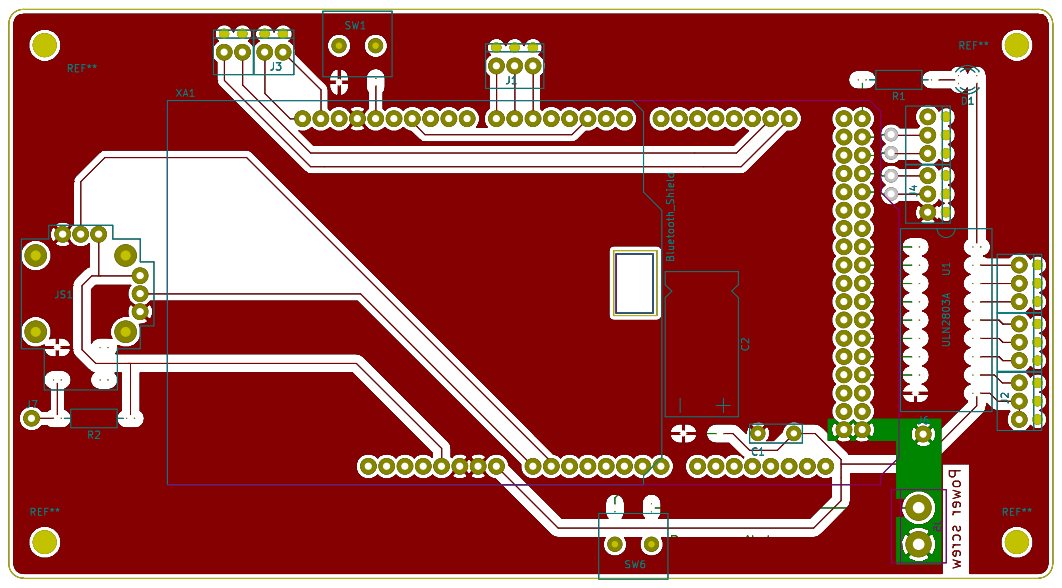
[picture p142: page 1]

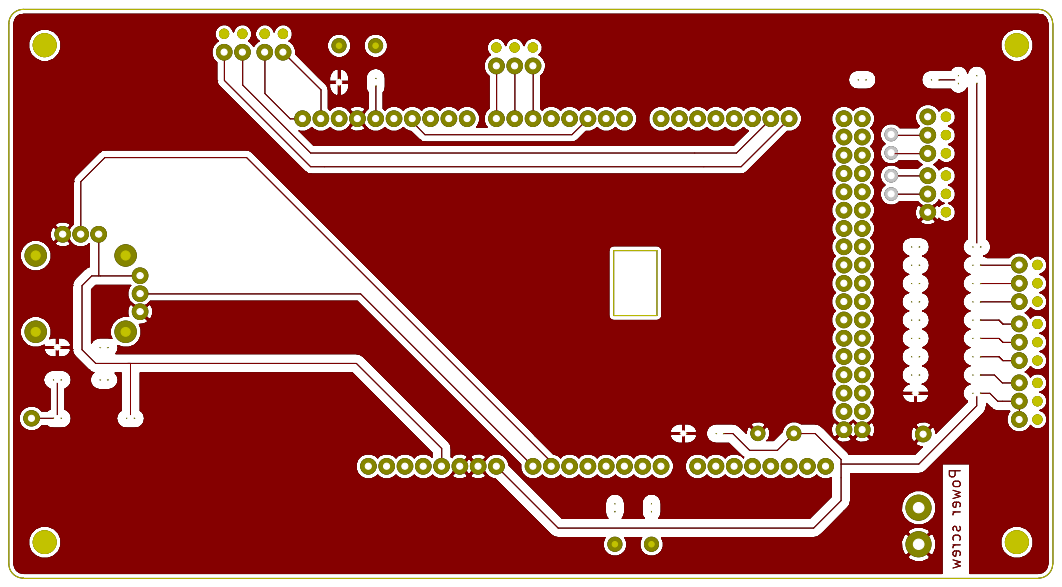
[picture p143: page 2]

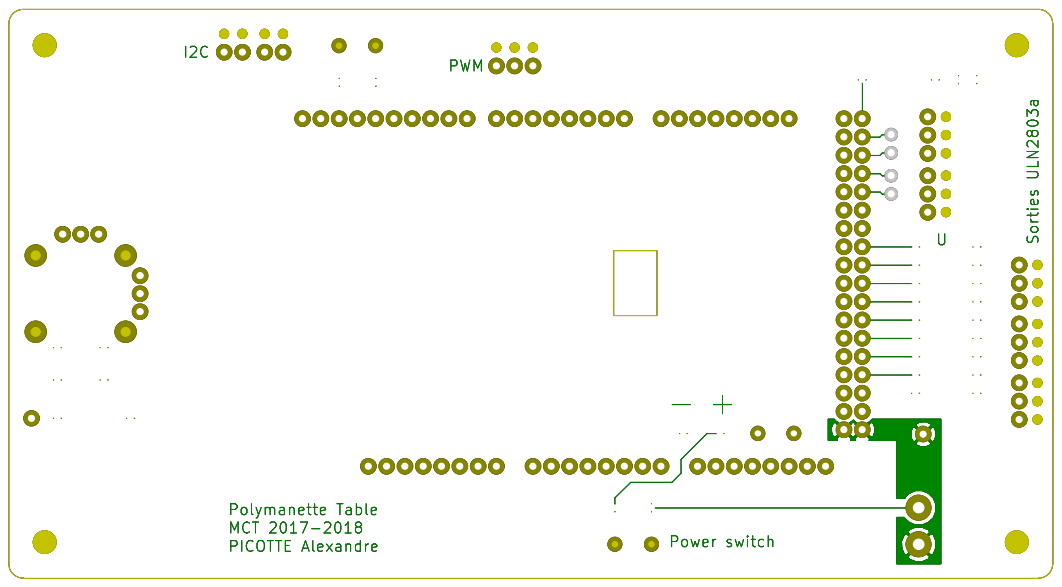
[picture p144: page 3]

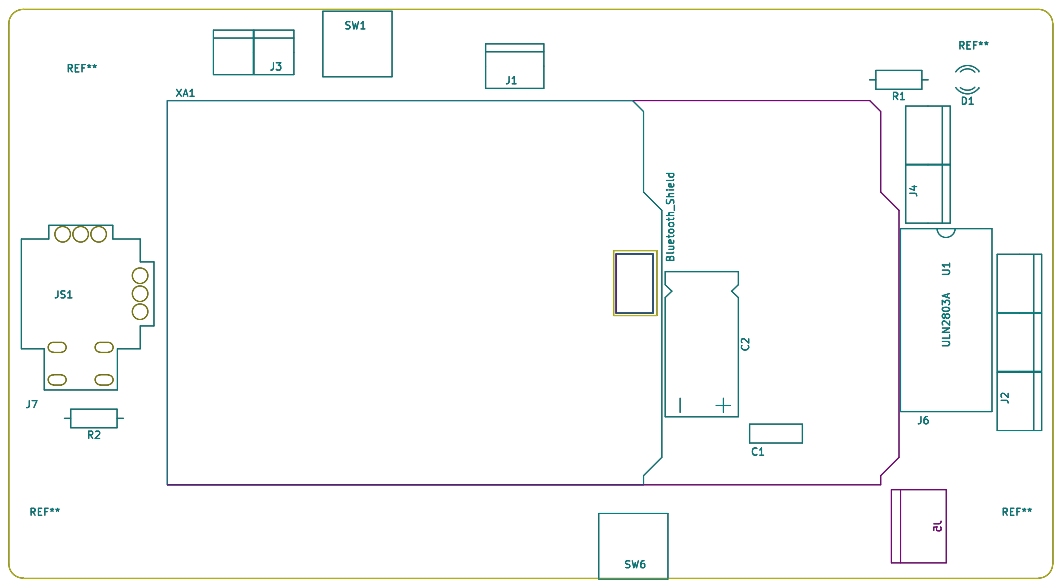
[picture p145: page 4]

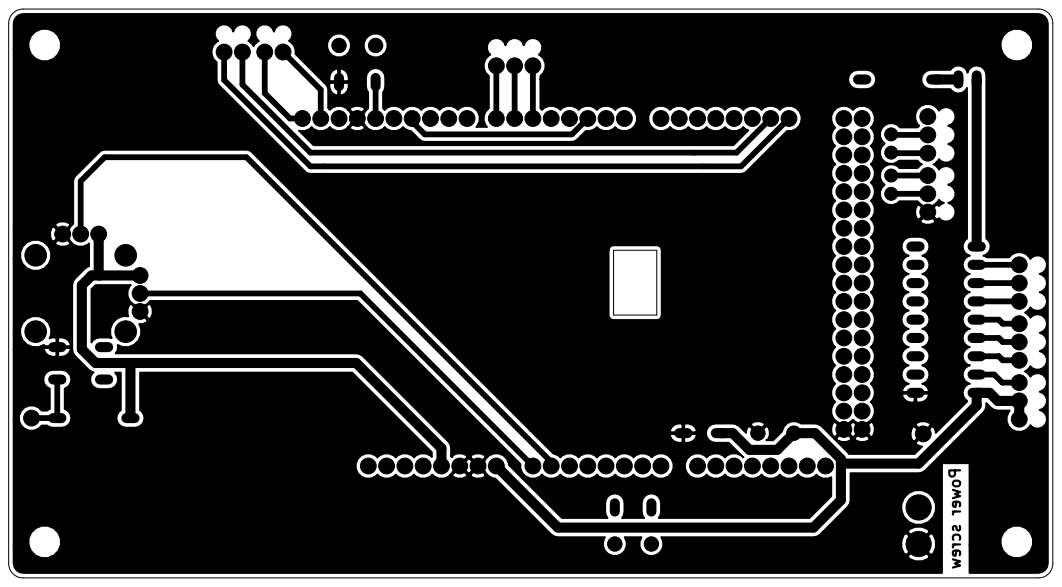
[picture p146: page 5]

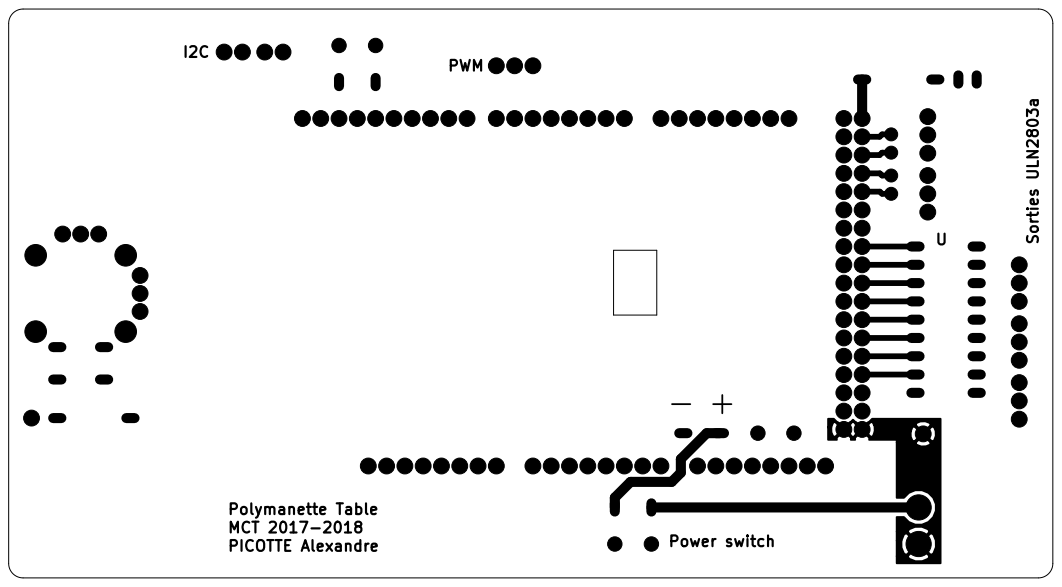
[picture p147: page 6]
