JoanMaillard/Manette/07_Schémas/Polymanette Table à lévitation/PDFs/Schéma_électrique_table.pdf

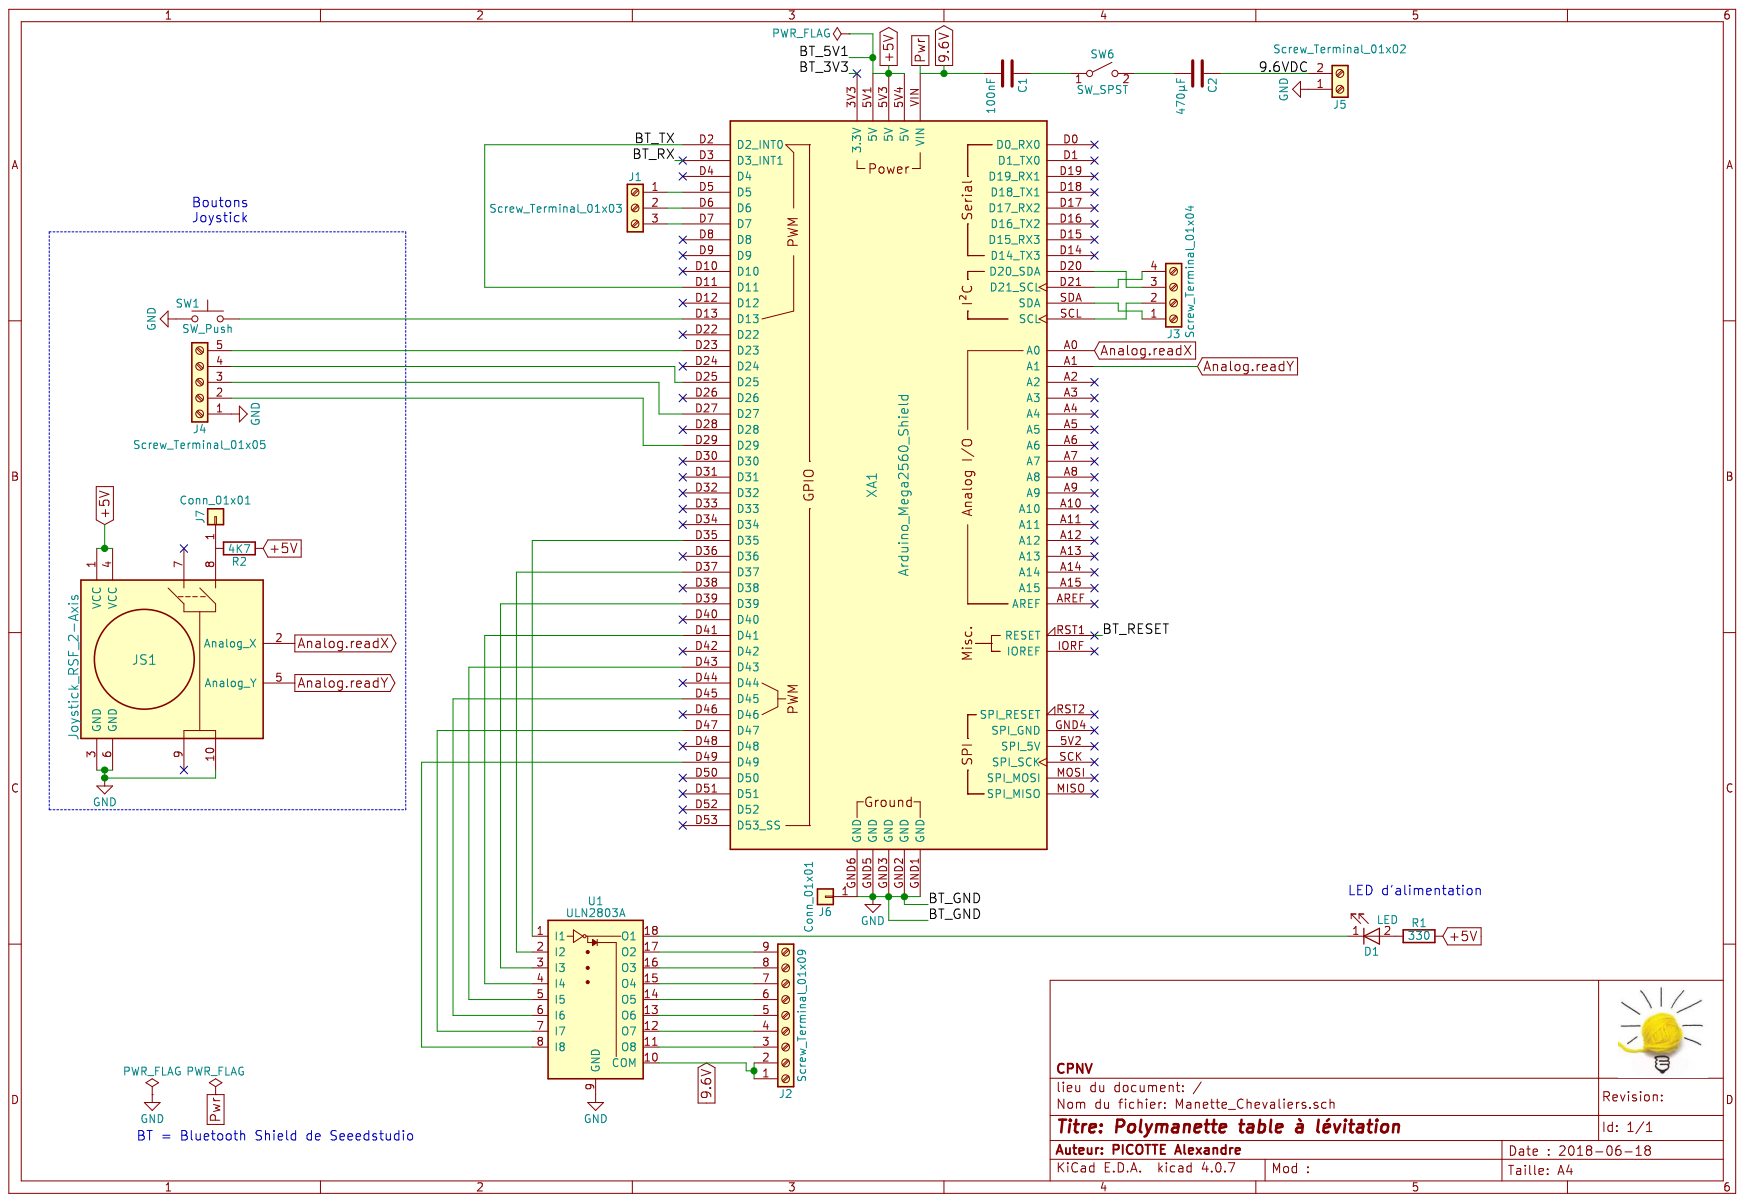
[picture p148: page 1]
