JoanMaillard/Manette/07_Schémas/Polymanette Table à lévitation/PDFs/Schéma_électrique_table_CORRIGÉ.pdf

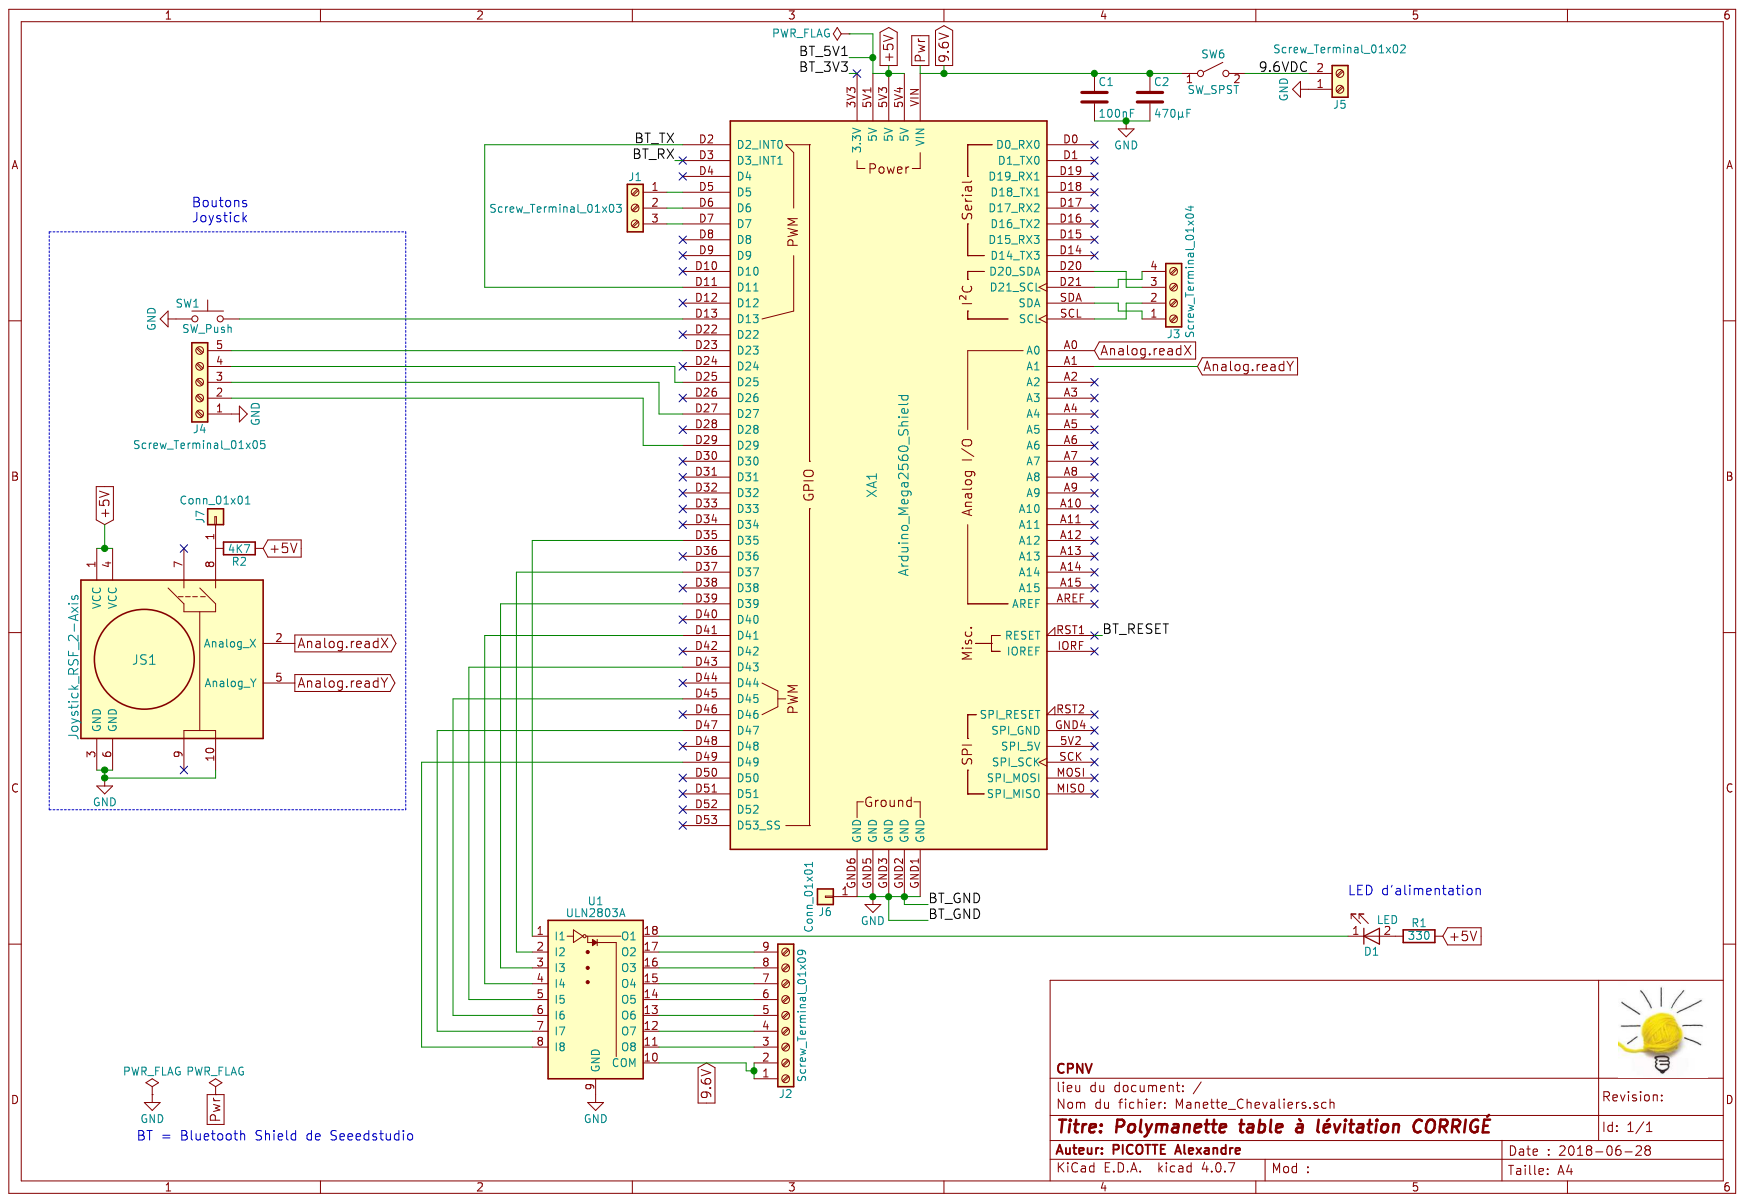
[picture p149: page 1]
