JoanMaillard/Manette/07_Schémas/manette_2019/manette_2019.kicad_pcb

## KiCad design 07_Schémas/manette_2019/manette_2019.kicad_pcb (2019-06-20)

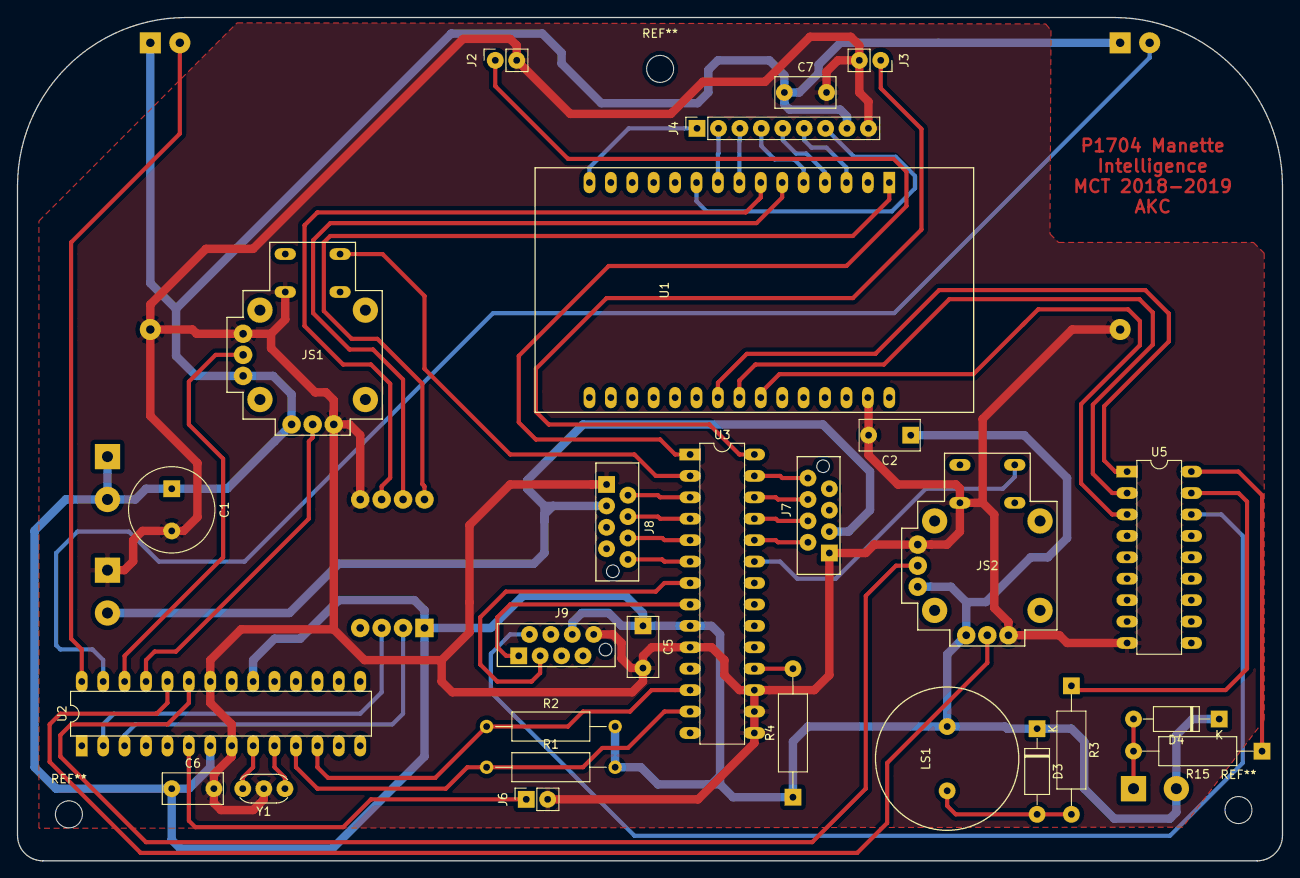
[picture p150: board manette_2019.kicad_pcb from above]

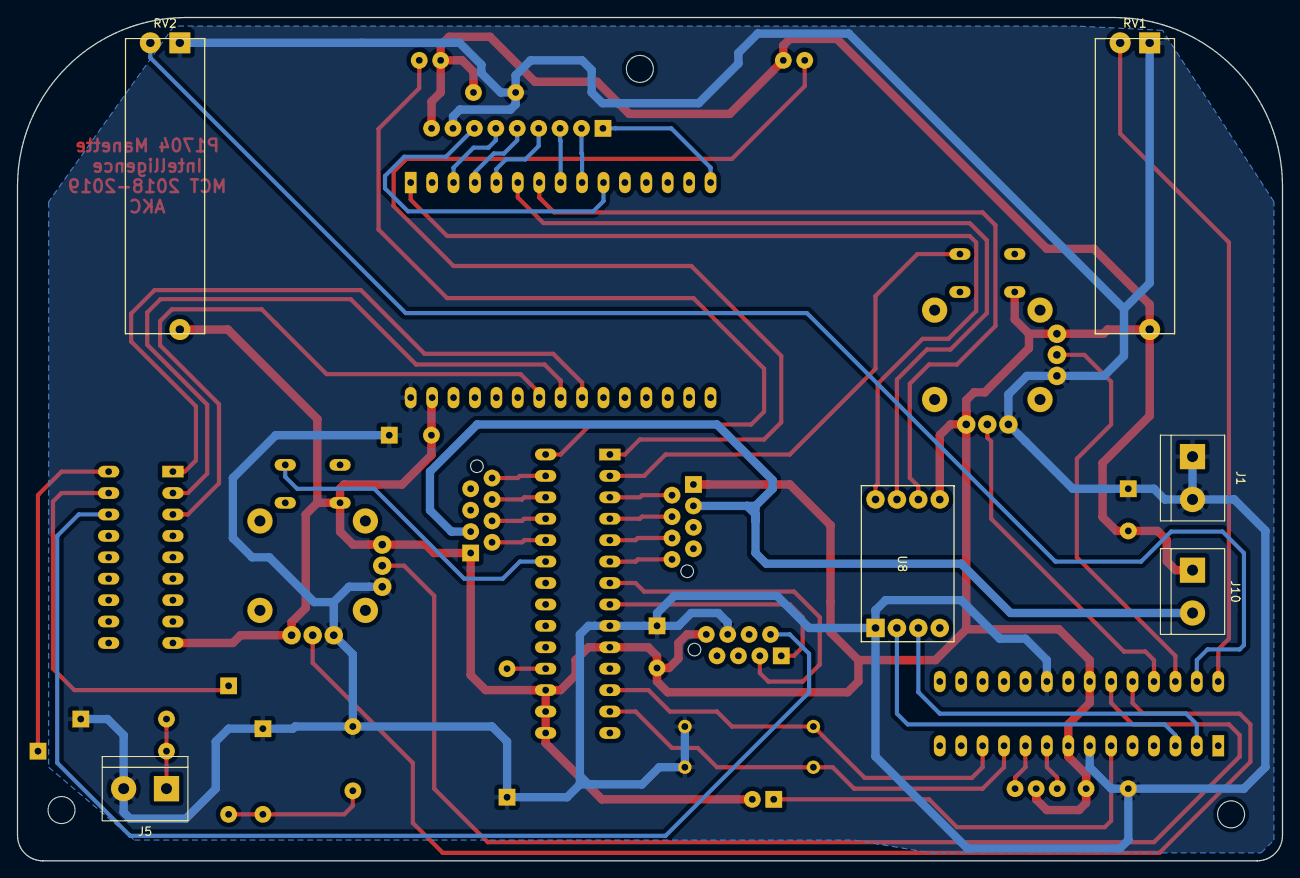
[picture p151: board manette_2019.kicad_pcb from below]

Board: 2 copper layers, 150.0 x 100.0 mm, 33 parts (6 on the bottom side), 49 nets.

Parts:
C1: C; C_Radial_D10.0mm_H20.0mm_P5.00mm
C2, C5, C6, C7: C; C_Rect_L7.0mm_W3.5mm_P5.00mm
D3, D4: D; D_A-405_P10.16mm_Horizontal
J1: Vcc; TerminalBlock_bornier-2_P5.08mm
J2: L_Bumper; PinSocket_1x02_P2.54mm_Vertical
J3: R_Bumper; PinSocket_1x02_P2.54mm_Vertical
J4: OLED_Display; PinSocket_1x09_P2.54mm_Vertical
J5: Rumble; TerminalBlock_bornier-2_P5.08mm
J6: Calib; PinSocket_1x02_P2.54mm_Vertical
J7: Conn_R_Button; Conn_8
J8: Conn_L_Button; Conn_8
J9: Conn_Middle_PCB; Conn_8
J10: Alim_LED; TerminalBlock_bornier-2_P5.08mm
JS1: Joystick_Left; Joystick_RSF_2-axis
JS2: Joystick_Right; Joystick_RSF_2-axis
LS1: Speaker; Buzzer_T135
R1, R2, R3, R4, R15: R; R_Axial_DIN0309_L9.0mm_D3.2mm_P15.24mm_Horizontal
RV1: L_POT; Potentiomètre linéaire
RV2: R_POT; Potentiomètre linéaire
U1: ESP32
U2: ATmega328-PU; DIP-28_W7.62mm
U3: MCP23017; DIP-28_W7.62mm
U5: ULN2803A; DIP-18_W7.62mm
U8: PCA9306
Y1: Resonator; Resonator-3Pin_W6.0mm_H3.0mm

Connections:
+3.3V: U1.1, U8.8
+5V: C1.1, C2.1, C5.1, C6.1, C7.1, D3.1, D4.1, J1.1, J1.2, J4.8, J5.2, J9.6, JS1.1, JS1.4, JS2.1, JS2.4, LS1.2, R1.2, R2.2, R4.1, RV1.1, RV2.1, U1.30, U2.7, U2.20, U3.9, U8.1
Button_A: J7.2, U3.24
Button_B: J7.8, U3.27
Button_DOWN: J8.6, U3.5
Button_LEFT: J8.8, U3.6
Button_RIGHT: J8.4, U3.4
Button_SELECT: J9.1, U3.8
Button_START: J9.3, U3.7
Button_UP: J8.2, U3.3
Button_X: J7.4, U3.25
Button_Y: J7.6, U3.26
Buzzer: U1.23, U5.2
Calib: J6.1, U2.6
Conn_LED_On: J9.2, U5.16
Connected: U1.24, U5.3
DC: J4.3, U1.8
GND: C1.2, C2.2, C5.2, C6.2, C7.2, J2.2, J3.2, J4.9, J6.2, J7.1, J8.1, J9.8, J10.1, JS1.3, JS1.6, JS1.9, JS2.3, JS2.6, JS2.9, RV1.3, RV2.3, U1.29, U2.8, U2.22, U3.10, U3.15, U3.16, U3.17, U5.9, U8.5, Y1.2
L_Bumper: J2.1, U3.1
L_joystick_analog_x: JS1.2, U2.26
L_joystick_analog_y: JS1.5, U2.25
L_trigger: RV1.2, U2.28
Left_joystick_button: JS1.8, U3.2
MISO: J4.7, U1.10
MOSI: J4.1, U1.15
unnamed: D3.2, LS1.1, R3.2
unnamed: D4.2, J5.1, R15.2
unnamed: R3.1, U5.17
unnamed: R4.2, U3.18
unnamed: R15.1, U5.18
unnamed: U2.9, Y1.3
unnamed: U2.10, Y1.1
OLEDCS: J4.5, U1.4
RESET: J4.4, U1.5
RX_Atmega: U2.2, U8.3
RX_ESP32: U1.6, U8.7
R_Bumper: J3.1, U3.28
R_joystick_analog_x: JS2.2, U2.23
R_joystick_analog_y: JS2.5, U2.24
R_trigger: RV2.2, U2.27
Right_joystick_button: JS2.8, U3.23
Rumble: U1.22, U5.1
SCK: J4.2, U1.9
SCL: R2.1, U2.12, U3.12
SDA: R1.1, U2.11, U3.13
SDCS: J4.6, U1.3
TX_Atmega: U2.3, U8.2
TX_ESP32: U1.7, U8.6
VCC_LED: J7.3, J8.3, J10.2
