JoanMaillard/Manette/07_Schémas/Manette_2019_boutons_centraux/Manette_2019_PCB_Central.kicad_pcb

## KiCad design 07_Schémas/Manette_2019_boutons_centraux/Manette_2019_PCB_Central.kicad_pcb (2019-05-17)

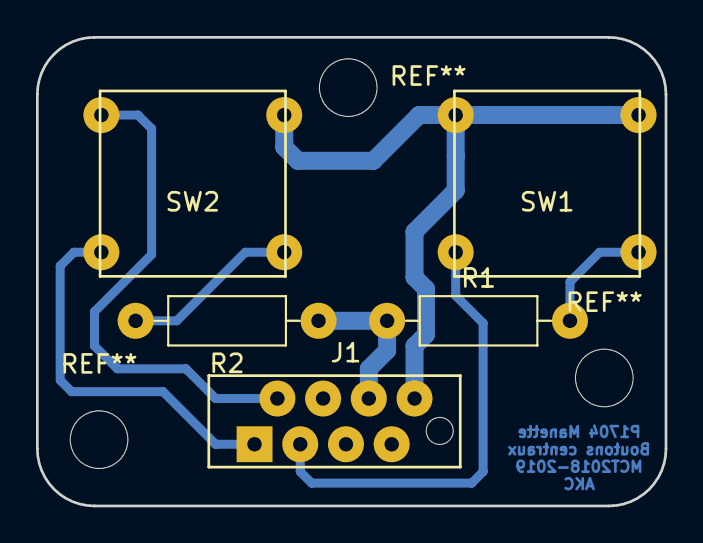
[picture p152: board Manette_2019_PCB_Central.kicad_pcb from above]

Board: 2 copper layers, 34.9 x 26.0 mm, 5 parts (0 on the bottom side), 7 nets.

Parts:
J1: Conn_Middle_PCB; Conn_8
R1, R2: R; R_Axial_DIN0207_L6.3mm_D2.5mm_P10.16mm_Horizontal
SW1: Button_Start; Bouton_MEC
SW2: Button_Select; Bouton_MEC

Connections:
+5V: J1.6, R1.1, R2.1
Conn_LED_On: J1.2, SW2.2
GND: J1.8, SW1.1, SW1.2, SW2.1
unnamed: R1.2, SW1.3
unnamed: R2.2, SW2.3
button_SELECT: J1.1, SW2.4
button_START: J1.3, SW1.4
