JoanMaillard/Manette/07_Schémas/PCB_test_NKK/PCB_test_NKK.kicad_pcb

## KiCad design 07_Schémas/PCB_test_NKK/PCB_test_NKK.kicad_pcb (2019-04-11)

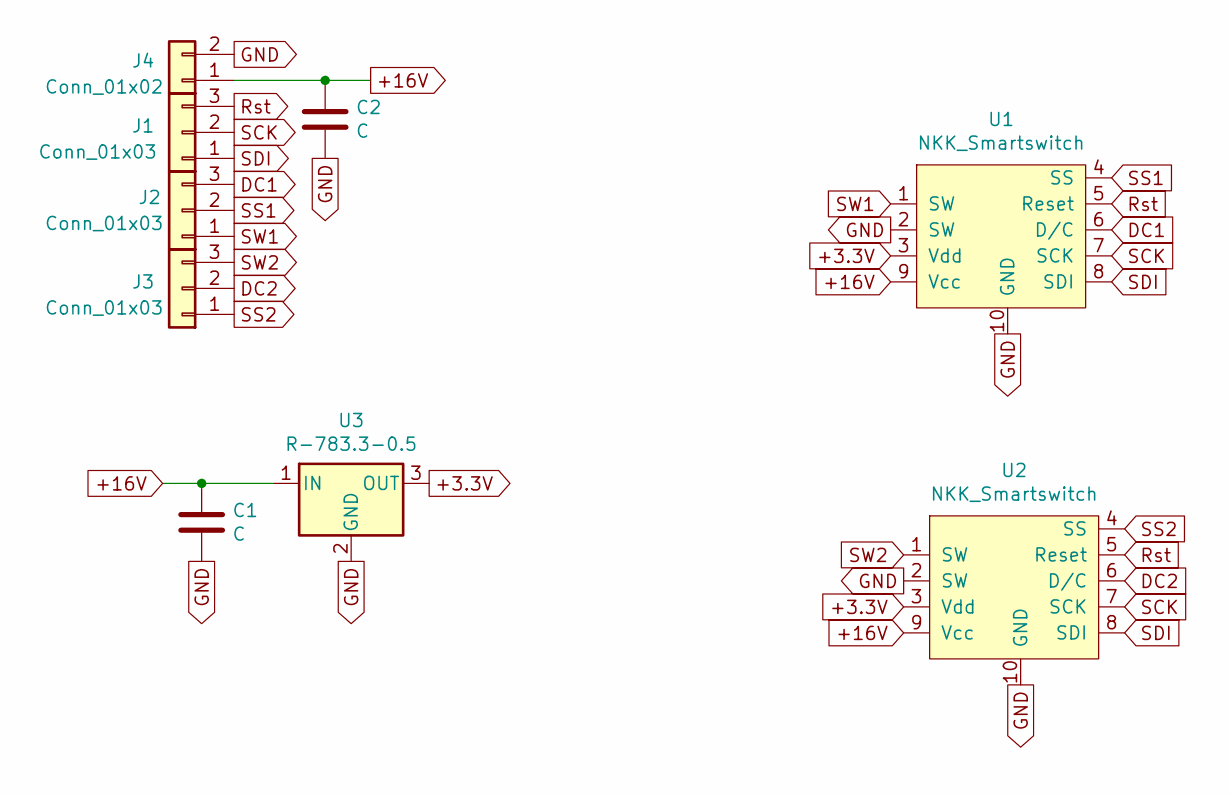
[picture p153: schematic PCB_test_NKK.sch]

Parts:
C1: C; C_Rect_L7.2mm_W3.5mm_P5.00mm_FKS2_FKP2_MKS2_MKP2
C2: C; CP_Radial_D10.0mm_P5.00mm
J1, J2, J3: Conn_01x03; TerminalBlock_Phoenix_MPT-0,5-3-2.54_1x03_P2.54mm_Horizontal
J4: Conn_01x02; TerminalBlock_Phoenix_MPT-0,5-2-2.54_1x02_P2.54mm_Horizontal
U1, U2: NKK_Smartswitch; NKK_Switch
U3: R-783.3-0.5; Converter_DCDC_RECOM_R-78E-0.5_THT

Connections:
+3.3V: U1.3 (Vdd), U2.3 (Vdd), U3.3 (OUT)
+16V: C1.1, C2.1, J4.1, U1.9 (Vcc), U2.9 (Vcc), U3.1 (IN)
DC1: J2.3, U1.6 (D/C)
DC2: J3.2, U2.6 (D/C)
GND: C1.2, C2.2, J4.2, U1.2 (SW), U1.10 (GND), U2.2 (SW), U2.10 (GND), U3.2 (GND)
Rst: J1.3, U1.5 (Reset), U2.5 (Reset)
SCK: J1.2, U1.7 (SCK), U2.7 (SCK)
SDI: J1.1, U1.8 (SDI), U2.8 (SDI)
SS1: J2.2, U1.4 (SS)
SS2: J3.1, U2.4 (SS)
SW1: J2.1, U1.1 (SW)
SW2: J3.3, U2.1 (SW)

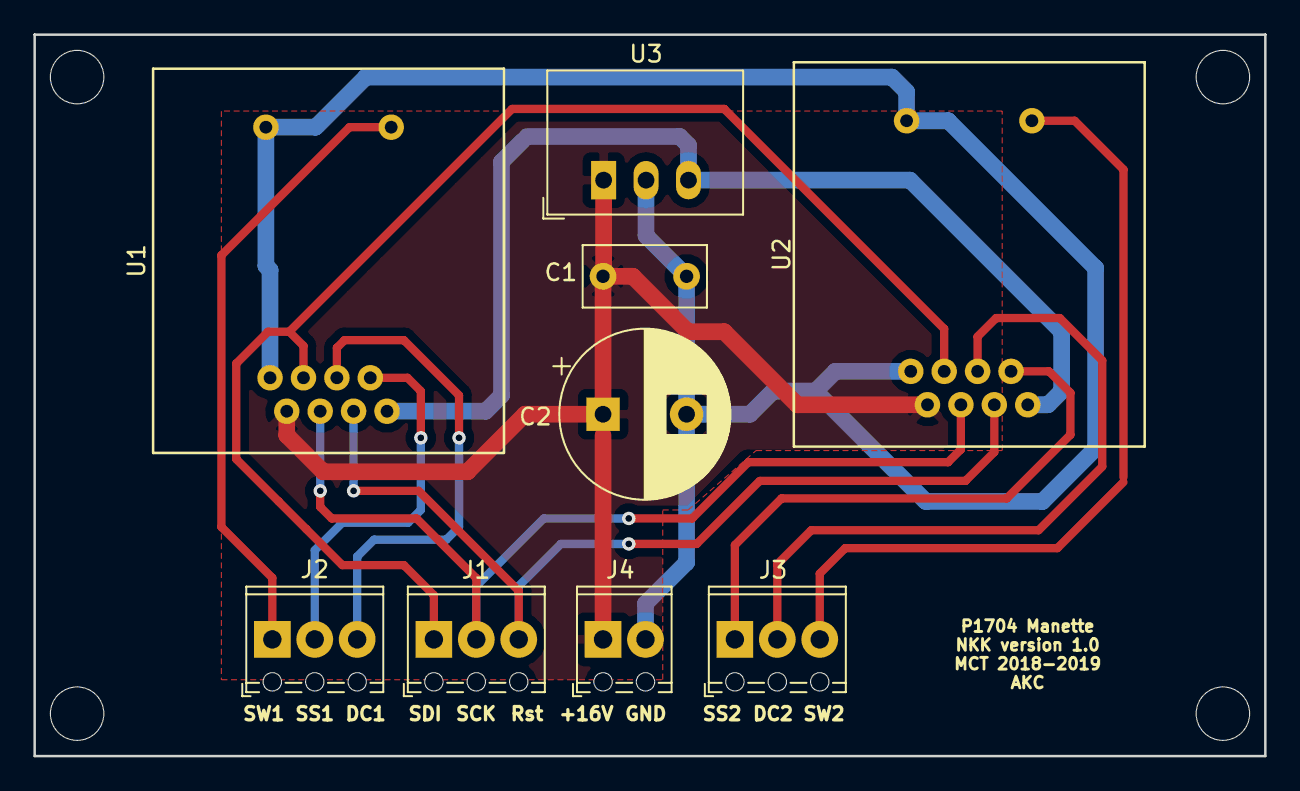
[picture p154: board PCB_test_NKK.kicad_pcb from above]

Board: 2 copper layers, 73.7 x 43.2 mm, 9 parts (0 on the bottom side), 12 nets.
