JoanMaillard/Manette/07_Schémas/Polymanette Table à lévitation/Manette_Chevaliers.kicad_pcb

## KiCad design 07_Schémas/Polymanette Table à lévitation/Manette_Chevaliers.kicad_pcb (2019-03-04)

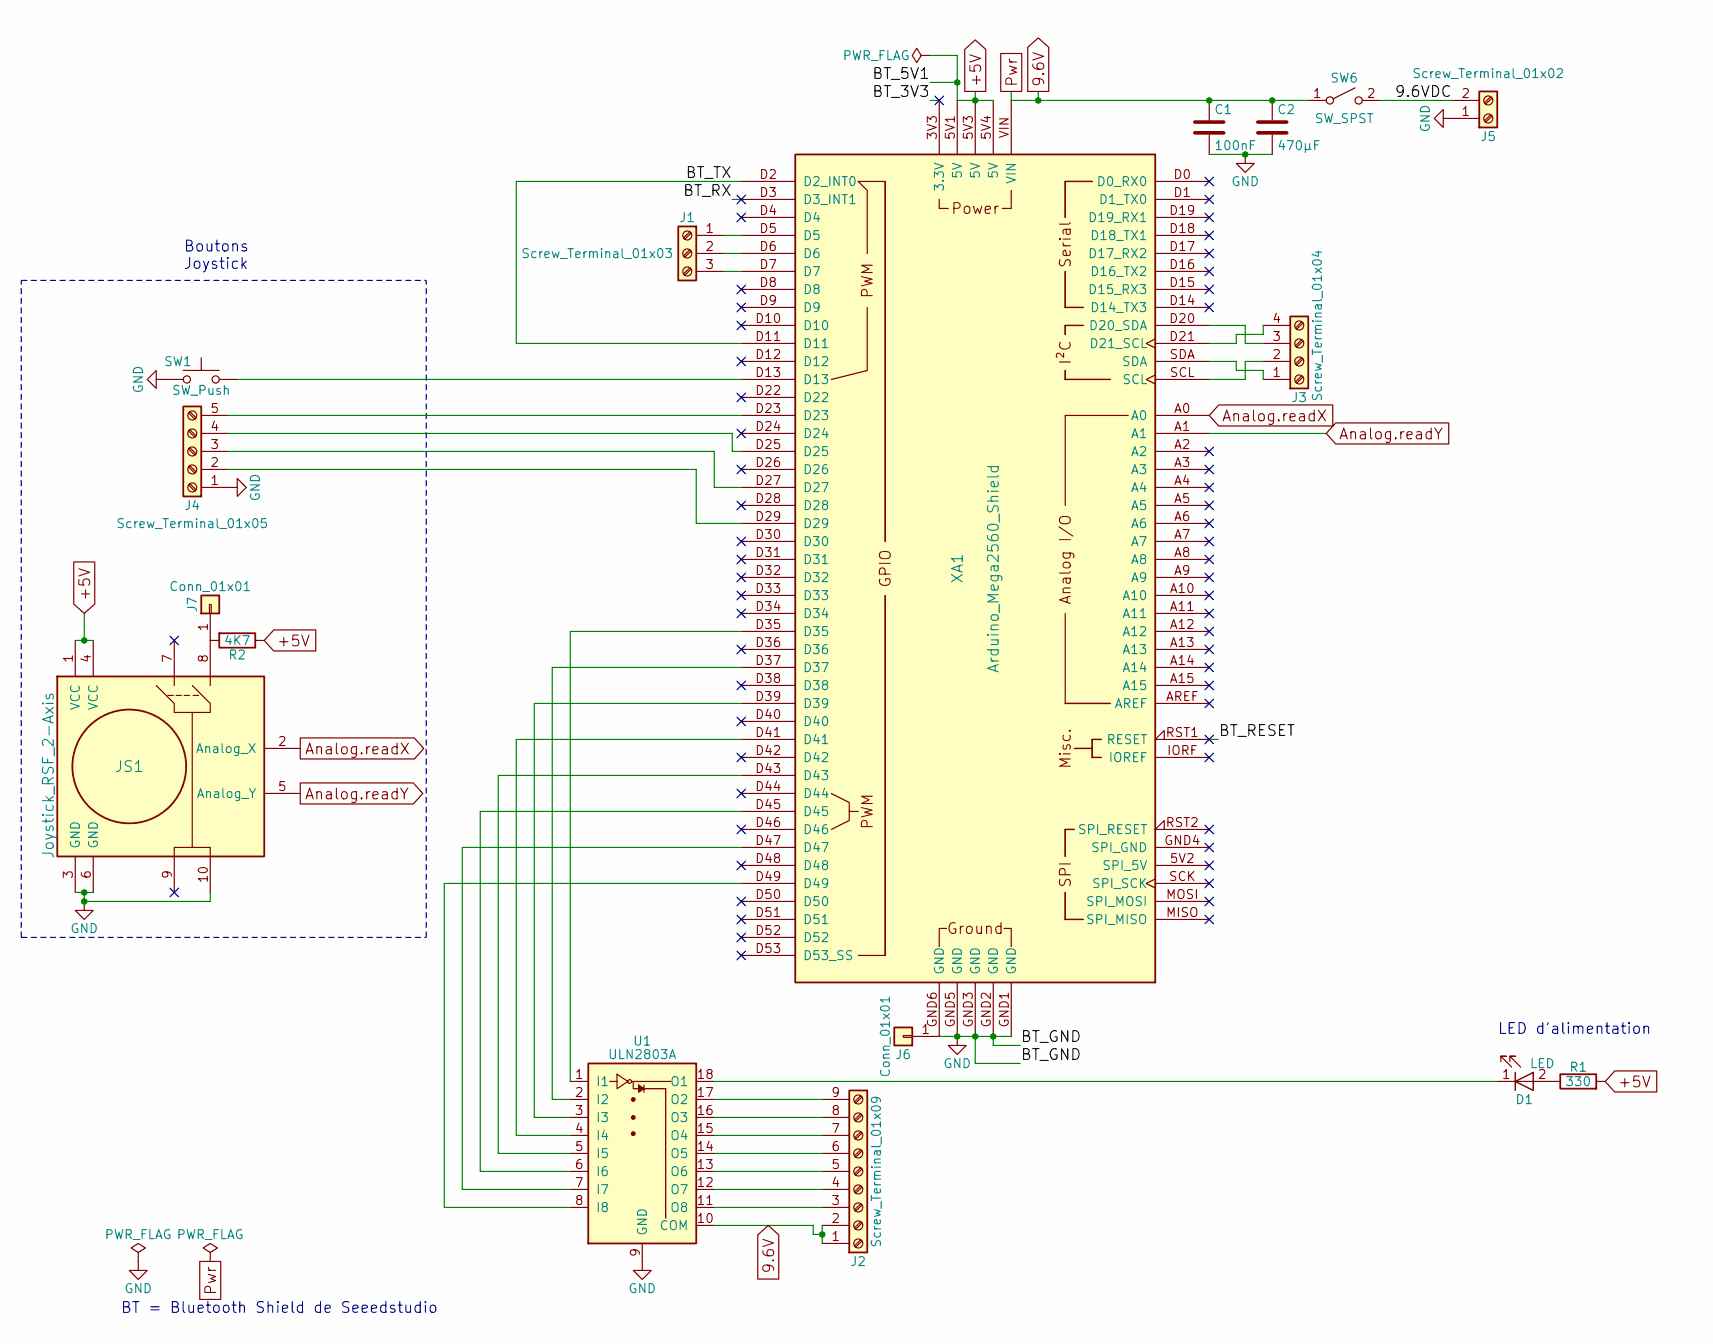
[picture p155: schematic Manette_Chevaliers.sch, Polymanette table à lévitation CORRIGÉ]

Parts:
C1: 100nF; C_Rect_L7.2mm_W2.5mm_P5.00mm_FKS2_FKP2_MKS2_MKP2
C2: 470µF; CP_Radial_Couchée_D10.0mm_P5.00mm
D1: LED; LED_D3.0mm
J1: Screw_Terminal_01x03; Screw_terminal_3_P2.54mm
J2: Screw_Terminal_01x09; Screw_terminal_3x3_P2.54mm
J3: Screw_Terminal_01x04; Screw_terminal_2x2_P2.54mm
J4: Screw_Terminal_01x05; Screw_terminal_2x3_P2.54mm
J5: Screw_Terminal_01x02; TerminalBlock_bornier-2_P5.08mm
J6, J7: Conn_01x01; Pad
JS1: Joystick_RSF_2-Axis; Joystick_RSF_2-axis
R1: 330; R_Axial_DIN0207_L6.3mm_D2.5mm_P10.16mm_Horizontal
R2: 4K7; R_Axial_DIN0207_L6.3mm_D2.5mm_P10.16mm_Horizontal
SW1: SW_Push; Switch_AS11CH
SW6: SW_SPST; Switch_AS11CH
U1: ULN2803A; ULN2803a
XA1: Arduino_Mega2560_Shield

Connections:
9.6V: C1.1, C2.1, J2.1, J2.2, SW6.1 (A), U1.10 (COM), XA1.VIN
+5V: JS1.1 (VCC), JS1.4 (VCC), R1.2, R2.1, XA1.5V1 (5V), XA1.5V3 (5V), XA1.5V4 (5V)
/9.6VDC: J5.2, SW6.2 (B)
/BT_3V3: XA1.3V3 (3.3V)
/BT_RESET: XA1.RST1 (RESET)
/BT_RX: XA1.D3 (D3_INT1)
/BT_TX: XA1.D2 (D2_INT0), XA1.D11
Analog.readX: JS1.2 (Analog_X), XA1.A0
Analog.readY: JS1.5 (Analog_Y), XA1.A1
GND: C1.2, C2.2, J4.1, J5.1, J6.1, JS1.3 (GND), JS1.6 (GND), JS1.10, SW1.2, U1.9 (GND), XA1.GND1 (GND), XA1.GND2 (GND), XA1.GND3 (GND), XA1.GND5 (GND), XA1.GND6 (GND)
unnamed: D1.1 (K), U1.18 (O1)
unnamed: D1.2 (A), R1.1
unnamed: J1.1, XA1.D5
unnamed: J1.2, XA1.D6
unnamed: J1.3, XA1.D7
unnamed: J2.3, U1.11 (O8)
unnamed: J2.4, U1.12 (O7)
unnamed: J2.5, U1.13 (O6)
unnamed: J2.6, U1.14 (O5)
unnamed: J2.7, U1.15 (O4)
unnamed: J2.8, U1.16 (O3)
unnamed: J2.9, U1.17 (O2)
unnamed: J3.1, XA1.SDA
unnamed: J3.2, XA1.SCL
unnamed: J3.3, XA1.D20 (D20_SDA)
unnamed: J3.4, XA1.D21 (D21_SCL)
unnamed: J4.2, XA1.D29
unnamed: J4.3, XA1.D27
unnamed: J4.4, XA1.D25
unnamed: J4.5, XA1.D23
unnamed: J7.1, JS1.8, R2.2
unnamed: SW1.1, XA1.D13
unnamed: U1.1 (I1), XA1.D35
unnamed: U1.2 (I2), XA1.D37
unnamed: U1.3 (I3), XA1.D39
unnamed: U1.4 (I4), XA1.D41
unnamed: U1.5 (I5), XA1.D43
unnamed: U1.6 (I6), XA1.D45
unnamed: U1.7 (I7), XA1.D47
unnamed: U1.8 (I8), XA1.D49

Notes on the sheet:
Boutons Joystick
BT = Bluetooth Shield de Seeedstudio
LED d'alimentation

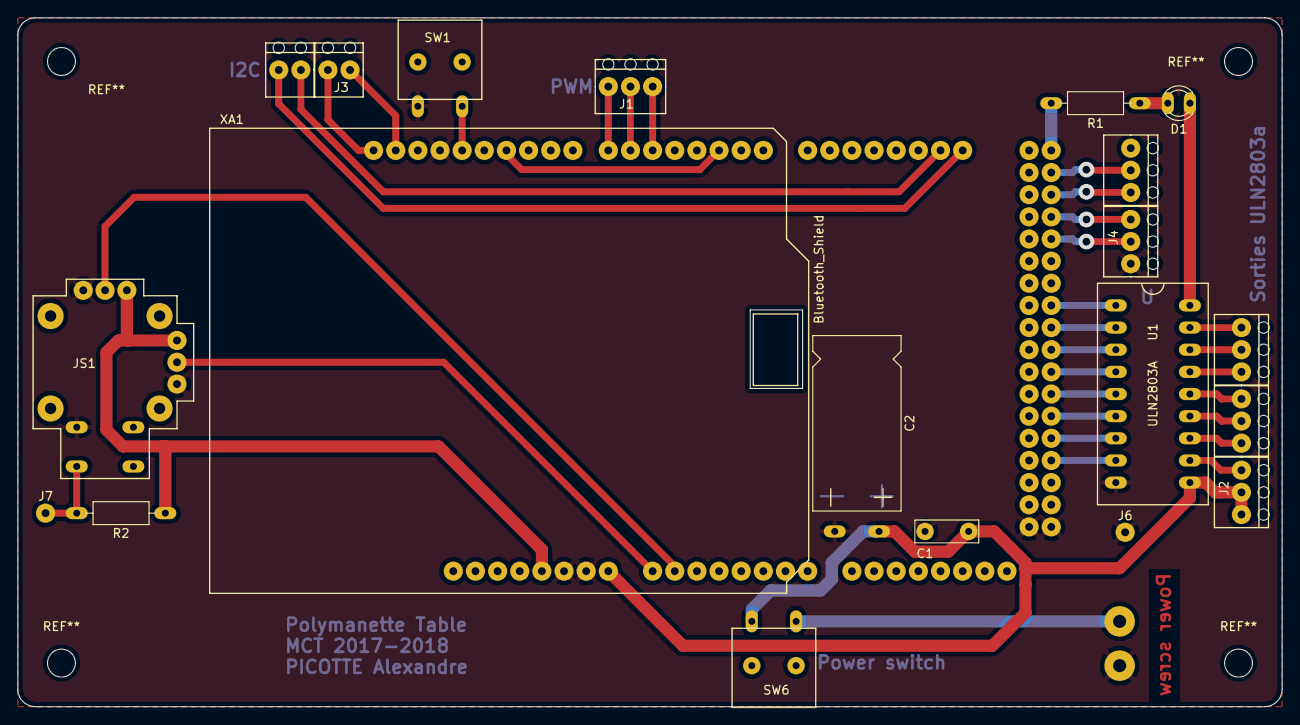
[picture p156: board Manette_Chevaliers.kicad_pcb from above]

Board: 2 copper layers, 145.0 x 79.0 mm, 17 parts (1 on the bottom side), 37 nets.
