JoanMaillard/Manette/07_Schémas/PCB Boutons/Boutons.kicad_pcb

## KiCad design 07_Schémas/PCB Boutons/Boutons.kicad_pcb (2019-03-04)

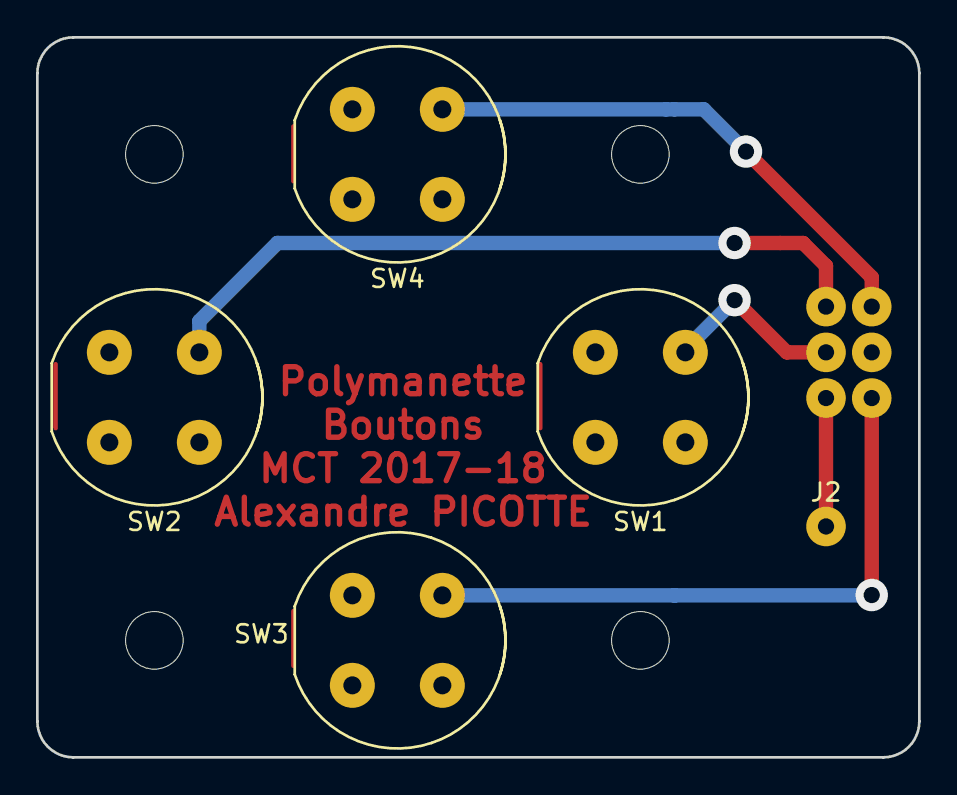
[picture p157: board Boutons.kicad_pcb from above]

Board: 2 copper layers, 49.0 x 40.0 mm, 6 parts (1 on the bottom side), 5 nets.

Parts:
J1: Conn_01x06_Male; Conn_Grove_6_pôles
J2: Conn_01x01; Pad
SW1, SW2, SW3, SW4: SW_Push; Switch_D6R

Connections:
/GND: J1.1, J2.1, SW1.2, SW2.2, SW3.2, SW4.2
unnamed: J1.2, SW1.1
unnamed: J1.3, SW2.1
unnamed: J1.4, SW3.1
unnamed: J1.6, SW4.1
