JoanMaillard/Manette/07_Schémas/Manette_arcade/rescue-backup/Console-2019-03-19-13-50-06.sch

## KiCad design 07_Schémas/Manette_arcade/rescue-backup/Console-2019-03-19-13-50-06.sch (2019-03-04)

Schematic: Console-2019-03-19-13-50-06.sch

Parts:
J2: DB9_Male
XA2: Arduino_Leonardo_Shield

Notes on the sheet:
Alimentation et communication avec Raspberry Pi via port USB
