JoanMaillard/Manette/07_Schémas/Manette_arcade/rescue-backup/Manette_arcade-2019-03-19-13-50-06.sch

## KiCad design 07_Schémas/Manette_arcade/rescue-backup/Manette_arcade-2019-03-19-13-50-06.sch (2019-03-04)

Schematic: Manette_arcade-2019-03-19-13-50-06.sch

Parts:
J1: DB9_Male
SW1, SW2, SW3, SW4, SW5, SW6, SW7, SW8, SW9, SW10, SW11, SW12: SW_Push
SW13: SW_LED
XA1: Arduino_Uno_Shield
