JoanMaillard/Manette/08_Programmes/Manette chevalier ancienne version/Master_button/Master_button.ino

/*
 * FM.h
 * A library for SeeedStudio Grove FM
 *
 * Copyright (c) 2012 seeed technology inc.
 * Website    : www.seeed.cc
 * Author     : Steve Chang
 * Create Time: JULY 2014
 * Change Log : Modified by loovee 2013-10-29  ,   Modified by jacob yan 2014-7-29 
 
 * The MIT License (MIT)
 *
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
 * THE SOFTWARE IS PROVIDED "AS IS", WITHOUT WARRANTY OF ANY KIND, EXPRESS OR
 * IMPLIED, INCLUDING BUT NOT LIMITED TO THE WARRANTIES OF MERCHANTABILITY,
 * FITNESS FOR A PARTICULAR PURPOSE AND NONINFRINGEMENT. IN NO EVENT SHALL THE
 * AUTHORS OR COPYRIGHT HOLDERS BE LIABLE FOR ANY CLAIM, DAMAGES OR OTHER
 * LIABILITY, WHETHER IN AN ACTION OF CONTRACT, TORT OR OTHERWISE, ARISING FROM,
 * OUT OF OR IN CONNECTION WITH THE SOFTWARE OR THE USE OR OTHER DEALINGS IN
 * THE SOFTWARE.
 */

#include <SoftwareSerial.h>                         // Software Serial Port

#define RxD         11
#define TxD         3

#define PINBUTTON   9                               // pin of button

#define DEBUG_ENABLED  1



SoftwareSerial blueToothSerial(RxD,TxD);

void setup()
{
    Serial.begin(9600);
    pinMode(RxD, INPUT);
    pinMode(TxD, OUTPUT);
    pinMode(PINBUTTON, INPUT);
    
    setupBlueToothConnection();
    //wait 1s and flush the serial buffer
    delay(1000);
    Serial.println("OK");
    Serial.flush();
    blueToothSerial.flush();
}

void loop()
{
    
    static unsigned char state = 0;             // led off
    
    if(digitalRead(PINBUTTON))
    {
        state = 1-state;
        
        Serial.println("button on");
        
        blueToothSerial.print(state);
        
        delay(10);
        while(digitalRead(PINBUTTON))       // until button release
        {
            delay(10);
        }
        
        Serial.println("button off");
    }
}

/***************************************************************************
 * Function Name: setupBlueToothConnection
 * Description:  initilizing bluetooth connction
 * Parameters: 
 * Return: 
***************************************************************************/
void setupBlueToothConnection()
{

	
    blueToothSerial.begin(9600);  
	
	blueToothSerial.print("AT");
	delay(400); 
	
	//blueToothSerial.print("AT+DEFAULT");             // Restore all setup value to factory setup
	//delay(2000); 
	
	blueToothSerial.print("AT+NAMESeeedMaster");    // set the bluetooth name as "SeeedMaster" ,the length of bluetooth name must less than 12 characters.
	delay(400);
	
	blueToothSerial.print("AT+ROLEM");             // set the bluetooth work in slave mode
	delay(400); 
	blueToothSerial.print("AT+PIN1983");             // set the pair code to connect 
  delay(400);
	
	blueToothSerial.print("AT+AUTH1");            
    delay(400);    
	
	blueToothSerial.print("AT+CLEAR");             // Clear connected device mac address
    delay(400);   
	
    blueToothSerial.flush();
	
	
}
