JoanMaillard/Manette/08_Programmes/Manette chevalier ancienne version/Manette_Mega_Bluetooth/Manette.cpp

#include "Manette.h"

Manette::Manette()
{

}

void Manette::init() {
  Serial.println(__PRETTY_FUNCTION__);

  //m_communicationProtocol->addPacketID("Config");
  m_communicationProtocol->addPacketID("Game");
  m_communicationProtocol->addPacketID("Contact"); /**< Relatif aux plaques de contact et au bouclier */
  m_communicationProtocol->addPacketID("Motors"); /**< Relatif aux moteurs (PWM, position x et y du joystick..) */
  m_communicationProtocol->addPacketID("Head"); /**< Relatif aux yeux et au son */
 
  /**< On envoie la liste des packets ci-dessus au receveur. */
  //sendPacketIDListToReceiver();
}

void Manette::sendPacketIDListToReceiver() {
  PRINTLN(__PRETTY_FUNCTION__);
  m_communicationProtocol->clearData("Config");


  for (int i = 0; i < m_communicationProtocol->getNumberOfPacketID(); i++) {
    m_communicationProtocol->addData("Config", m_communicationProtocol->getPacketsIDList()[i].name.c_str());
    if (i != m_communicationProtocol->getNumberOfPacketID() - 1)
      m_communicationProtocol->addData("Config", ",");
  }

  m_communicationProtocol->send("Config");
}

void Manette::sendActivateProtection() {
  PRINTLN(__PRETTY_FUNCTION__);
  m_communicationProtocol->clearData("Contact");
  m_communicationProtocol->addData("Contact", "ShieldUp"); /**< On ajoute le texte "ProtectionActivated" dans le buffer */
  m_communicationProtocol->send("Contact");
}

void Manette::sendDesactivateProtection() {
  PRINTLN(__PRETTY_FUNCTION__);
  m_communicationProtocol->clearData("Contact");
  m_communicationProtocol->addData("Contact", "ShieldDown"); /**< On ajoute le texte "ProtectionActivated" dans le buffer */
  m_communicationProtocol->send("Contact");
}

void Manette::sendPauseGame() {
  PRINTLN(__PRETTY_FUNCTION__);
  m_communicationProtocol->clearData("Game");
  m_communicationProtocol->addData("Game", "Pause"); /**< On ajoute le texte "Pause" dans le buffer */
  m_communicationProtocol->send("Game");
}

void Manette::sendGameOver() {
  PRINTLN(__PRETTY_FUNCTION__);
  m_communicationProtocol->clearData("Game");
  m_communicationProtocol->addData("Game", "Over"); /**< On ajoute le texte "Pause" dans le buffer */
  m_communicationProtocol->send("Game");
}


void Manette::sendRestartGame() {
  PRINTLN(__PRETTY_FUNCTION__);
  m_communicationProtocol->clearData("Game");
  m_communicationProtocol->addData("Game", "Restart"); /**< On ajoute le t                                                  exte "Restart" dans le buffer */
  m_communicationProtocol->send("Game");
}

void Manette::sendConnectionRequest() {
  PRINTLN(__PRETTY_FUNCTION__);
  m_communicationProtocol->clearData("Game");
  m_communicationProtocol->addData("Game", "ConRequest"); /**< On ajoute le t                                                  exte "Restart" dans le buffer */
  m_communicationProtocol->send("Game");
}

void Manette::sendLostGame() {
  m_communicationProtocol->clearData("Game");
  m_communicationProtocol->addData("Game", "LostGame"); /**< On ajoute le texte "LostGame" dans le buffer */
  m_communicationProtocol->send("Game");
}

void Manette::sendGameMode(int gameModeNumber) {
  PRINTLN(__PRETTY_FUNCTION__);
  char gameModeIntInText[33];
  itoa(gameModeNumber, gameModeIntInText, 10); /**<  Converti le int gameModeNumber en texte et le met dans gameModeIntInText*/

  m_communicationProtocol->clearData("Game");
  m_communicationProtocol->addData("Game", "GameMode="); /**< On ajoute le texte "GameMode=" dans le buffer */
  m_communicationProtocol->addData("Game", gameModeIntInText);
  m_communicationProtocol->send("Game");

  PRINT("gameModeIntInText vaut");
  PRINT(gameModeIntInText);
}

void Manette::sendJoystickPosition(int x, int y) {
  //Serial.println(__PRETTY_FUNCTION__);
  string posX = string(x, DEC);
  string posY = string(y, DEC);
  /*
      Serial.print("posX: ");
      Serial.print(posX);
      Serial.print(" posY: ");
      Serial.println(posY);
  */
  m_communicationProtocol->clearData("Motors");
  //Serial.println("ClearData done");
  m_communicationProtocol->addData("Motors", posX.c_str()); /**< On lui envoie la position X */
  //Serial.println("addData motors posX done");
  m_communicationProtocol->addData("Motors", ",");
  //Serial.println("addData motors virgule done");
  m_communicationProtocol->addData("Motors", posY.c_str());
  //Serial.println("addData motors posy done");

  /*Serial.print("ToSend : ");
    Serial.println((char*)m_communicationProtocol->allData("Motors"));*/

  m_communicationProtocol->send("Motors");
}

void Manette::addCommunicationProtocolParent(CommunicationProtocol *communicationProtocol) {
  this->m_communicationProtocol = communicationProtocol;
}

Manette::~Manette()
{
  //dtor
}
