JoanMaillard/Manette/08_Programmes/TESTS/MANETTE_CHEVALIERS/pjon_testBluM/pjon_testBluM.ino

#include <SoftwareSerial.h>
#include <PJON.h>

byte header = 0xAA;
byte test_header;
bool sucess = false;
bool first = true;
bool blu_done = false;
bool PComm = false;
bool pp = false;
int avail;
unsigned long chrono;
unsigned long last_chrono;
#define waiting 3000

#define RxD         11 //il s'agit du pin 2 sur le shield mais à cause du mega il faut le relier au pin 11
#define TxD         3
#define bouton      22
SoftwareSerial blueToothSerial(RxD, TxD);
PJON<ThroughSerial> bus(45);

void setup() {
  // put your setup code here, to run once:
  pinMode(RxD, INPUT);
  pinMode(TxD, OUTPUT);
  pinMode(bouton, INPUT_PULLUP);
  blueToothSerial.begin(9600);
  Serial.begin(9600);
  //blueToothSerial.flush();
  chrono = millis();
  last_chrono = chrono;
  Serial.println("begin");

  /*
    // Pass the blueToothSerial Serial instance you want to use for PJON communication
    bus.strategy.set_serial(&blueToothSerial);

    // Avoid synchronous acknowledgement
    bus.set_synchronous_acknowledge(false);

    bus.begin();
  */
  // Pass the blueToothSerial Serial instance you want to use for PJON communication
  bus.strategy.set_serial(&blueToothSerial);
  // Run in bi-directional PJON_HALF_DUPLEX mode
  bus.set_communication_mode(PJON_HALF_DUPLEX);
  // Avoid synchronous acknowledgement
  bus.set_synchronous_acknowledge(false);

  bus.begin();
  bus.set_receiver(receiver_function);
}

void receiver_function(uint8_t *payload, uint16_t length, const PJON_Packet_Info &packet_info) {
  // Make use of the payload before sending something, the buffer where payload points to is
  // overwritten when a new message is dispatched

}
void loop() {
  // put your main code here, to run repeatedly:
  if (blu_done && !PComm) {
    if (!pp) {
      if (chrono - last_chrono >= waiting) {
        pp = true;
        bus.update();
        if (bus.send_packet(44, "All is ok?!", 11) == PJON_ACK) {
          Serial.println("44 is ok!");
          PComm = true;
        }
      }
    }
    if (pp) {
      bus.update();
      if (bus.send_packet(44, "All is ok?!", 11) == PJON_ACK) {
        Serial.println("44 is ok!");
        PComm = true;
      }
    }
  }
  chrono = millis();
  if (!blu_done) {
    if (!sucess) {
      if (first || chrono - last_chrono >= waiting) {
        Serial.println("send");
        first = false;
        last_chrono = chrono;
        blueToothSerial.write(header);
      }
      if (blueToothSerial.available() > 0) {
        Serial.println("receive");
        test_header = blueToothSerial.read();
        if (test_header == header) {
          sucess = true;
        }
      }
    }
    if (sucess) {
      Serial.println("ok");
      //sucess = false;
      blu_done = true;
      first = true;
      last_chrono = chrono;
    }
  }
  if (blu_done && PComm) {
    bus.update();

    bus.receive();


    if (bus.send_packet(44, "All is ok?!", 11) == PJON_ACK) {
      Serial.println("44 is ok!");
    }
    if (bus.send_packet(44, "All is ok?!", 11) == PJON_BUSY) {
      Serial.println("44 is busy!");
    }
    if (bus.send_packet(44, "All is ok?!", 11) == PJON_FAIL) {
      Serial.println("44 failed!");
    }
    while(blueToothSerial.available() > 0){
      char c = blueToothSerial.read();
      Serial.println(c);
    }
  }
  /*
    avail = blueToothSerial.available();
    Serial.println(avail);
  */
}
