JoanMaillard/Manette/(commit log)

2019-03-04 Initial commit
    Initial commit
    [AS11CH.0002.idw, AS11CH.iam, AS11CH.idw, AS11CHcright.ipt, AS11CHra1.ipt, AS11CHright1.ipt, AS11CHright12.ipt, AS11CHtrh.ipt]
2019-03-04 Create Journal de travail Joan.txt
2019-03-04 Create rapport de décision module Bluetooth.txt
2019-03-04 schéma
    [manette_2019.kicad_pcb, manette_2019.sch]
2019-03-05 Update rapport de décision module Bluetooth.txt
2019-03-05 Update Journal de travail Joan.txt
2019-03-07 update schéma
    [Manette_Chevaliers-2019-03-07-08-55-50.sch, manette_2019.sch]
2019-03-07 schéma update
    [Manette_Chevaliers-2019-03-07-09-23-46.sch, Manette_Chevaliers-2019-03-07-09-37-47.sch, manette_2019.sch]
2019-03-07 test code modified
    New code for 2 buttons and 1 potentiometer through Serial
2019-03-07 Optimization of test code (8 buttons to 1 byte)
2019-03-07 Started schéma pour le test bench, cahier des charges
    [manette_2019.sch, manette_2019_testBench.kicad_pcb, manette_2019_testBench.sch]
2019-03-11 Cahier des charges
    [manette_2019.sch]
2019-03-11 update txt cahier des charges, plan projet MS Project
2019-03-11 Update 2019 Cahier des charges P1704 .docx
2019-03-12 Merge-fix commit
    [manette_2019.sch]
2019-03-12 Update plan de projet
2019-03-14 Cahier des charges intergroupe; save as XML des documents word
2019-03-19 Update test_serial_sender.ino
    Added calibration routine
2019-03-21 Added per-direction calibration for good axis centering
2019-03-22 correct esp device names
2019-03-25 update schema
    [manette_2019.sch]
2019-03-26 update code ESP for BT 33Hz
2019-04-04 added a button
2019-04-08 Ajout librairies dans les dossiers de code; doc
2019-04-08 Added ESP tests tick chart
    [Bilans de consommation.xlsx, Tests Arduino_ESP32.xlsx]
2019-04-11 finished pcb_nkk
    [PCB_test_NKK.kicad_pcb]
2019-04-11 Create rapport de décision gâchettes.txt
2019-04-29 started 3D
    [P1704_002_mainDroite.0006.ipt, P1704_002_mainDroite.ipt, P1704_003_mainDroite.0001.ipt, P1704_003_mainGauche.0007.ipt, P1704_003_mainGauche.ipt, P1704_E001.0002.iam, P1704_E001.iam, P1794_001_basManette.0002.ipt]
2019-05-07 Plans et data movement
    [Commande_P1704_2019.xlsx, Commande_boutons.xlsx, Manette_2019_PCB_Central.kicad_pcb, Manette_2019_PCB_Central.sch, P1704_001_basManette.0001.idw, P1704_001_basManette.0002.idw, P1704_001_basManette.0012.ipt, P1704_001_basManette.idw]
2019-05-13 transfer mods
    [P1704_001_basManette.0013.ipt, P1704_001_basManette.ipt]
2019-05-17 Code de test boutons NKK
2019-05-23 3D et ppt esp32
    [P1704_013_Switch.ipt, P1704_014_Display.0001.ipt, P1704_014_Display.ipt, P1704_015_rumble.ipt, P1704_016_Button.ipt]
2019-05-24 update accu data, journal de travail
2019-06-13 Added appendix cahier des charges
2019-06-13 Commenting, parenthesis staging corrections
    [BLE_client_arcade.ino, BLE_server_arcade.ino, Leonardo.ino]
2019-06-17 mod 3d
    [P1704_001_basManette.0010.idw, P1704_001_basManette.0013.idw, P1704_001_basManette.0029.ipt, P1704_001_basManette.0030.ipt, P1704_001_basManette.idw, P1704_001_basManette.ipt, P1704_003_mainGaucheInterieur.0006.ipt, P1704_003_mainGaucheInterieur.0007.ipt]
2019-06-29 Update data_gatherer.ino
    Added remapping des boutons pour correspondre à la manette breadboard
